cbuil06/tse/TSE_exemples.pdf

# TinyStar’Ex

# Exemples de spectres

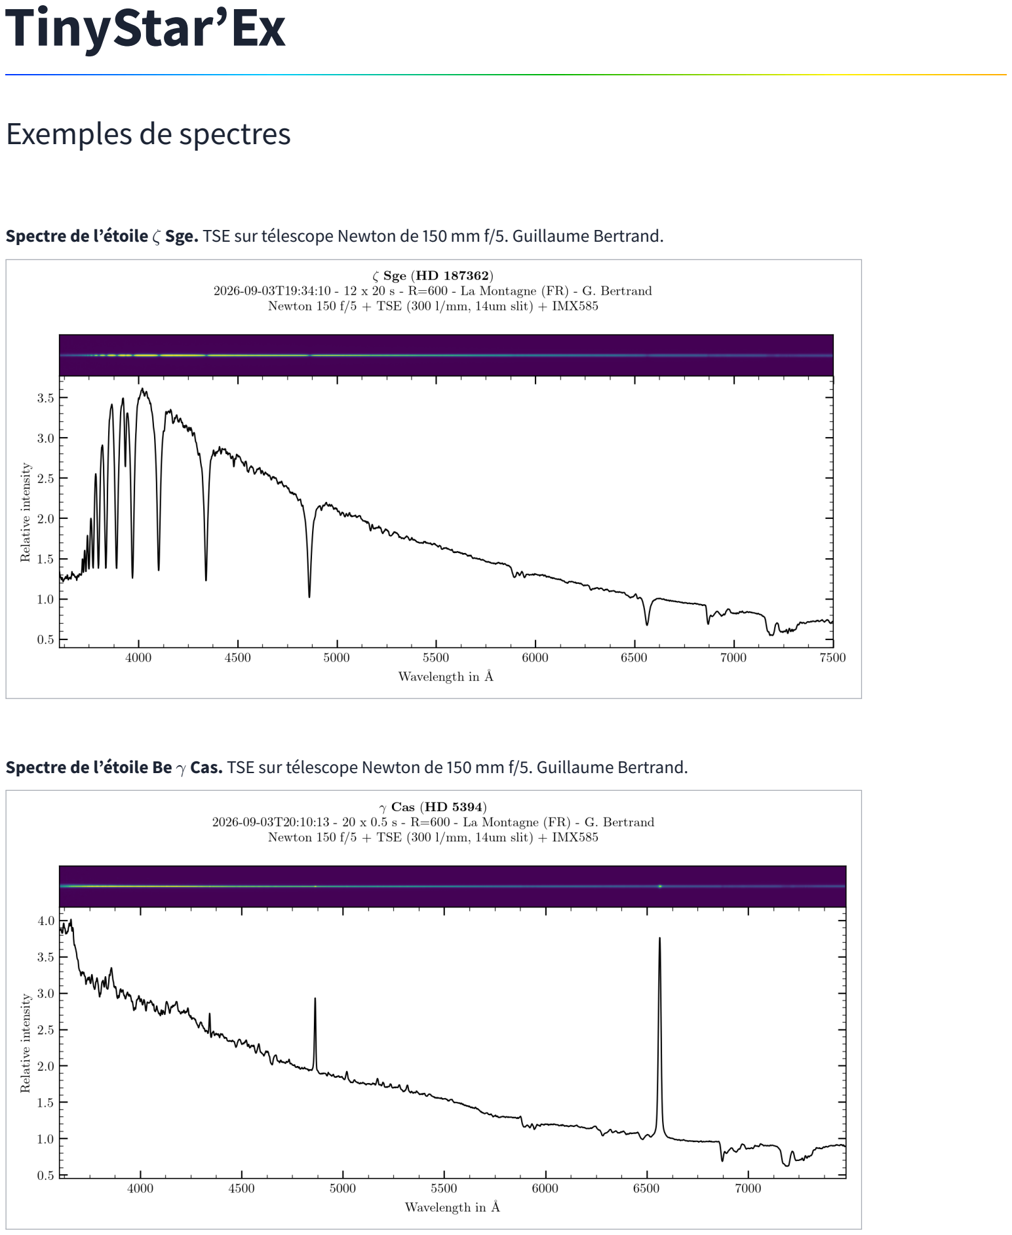
[picture p1: page 1]

Spectre de l’étoile ζ Sge. TSE sur télescope Newton de 150 mm f/5. Guillaume Bertrand.

Spectre de l’étoile Be γ Cas. TSE sur télescope Newton de 150 mm f/5. Guillaume Bertrand.

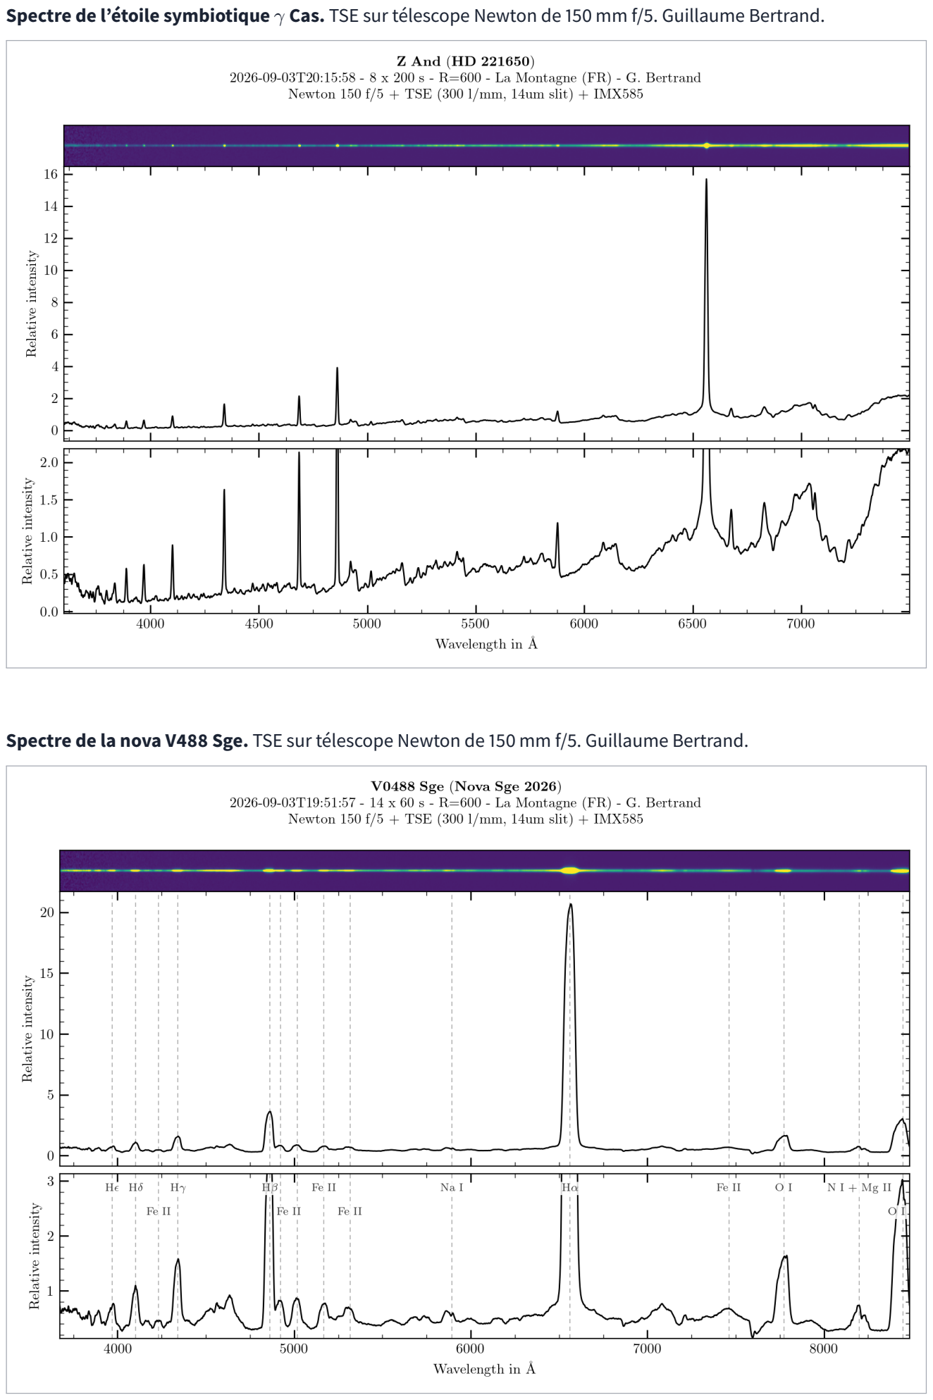
[picture p2: page 2]

Spectre de l’étoile symbiotique γ Cas. TSE sur télescope Newton de 150 mm f/5. Guillaume Bertrand.

Spectre de la nova V488 Sge. TSE sur télescope Newton de 150 mm f/5. Guillaume Bertrand.

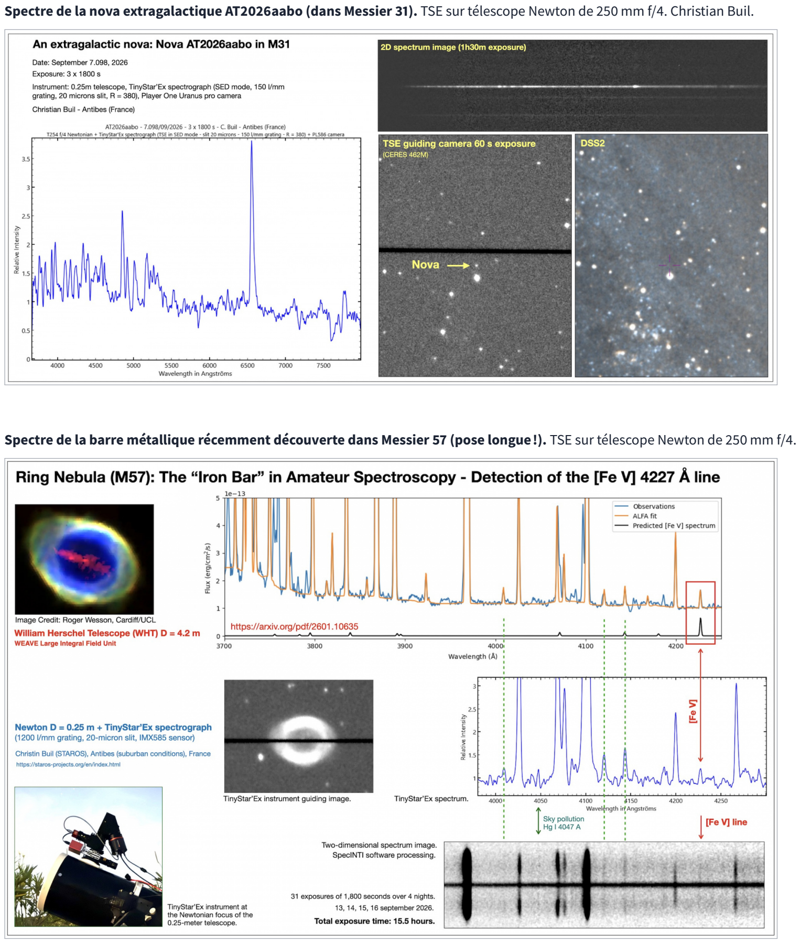
[picture p3: page 3]

Spectre de la nova extragalactique AT2026aabo (dans Messier 31). TSE sur télescope Newton de 250 mm f/4. Christian Buil.

Spectre de la barre métallique récemment découverte dans Messier 57 (pose longue !). TSE sur télescope Newton de 250 mm f/4.

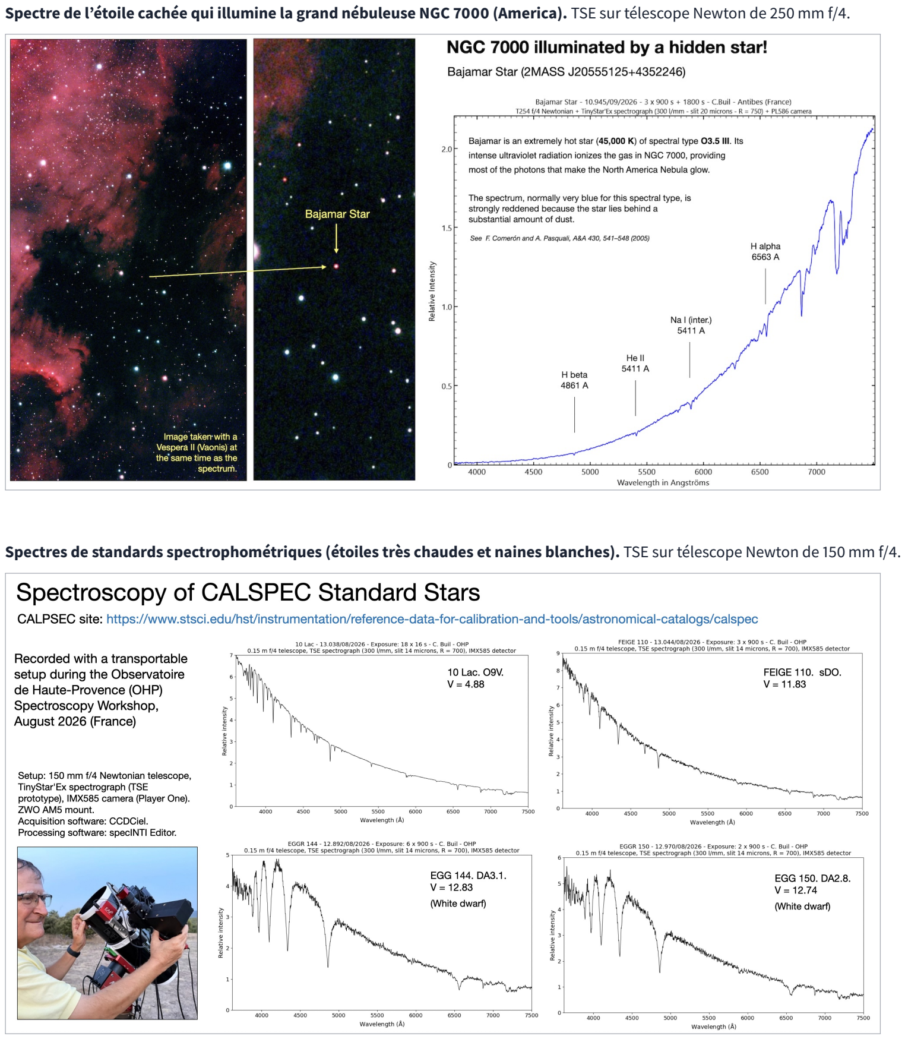
[picture p4: page 4]

Spectre de l’étoile cachée qui illumine la grand nébuleuse NGC 7000 (America). TSE sur télescope Newton de 250 mm f/4.

Spectres de standards spectrophométriques (étoiles très chaudes et naines blanches). TSE sur télescope Newton de 150 mm f/4.

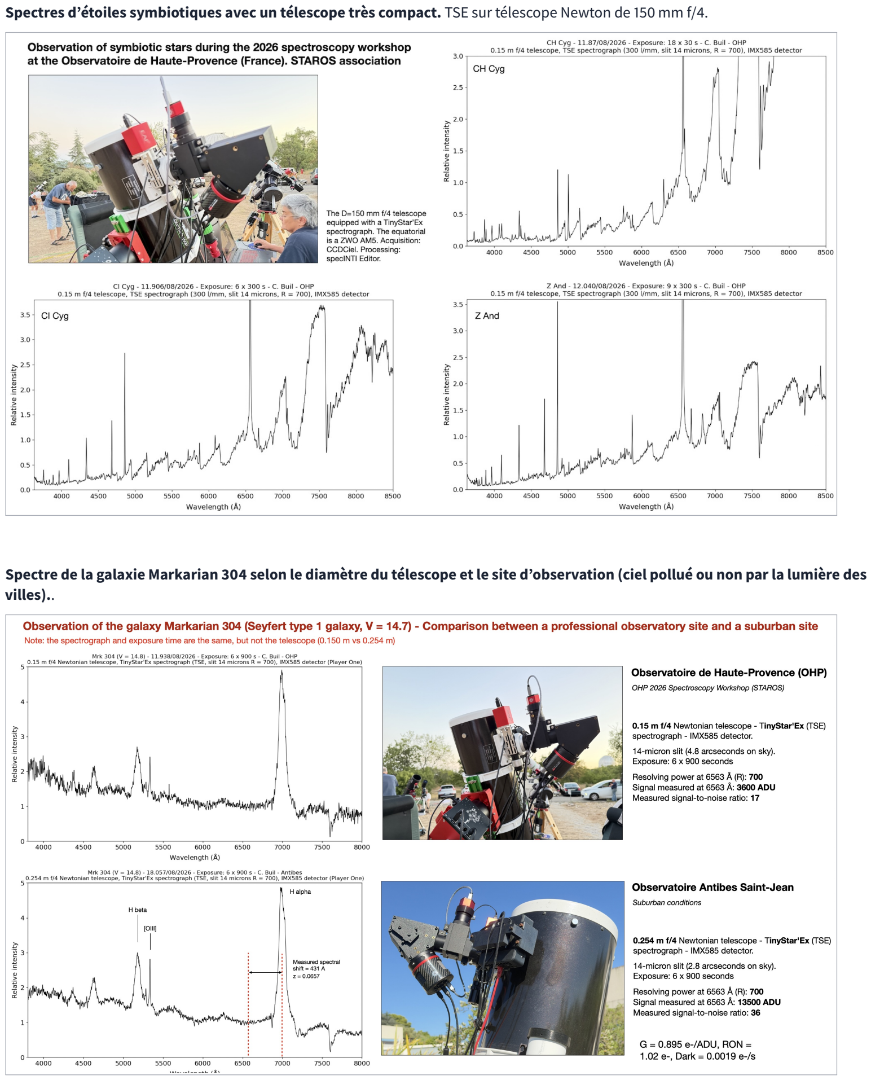
[picture p5: page 5]

Spectres d’étoiles symbiotiques avec un télescope très compact. TSE sur télescope Newton de 150 mm f/4.

Spectre de la galaxie Markarian 304 selon le diamètre du télescope et le site d’observation (ciel pollué ou non par la lumière des villes)..

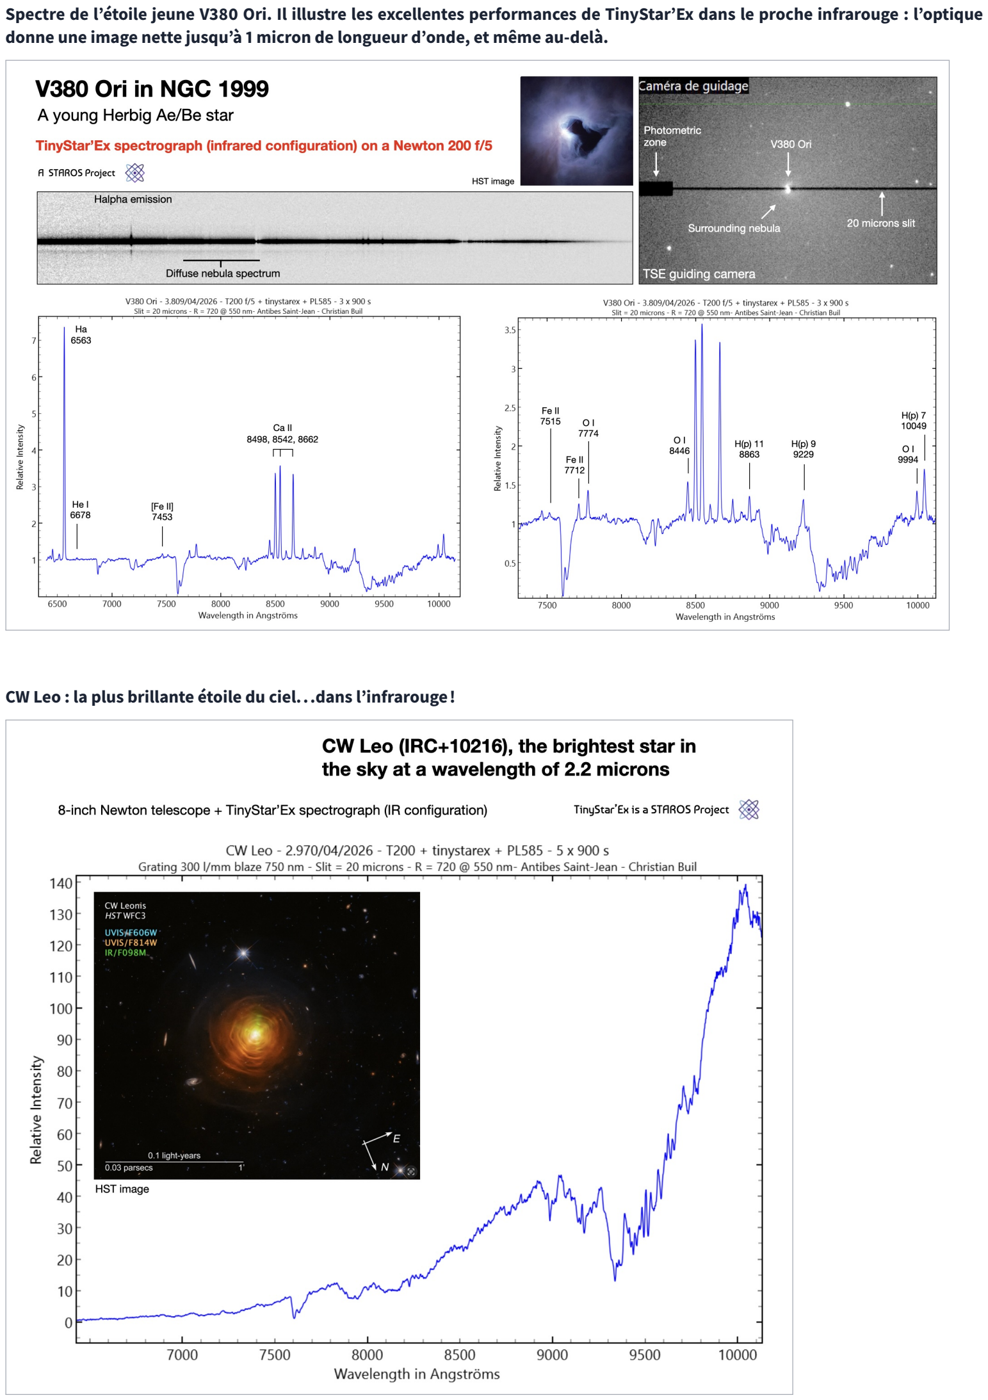
[picture p6: page 6]

Spectre de l’étoile jeune V380 Ori. Il illustre les excellentes performances de TinyStar’Ex dans le proche infrarouge : l’optique donne une image nette jusqu’à 1 micron de longueur d’onde, et même au-delà.

CW Leo : la plus brillante étoile du ciel. . .dans l’infrarouge !

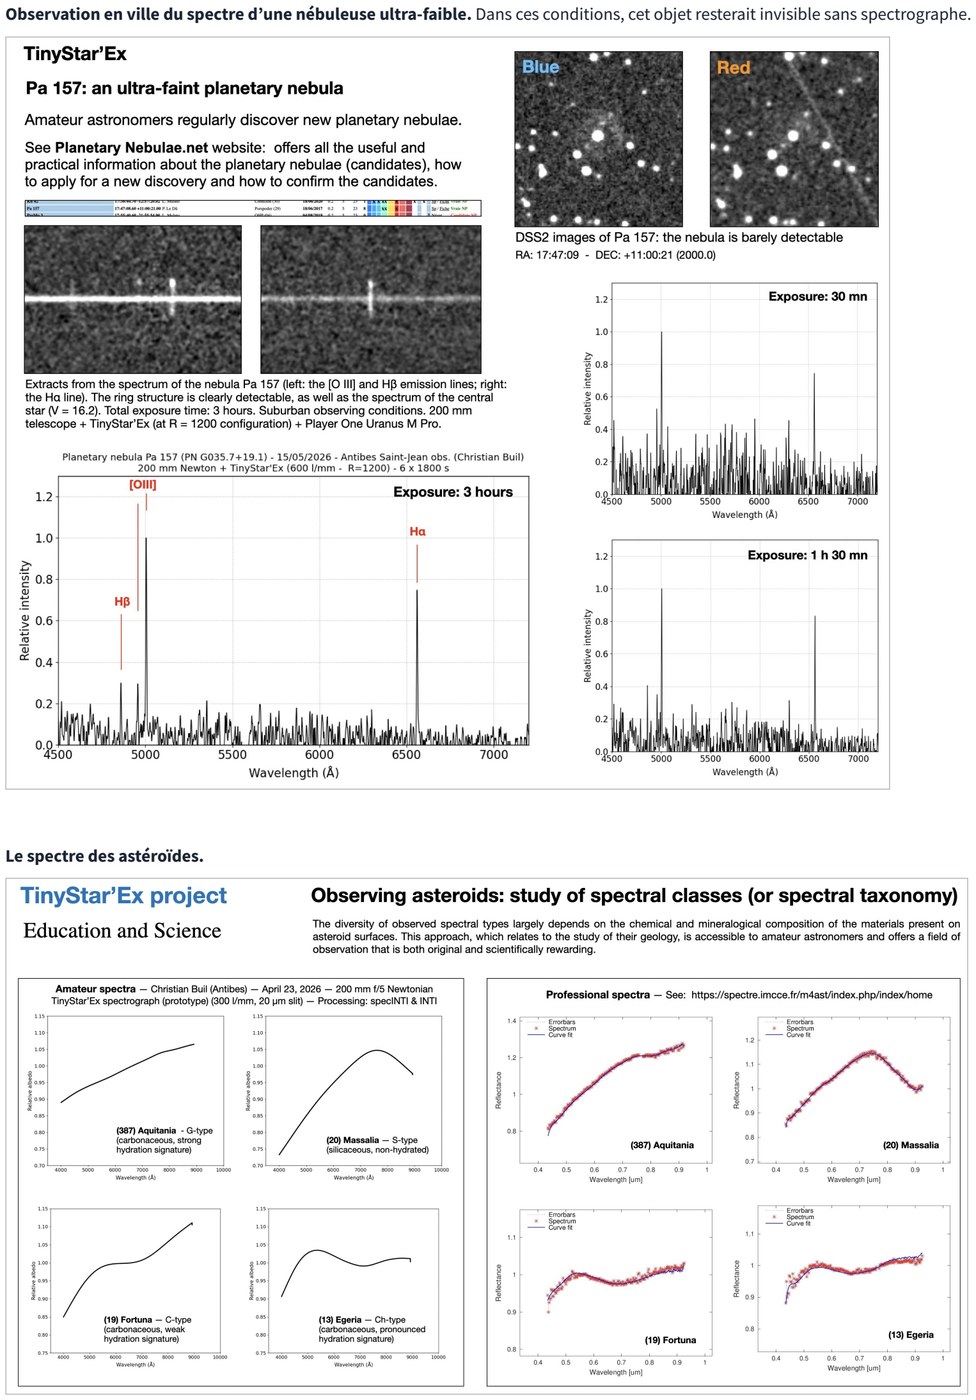
[picture p7: page 7]

Observation en ville du spectre d’une nébuleuse ultra-faible. Dans ces conditions, cet objet resterait invisible sans spectrographe.

Le spectre des astéroïdes.

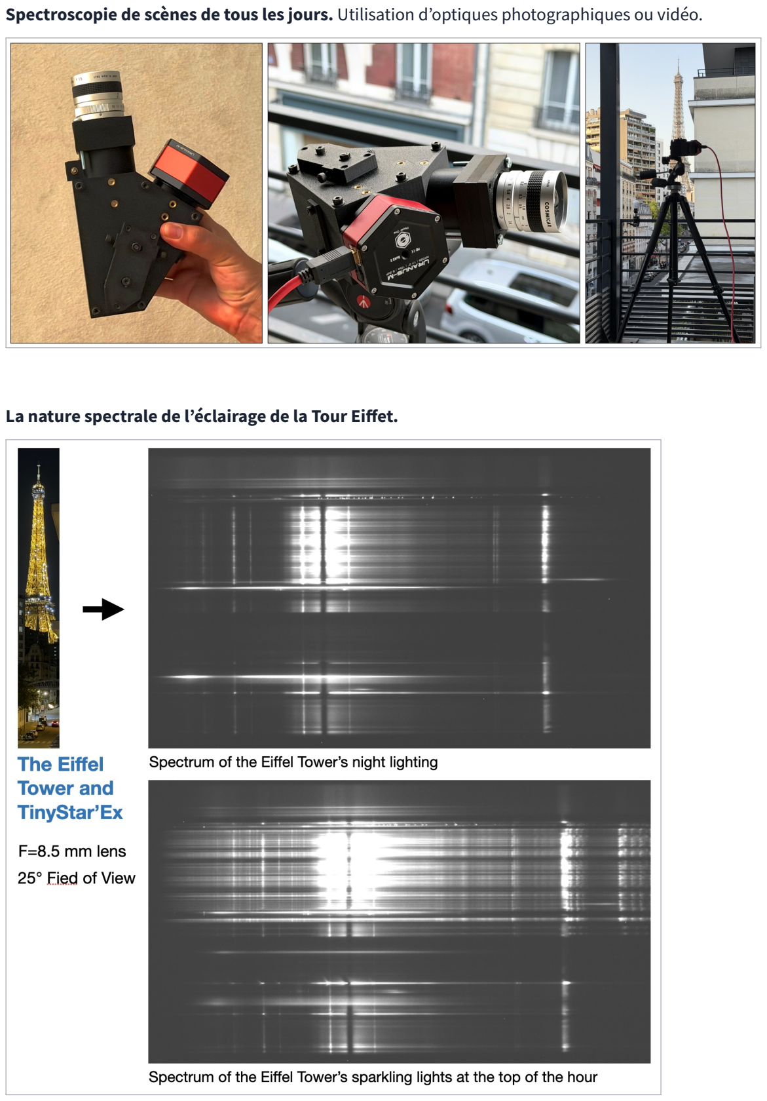
[picture p8: page 8]

Spectroscopie de scènes de tous les jours. Utilisation d’optiques photographiques ou vidéo.

La nature spectrale de l’éclairage de la Tour Eiet.

Adaptateur imprimé en 3D permettant d’éclairer la fente d’entrée avec la sortie d’une fibre optique. Il s’agit ici d’un guide de lumière en plastique très économique, de 5 mm de diamètre, vendu pour l’éclairage décoratif et que l’on coupe à la longueur voulue avec une simple paire de ciseaux. Idéal pour des expériences de physique, à l’école ou ailleurs, pour capter la lumière des sources les plus diverses en vue d’une analyse spectrale, ou tout simplement pour se familiariser avec les techniques de la spectroscopie.

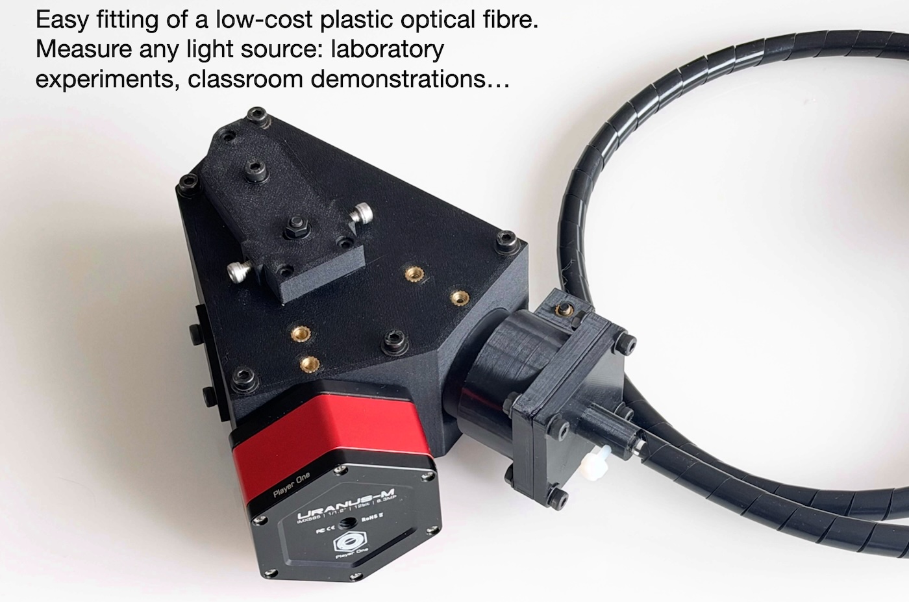
[picture p9: figure]

Exemple d’utilisation d’une fibre optique : comparaison des spectres produits par des écrans et des lampes à LED. Les images des spectres ont été colorisées a posteriori. Pour cette démonstration, la réponse spectrale de l’instrument n’a pas été corrigée : il s’agit donc de données brutes, telles qu’on les voit en direct, sans traitement.

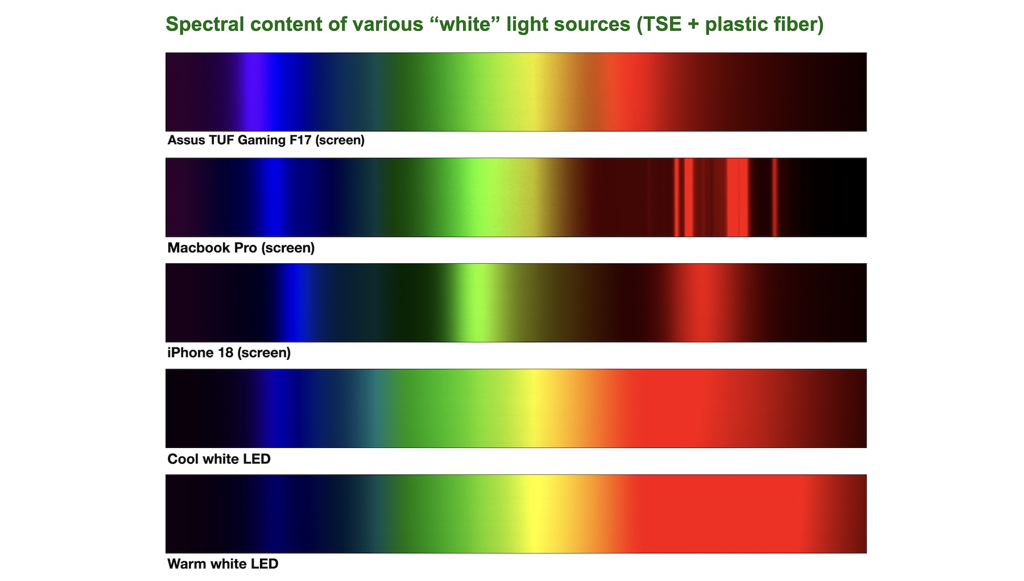
[picture p10: figure]

Observation de cibles très faibles en ville, avec une caméra non refroidie. La spectroscopie compacte, économique et partout!

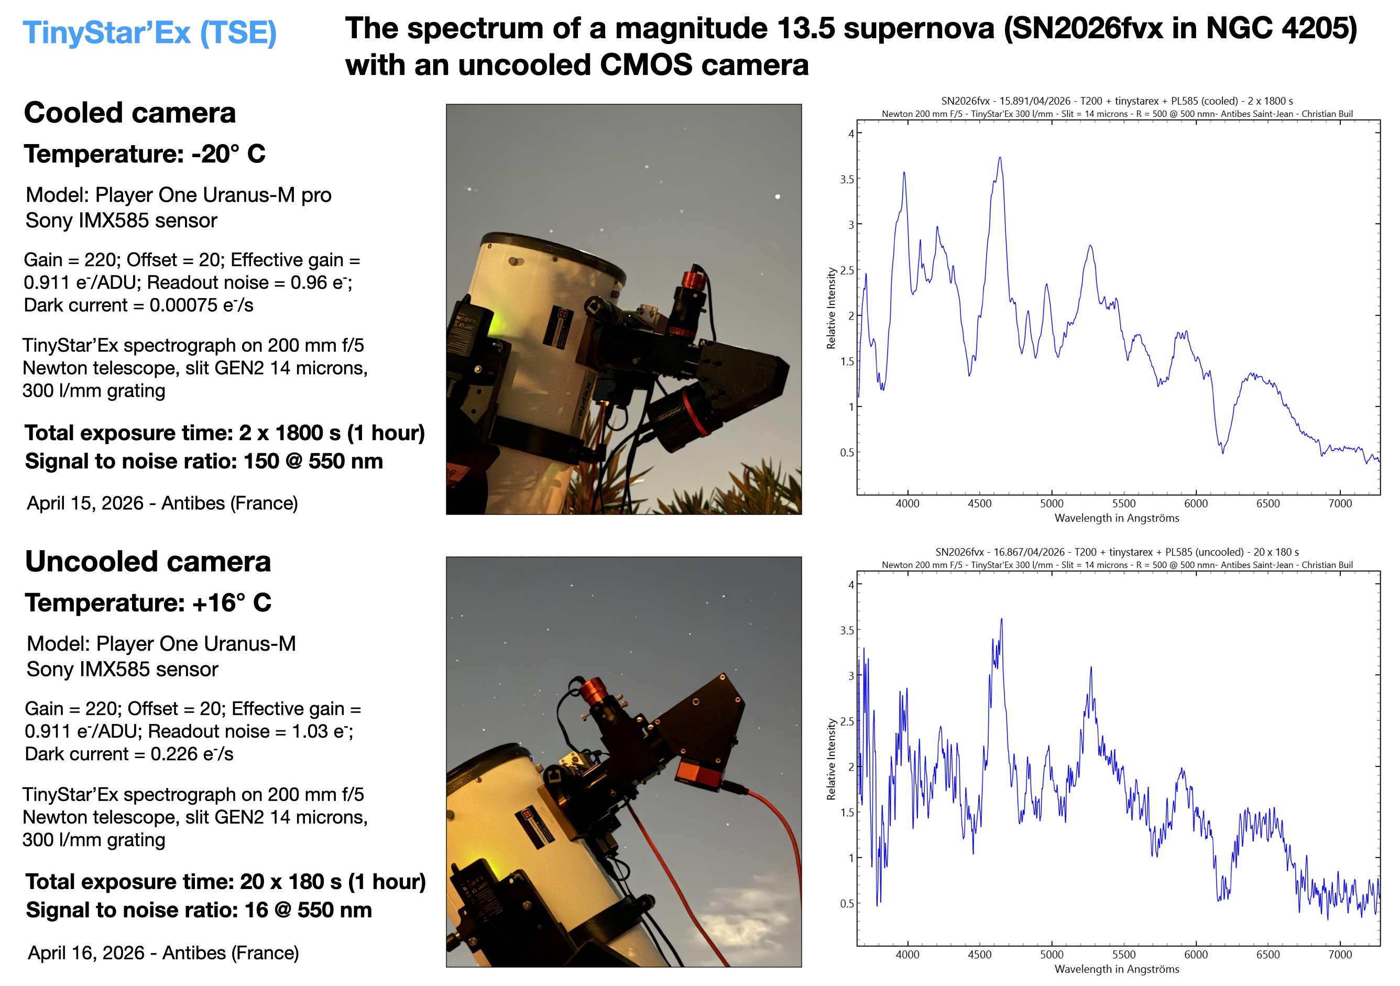
[picture p11: figure]
