cbuil06/tse/TSE_exemples_en.pdf

# TinyStar’Ex

# Examples of spectra

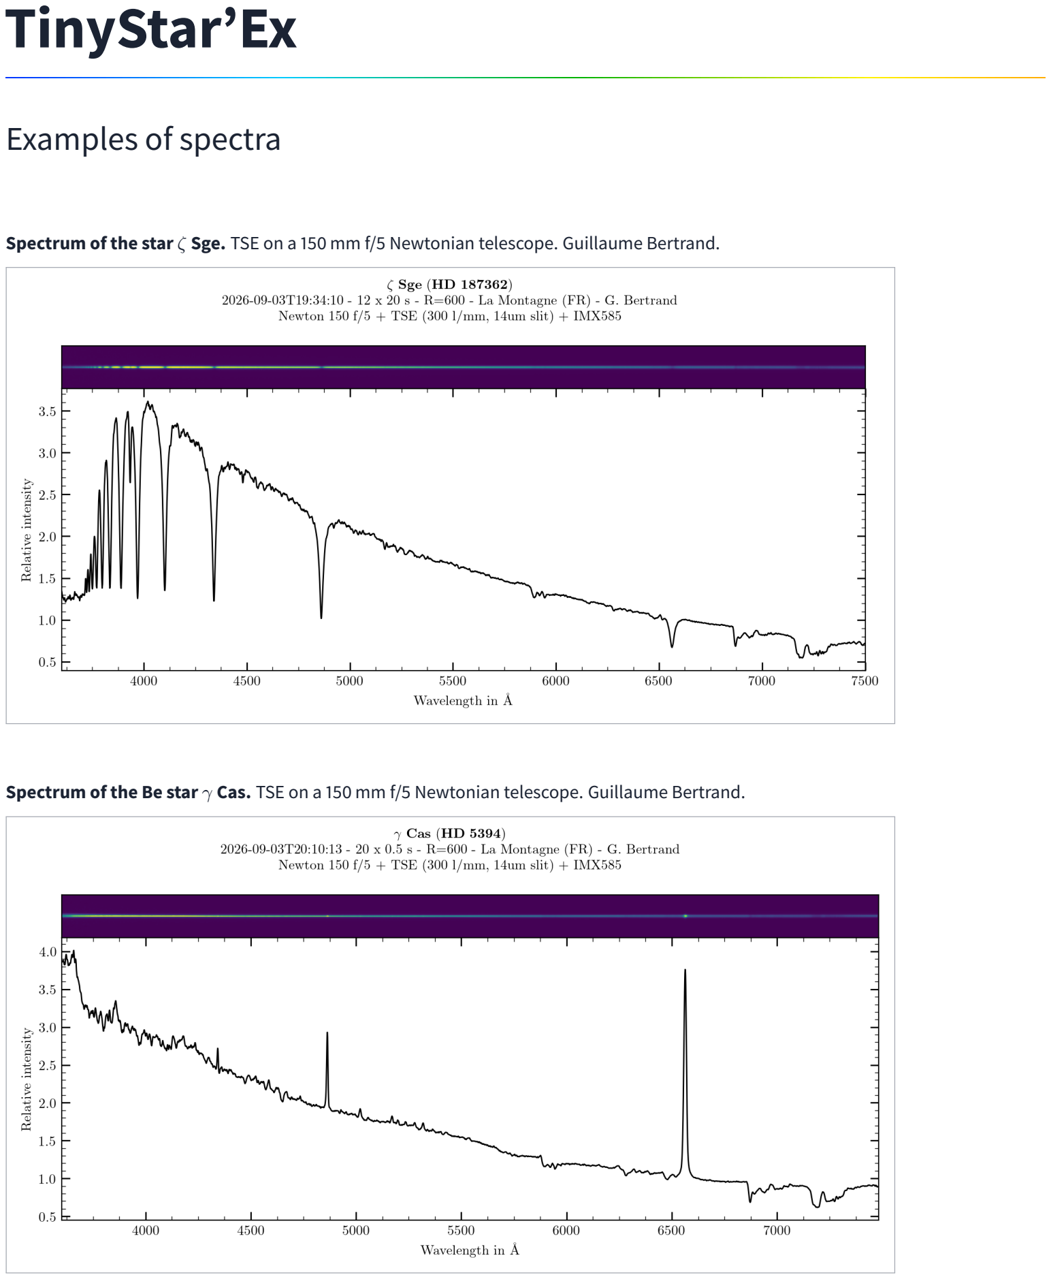
[picture p12: page 1]

Spectrum of the star ζ Sge. TSE on a 150 mm f/5 Newtonian telescope. Guillaume Bertrand.

Spectrum of the Be star γ Cas. TSE on a 150 mm f/5 Newtonian telescope. Guillaume Bertrand.

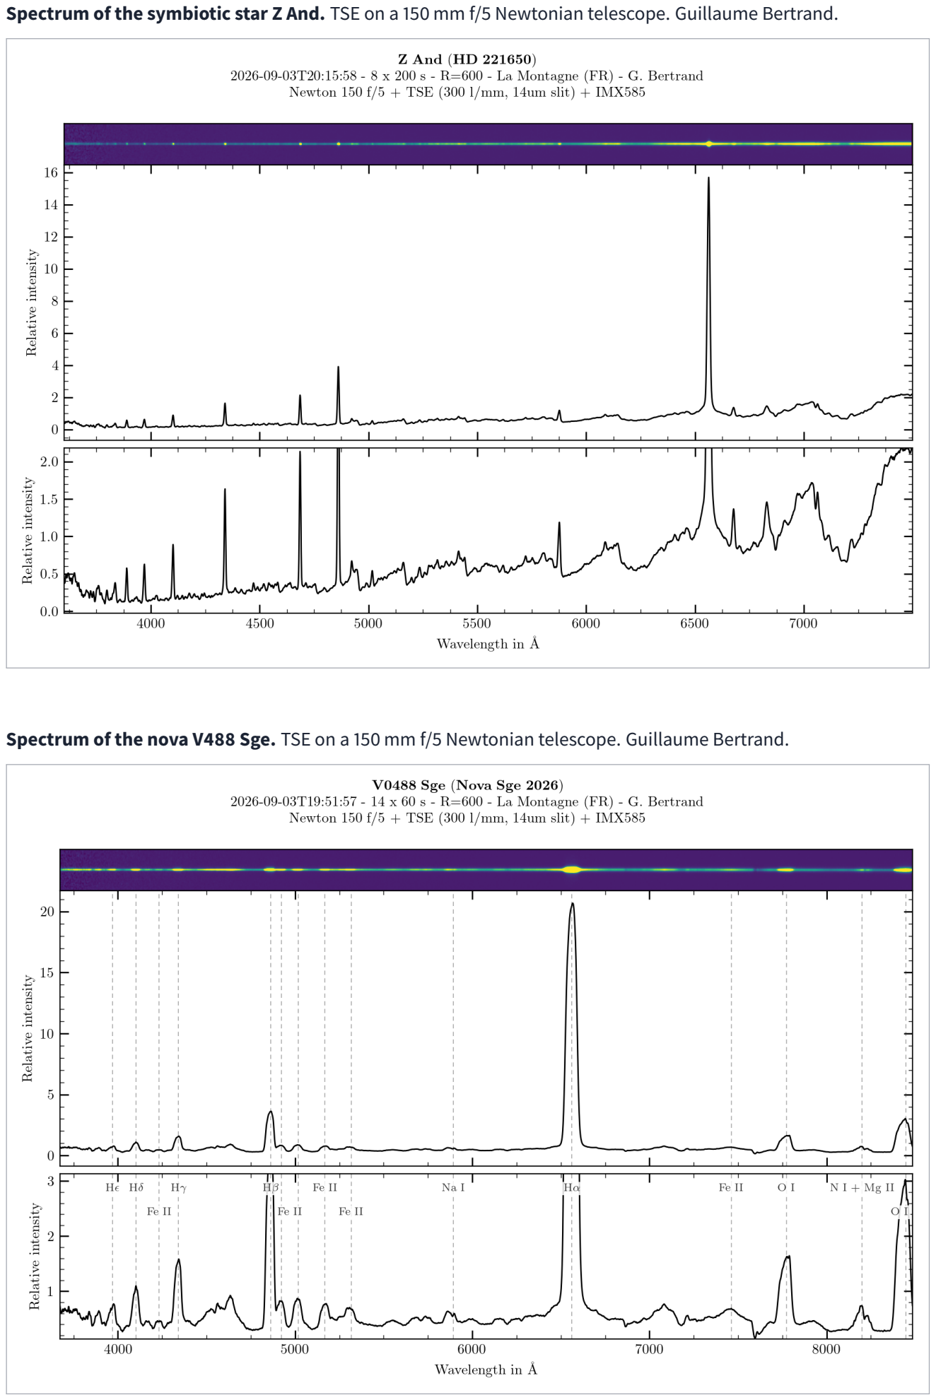
[picture p13: page 2]

Spectrum of the symbiotic star Z And. TSE on a 150 mm f/5 Newtonian telescope. Guillaume Bertrand.

Spectrum of the nova V488 Sge. TSE on a 150 mm f/5 Newtonian telescope. Guillaume Bertrand.

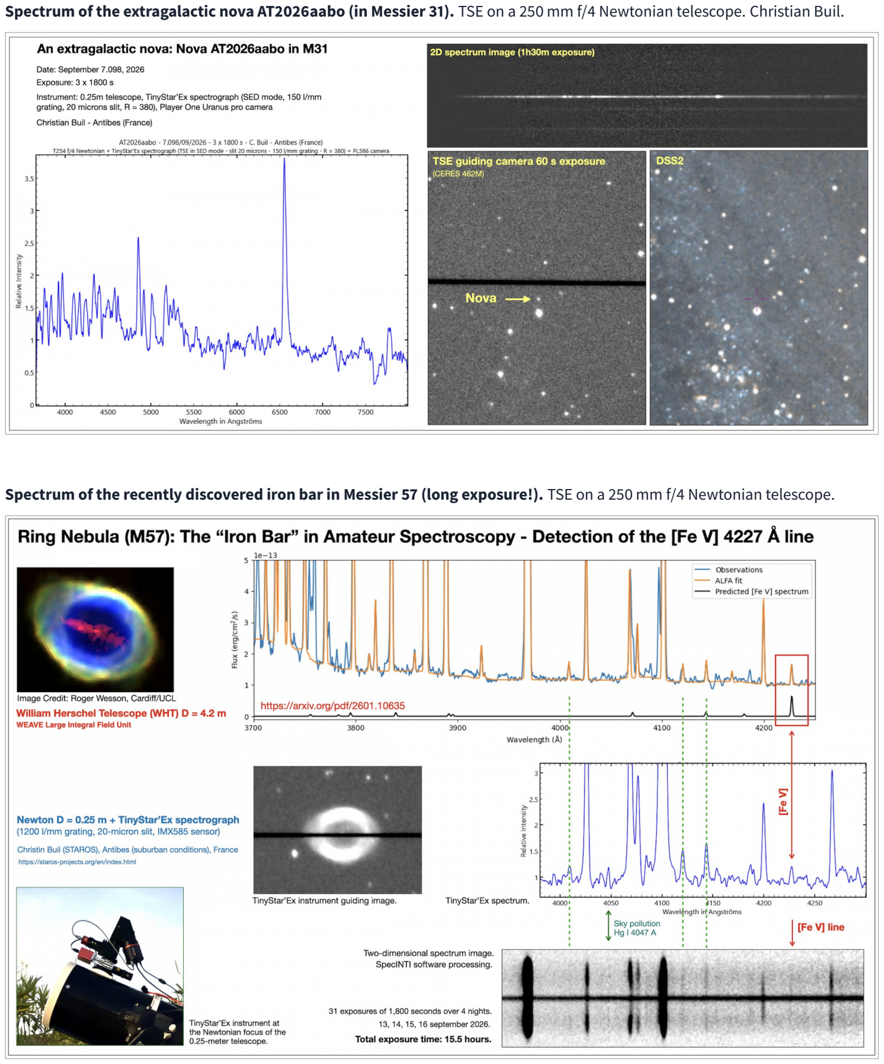
[picture p14: page 3]

Spectrum of the extragalactic nova AT2026aabo (in Messier 31). TSE on a 250 mm f/4 Newtonian telescope. Christian Buil.

Spectrum of the recently discovered iron bar in Messier 57 (long exposure!). TSE on a 250 mm f/4 Newtonian telescope.

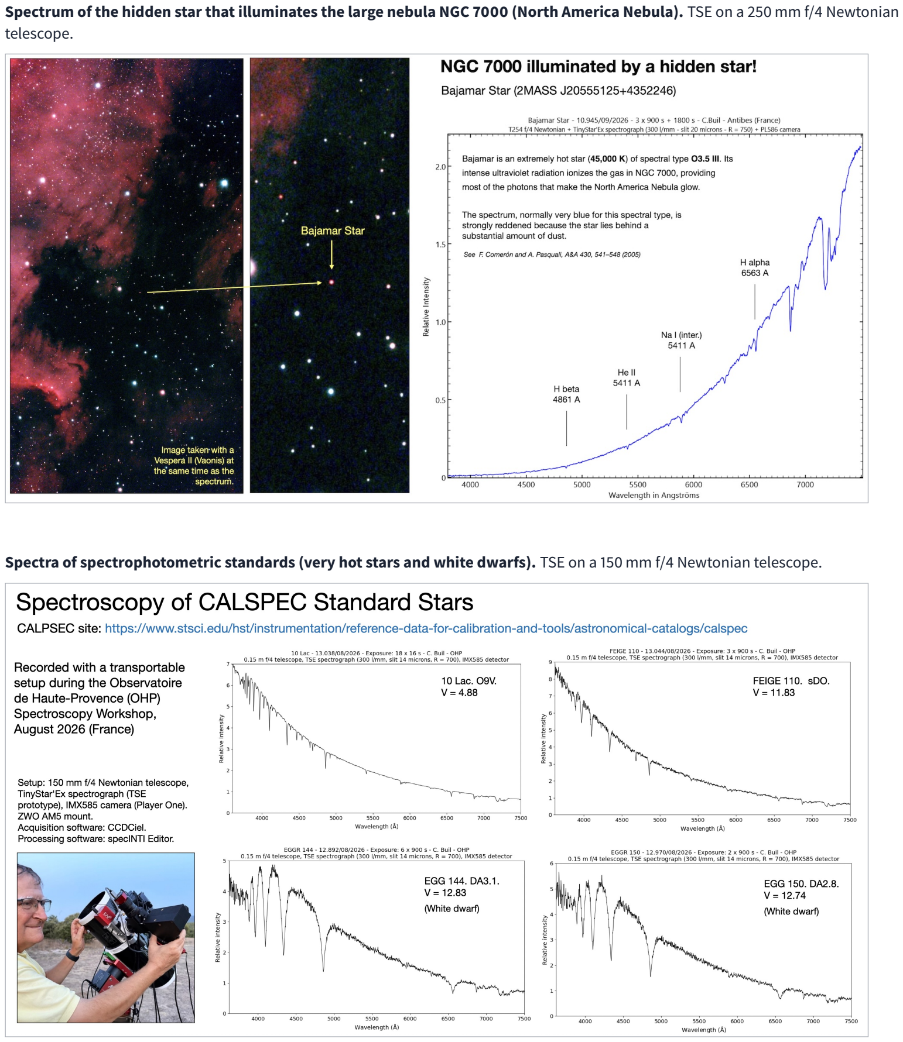
[picture p15: page 4]

Spectrum of the hidden star that illuminates the large nebula NGC 7000 (North America Nebula). TSE on a 250 mm f/4 Newtonian telescope.

Spectra of spectrophotometric standards (very hot stars and white dwarfs). TSE on a 150 mm f/4 Newtonian telescope.

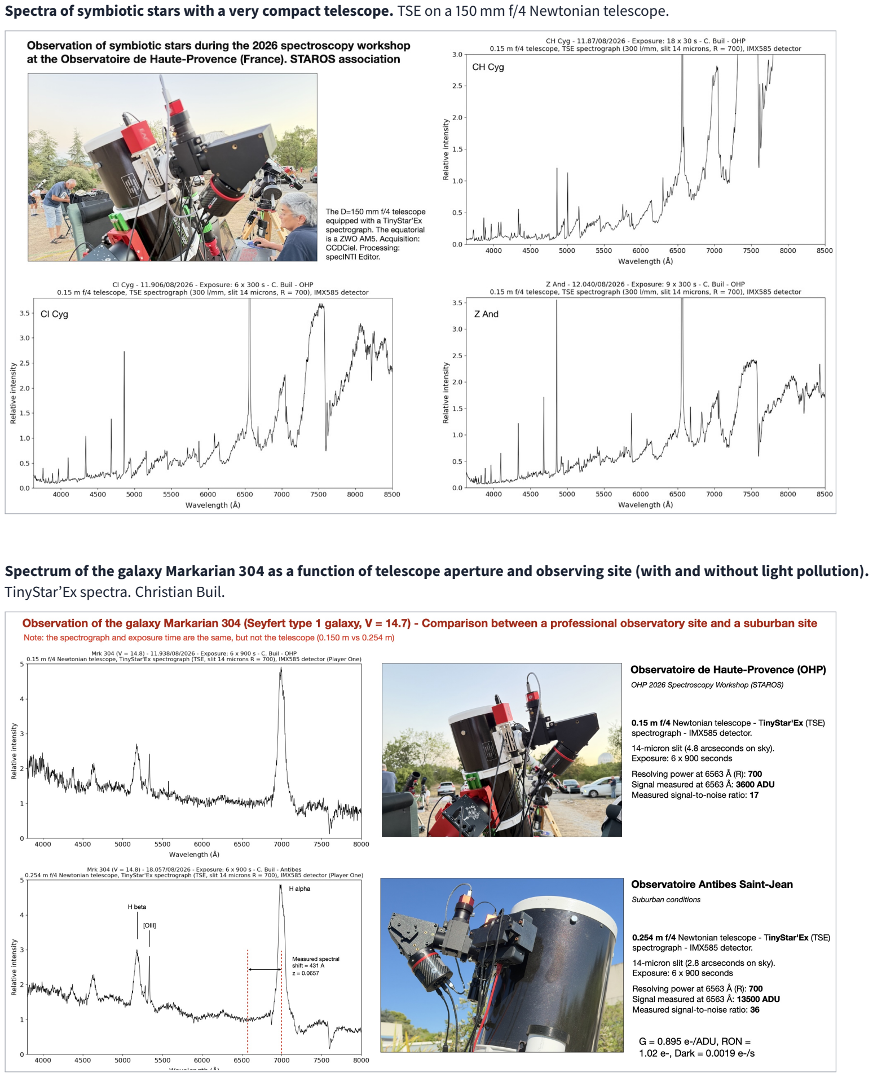
[picture p16: page 5]

Spectra of symbiotic stars with a very compact telescope. TSE on a 150 mm f/4 Newtonian telescope.

Spectrum of the galaxy Markarian 304 as a function of telescope aperture and observing site (with and without light pollution). TinyStar’Ex spectra. Christian Buil.

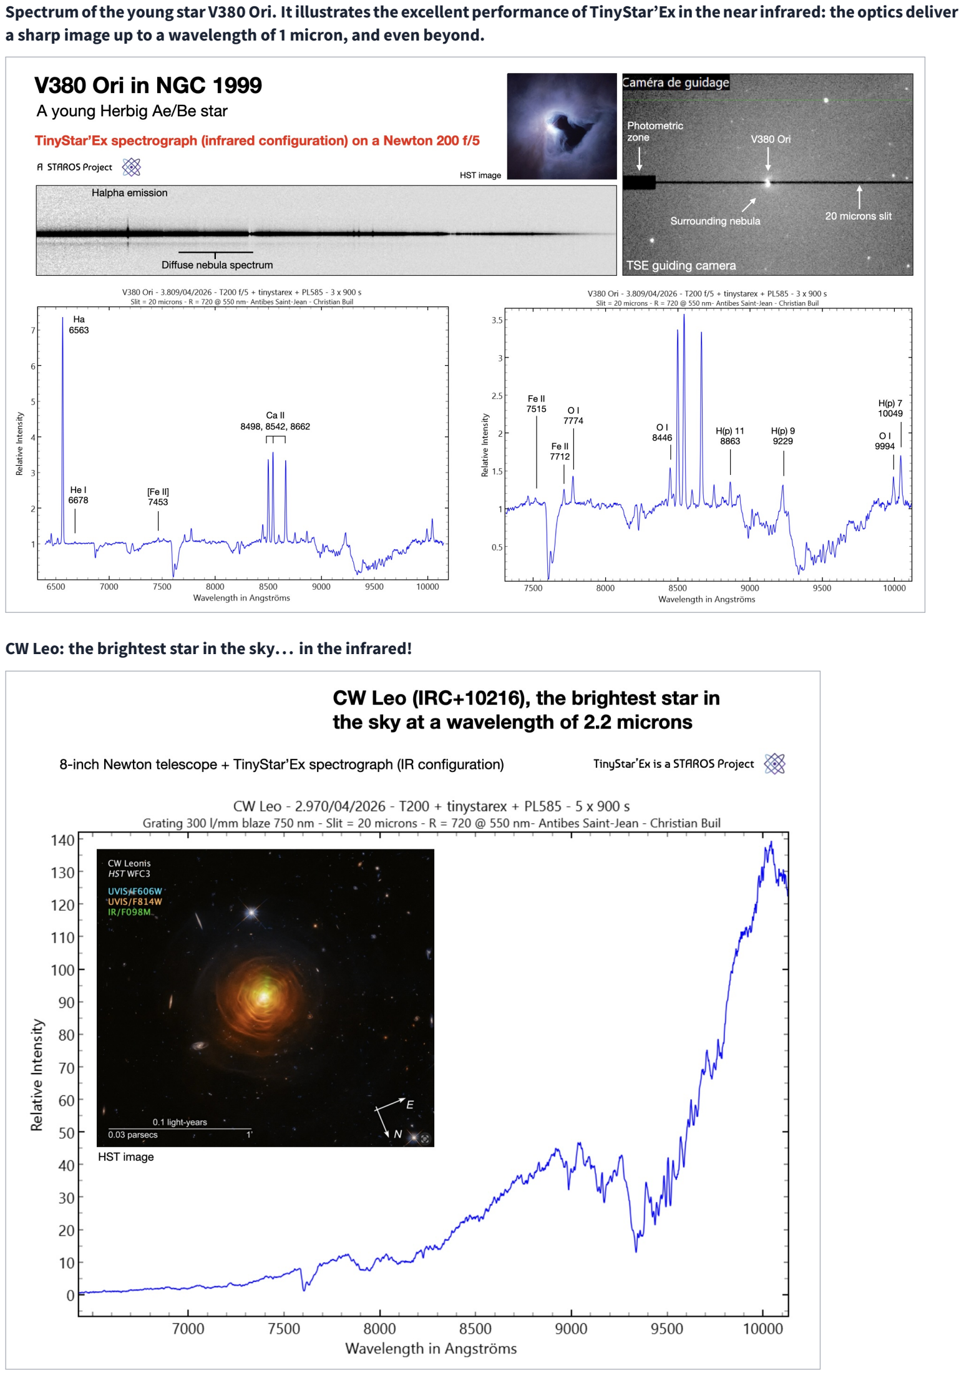
[picture p17: page 6]

Spectrum of the young star V380 Ori. It illustrates the excellent performance of TinyStar’Ex in the near infrared: the optics deliver a sharp image up to a wavelength of 1 micron, and even beyond.

CW Leo: the brightest star in the sky. . . in the infrared!

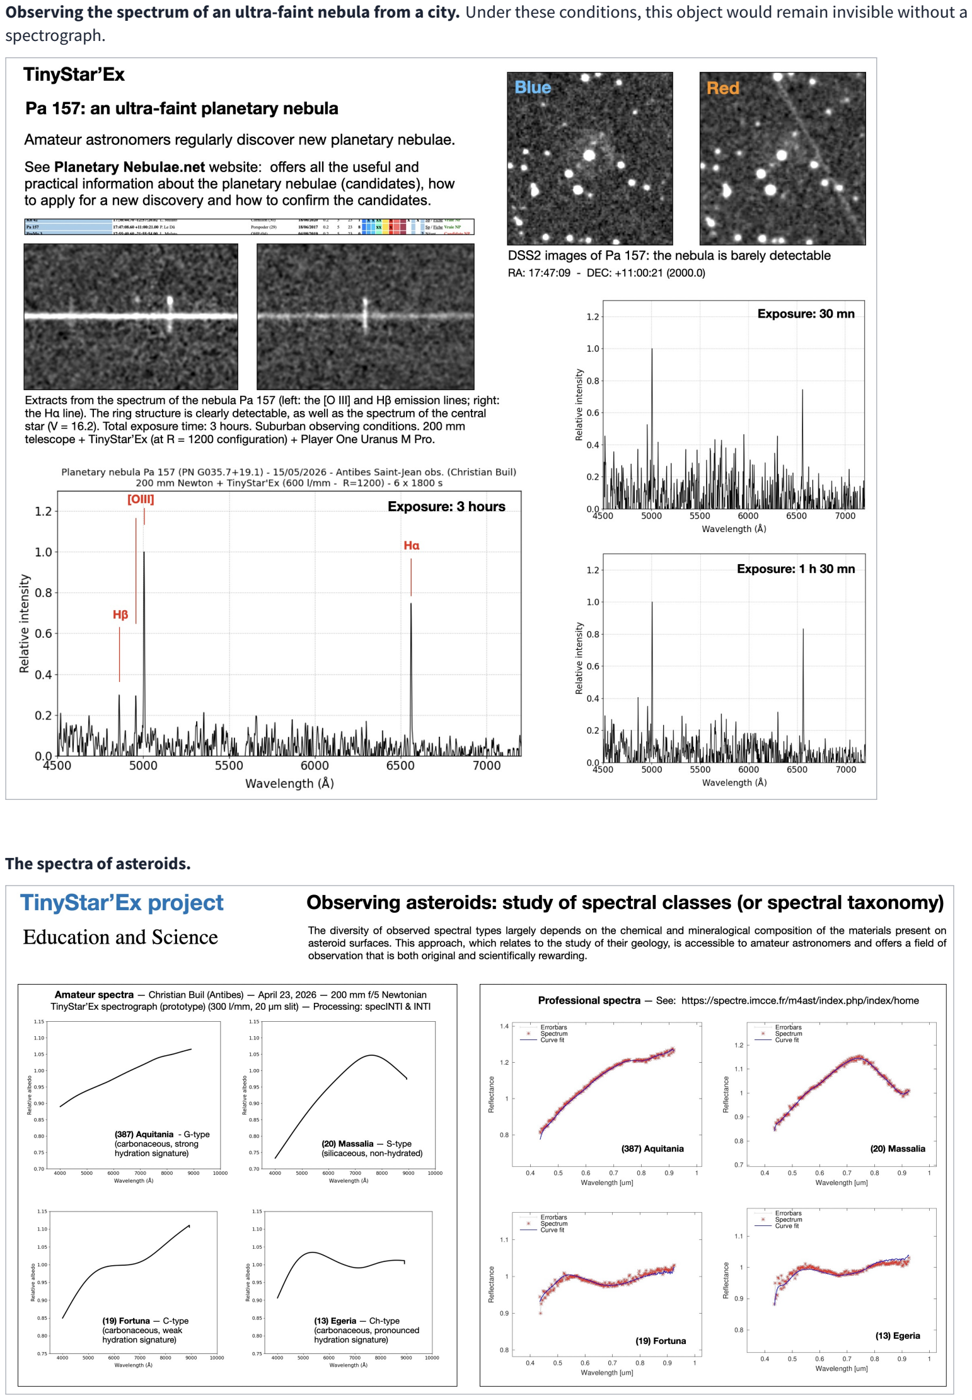
[picture p18: page 7]

Observing the spectrum of an ultra-faint nebula from a city. Under these conditions, this object would remain invisible without a spectrograph.

The spectra of asteroids.

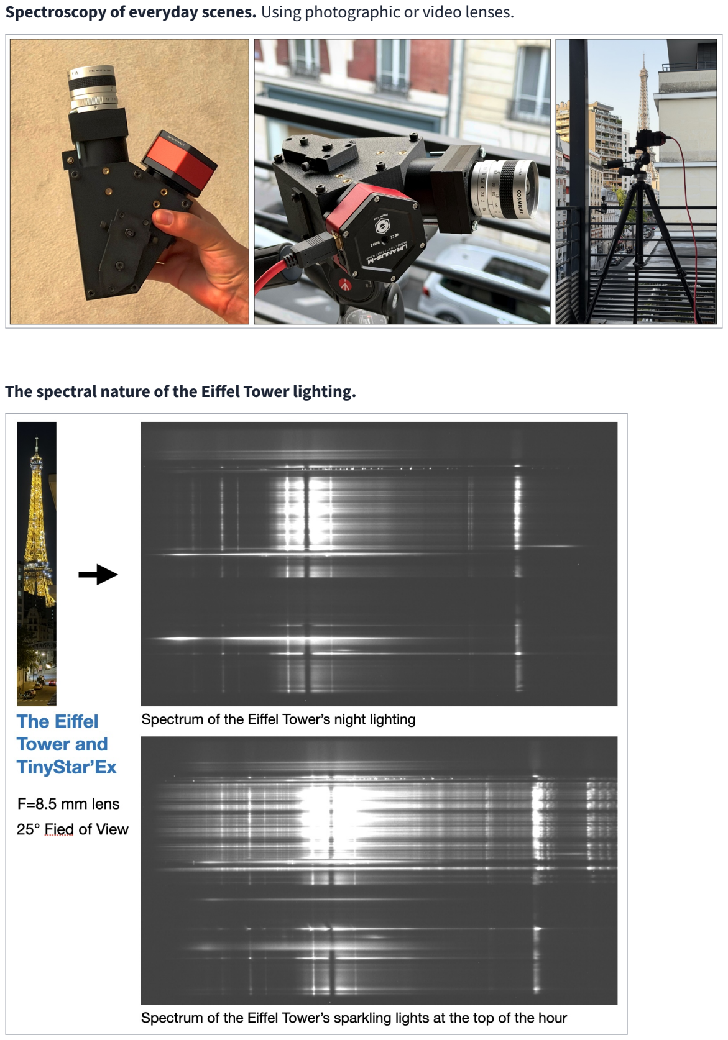
[picture p19: page 8]

Spectroscopy of everyday scenes. Using photographic or video lenses.

The spectral nature of the Eiel Tower lighting.

3D-printed adapter for illuminating the entrance slit with the output of an optical fibre. Here, a very inexpensive plastic light guide, 5 mm in diameter, sold for decorative lighting and easily cut to the required length with an ordinary pair of scissors. Ideal for physics experiments, at school or elsewhere, for collecting light from a wide variety of sources for spectral analysis, or simply for getting to grips with the techniques of spectroscopy.


Example of use of an optical fibre: comparison of the spectra produced by screens and LED lamps. The spectrum images were colourized aerwards. For this demonstration, the spectral response of the instrument has not been corrected: these are therefore raw data, as seen live, without any processing.

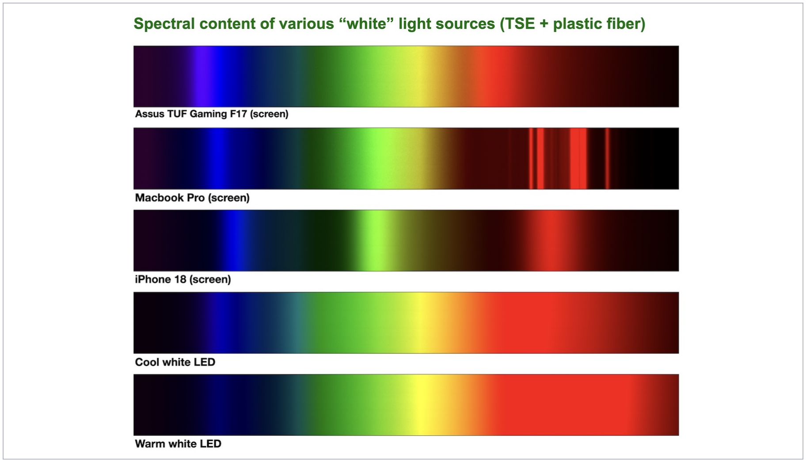
[picture p20: figure]

Observing very faint targets from a city, with an uncooled camera. Compact, aordable spectroscopy, anywhere!
