cbuil06/tse/TSE_notice_fabrication_spectrographe_en.pdf

# TinyStar’Ex

# Spectrograph build and assembly guide

Version 1.1

A STAROS project

staros-projects.org

## 1 Purpose

This document is the build, assembly and adjustment guide for the TinyStar’Ex (TSE) spectrograph. Figure 1 shows the nished instrument and gives an idea of its scale (the pointing system and the cameras are not tted).

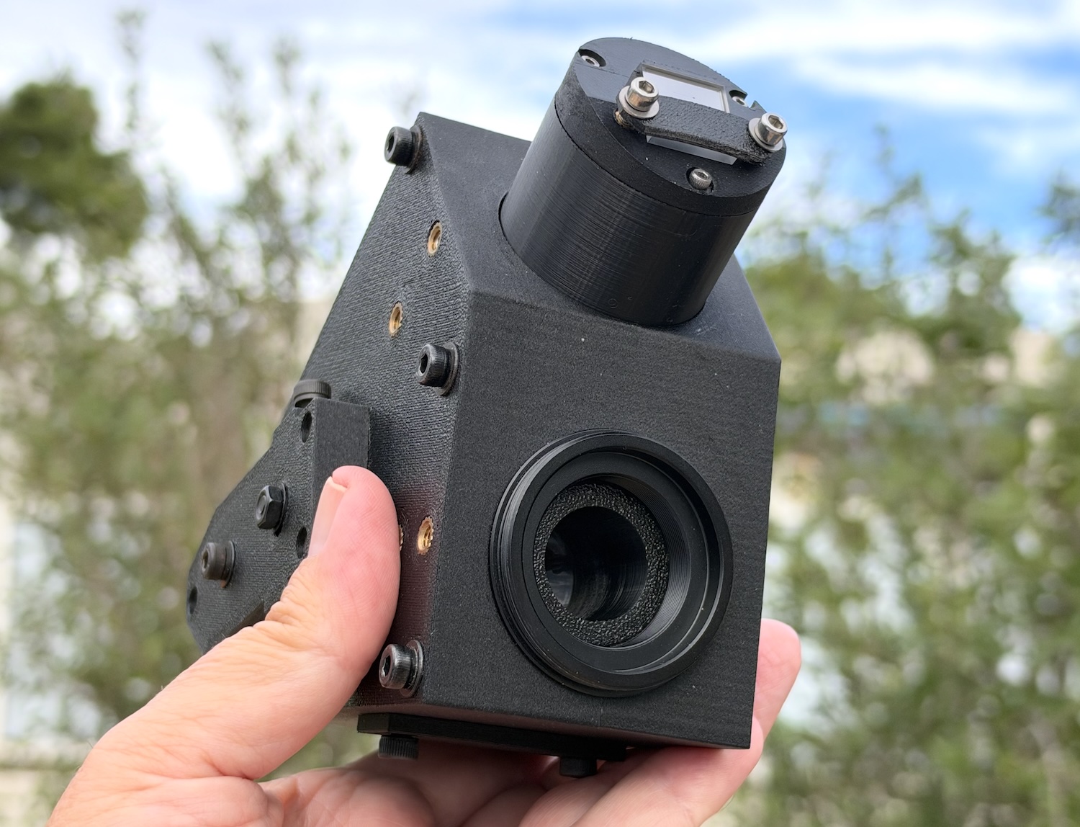
[picture p34: figure]

Figure 1. The TinyStar’Ex (TSE) spectrograph unit held in the hand.

The front of the spectrograph is a tube 40 mm in diameter (39.75 mm, to be precise) that carries the entrance slit. This tube also serves as the ‘universal’ interface of the TSE system, onto which accessories can be tted (Figure 2).

TinyStar’Ex – Spectrograph build guide | 1

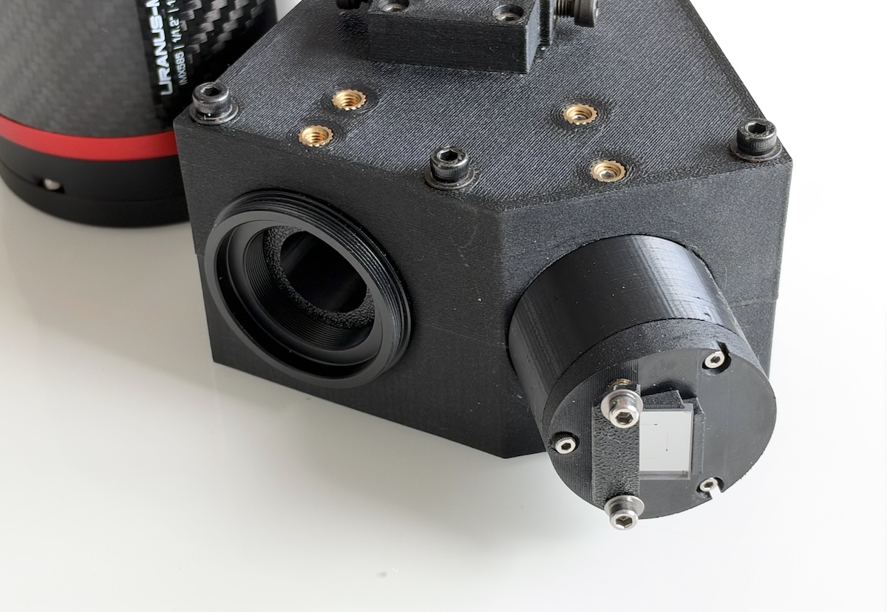
[picture p35: figure]

Figure 2. The front of the spectrograph carries a four-position slit, oering a choice of four widths. The rear is a standard male T2 interface that accepts any type of camera.

One of these accessories is essential for a fully operational instrument on the sky: the system for pointing at the target and guiding on the slit. Its construction is described in a separate document.

The rear of the instrument is a male T2 threaded interface. Any camera with a back focal distance of 17.5 mm, a standard value, can be tted there and used directly to record spectra.

A video shows the main stages of the assembly (but do read this manual carefully too!):

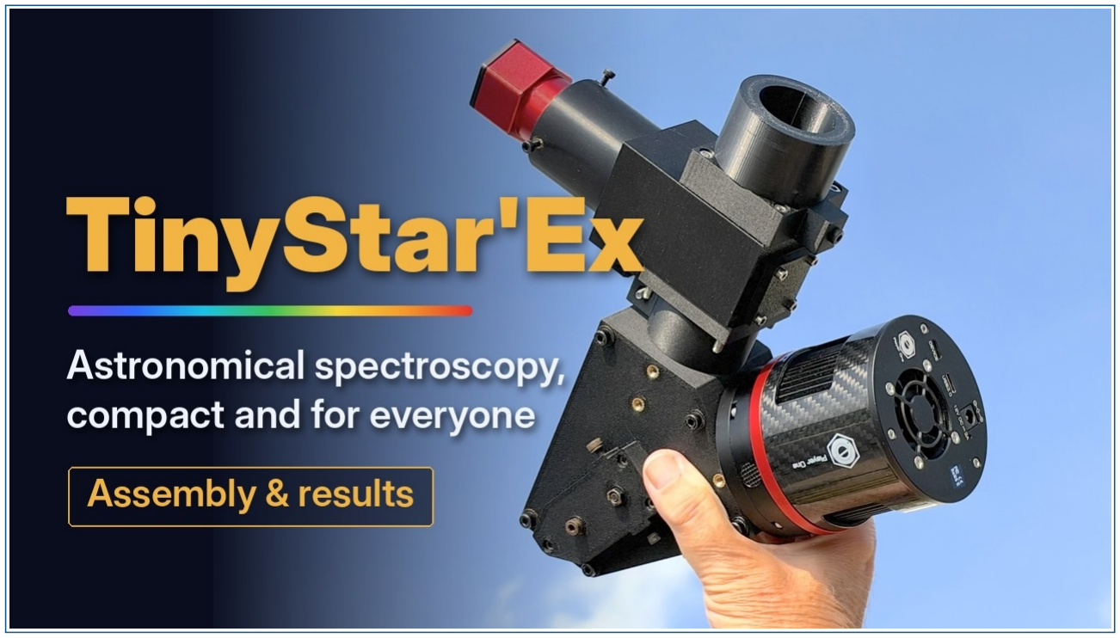
[picture p36: figure]

Figure 3. Click on the image to watch the TinyStar’Ex assembly video: https://youtu.be/nrCZCETCJ2A

## 2 Licence

The TinyStar’Ex (TSE) project is released under an open licence that protects the rights of both users and authors. It keeps the project open and accessible, while respecting the work of all its contributors.

The TinyStar’Ex design les (STL print les, OpenSCAD sources and instruction manuals) are licensed under the Creative Commons Attribution–NonCommercial–ShareAlike 4.0 International licence (CC BY-NC-SA 4.0). The optical kit, which is sold commercially, is not covered by this licence.

You are free to use, copy, modify and redistribute these les under the following conditions:

- Attribution: you must credit the authors (STAROS Projects) whenever you share or modify the les, indicate whether changes have been made, and provide a link to the licence;
- NonCommercial: the les may not be used for commercial purposes without prior permis-sion from STAROS Projects. For example, selling parts printed from these les constitutes commercial use;
- ShareAlike: if you modify the les and distribute the result, you must do so under the same CC BY-NC-SA 4.0 licence.

The les are provided ‘as is’, without warranty of any kind, express or implied. The authors cannot be held liable for any damage arising from their use.

In short, anyone may freely download, print, adapt and share the TinyStar’Ex designs for personal, educational or non-prot use, provided the authors are credited and the designs are not exploited commercially.

A summary of the licence and its full legal text are available at: https://creativecommons.org/licenses/by-nc-sa/4.0/ (https://creativecommons.org/licenses/by-nc-sa/4.0/)

## 3 Internal layout of the spectrograph

TinyStar’Ex uses a so-called ‘classical’ optical design, the same as that of the Star’Ex LR and Star’Ex HR spectrographs, but in a more compact form.

In TinyStar’Ex, the collimator lens and the camera lens are identical. They are doublets made of special glasses that give them high optical performance in terms of achromatism, image sharpness and eld coverage. These lenses have a focal length of 50 mm and a diameter of 20 mm.

The nominal diraction grating is a 300 lines/mm model, blazed in the visible, measuring 12.7 × 12.7 mm and 6 mm thick¹

Figure 4 details the optical layout and the dimensions of the elements.

1
The mechanical design of TinyStar’Ex allows the angle of incidence on the grating to be adjusted over a limited range, so that the spectrum can be centred precisely in wavelength on the detector. It is also entirely possible to change the grating, for example to switch to a very low resolution mode with a 150 lines/mm grating, known as SED mode (‘Spectral Energy Distribution’). Spectral resolution can also be increased, over a narrower spectral range, by adopting a ruled grating of 600 lines/mm, or even 1200 lines/mm. A grating 25 mm square can even replace the standard 12.7 mm grating. All these options involving a change of grating, however, require specic holders to be printed, and their use is not covered in this guide.

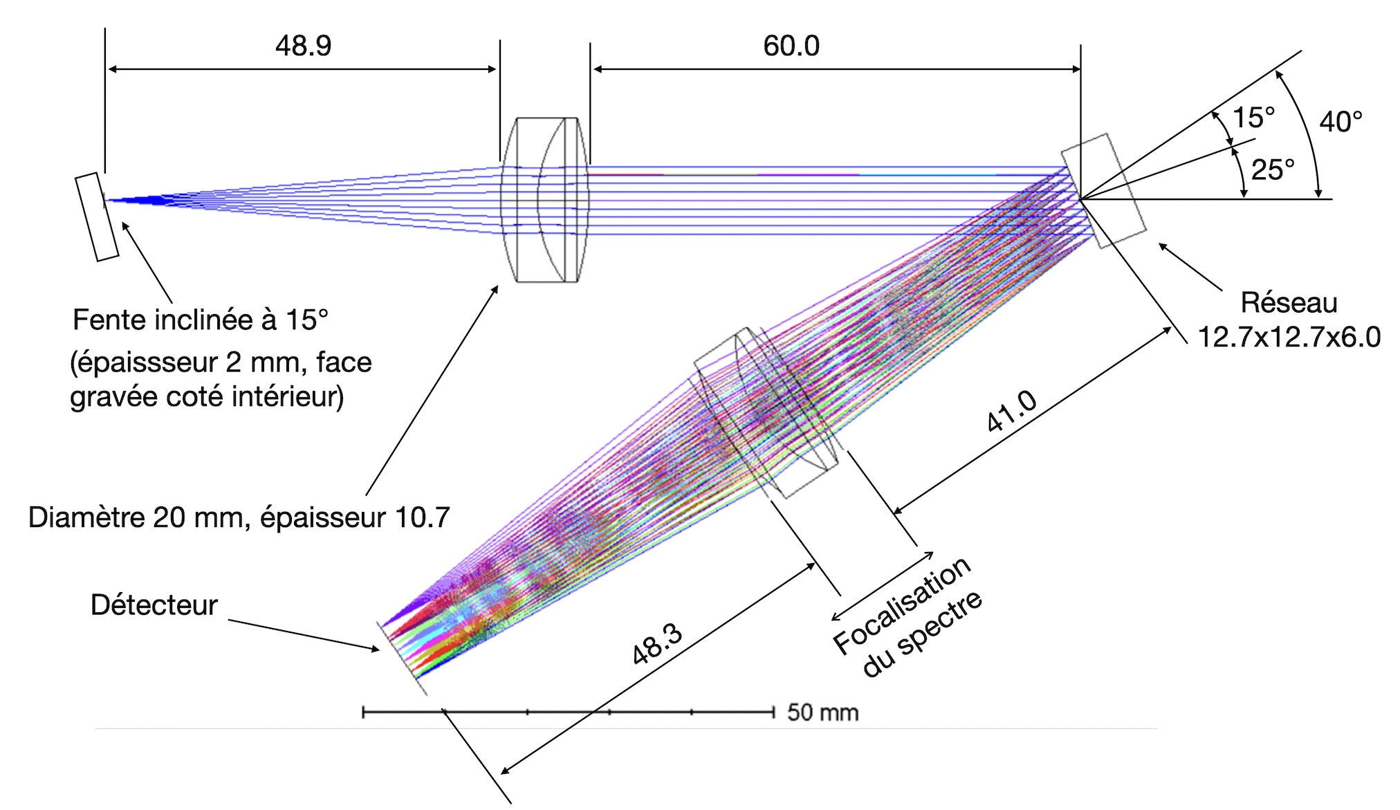
[picture p37: figure]

Figure 4. Optical diagram of the TinyStar’Ex (TSE) spectrograph.

Figure 5 brings together in a single image the optical components required by the spectrograph and its pointing and guiding system. Note how small these components are.

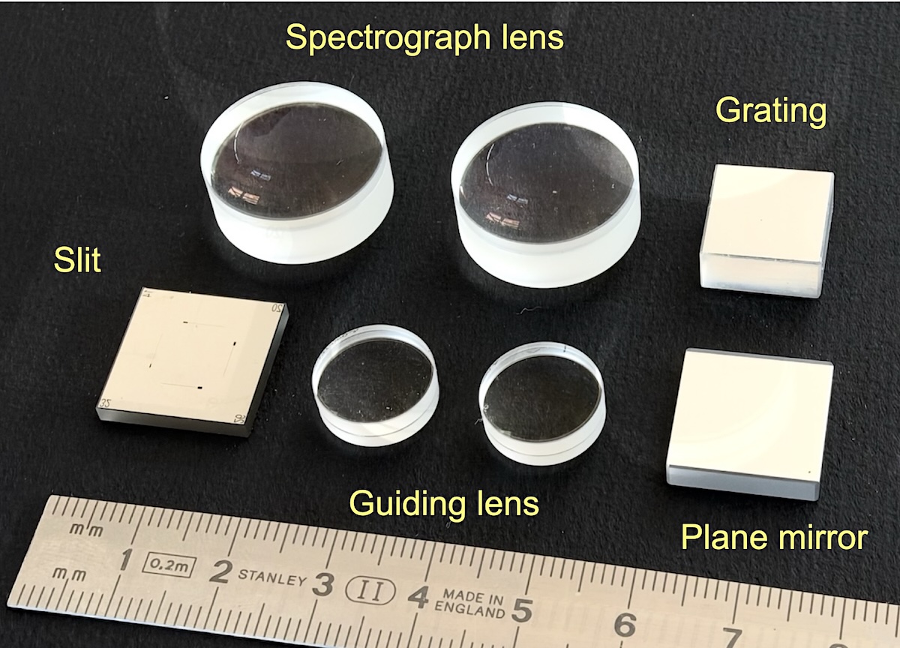
[picture p38: figure]

Figure 5. The optical components of the TinyStar’Ex spectrograph and its pointing and guiding system.

The slit is a four-position GEN2 model, oering a choice of widths of 14, 20, 26 and 32 µm. Each of these slits has a photometric zone at each end, where the slit is locally widened by a factor of 10.

Table 1 gives the resolving power for an extended source as a function of the slit width chosen. For a point source, the resolving power is typically 25% higher.

Table 1. Spectral resolving power for an extended source as a function of slit width, at λ = 656.3 nm (Hα line) and for an f/5 telescope.

Slit width (µm) | Resolving power R
14 | 780
20 | 540
26 | 420
32 | 340

The optical assembly just described is housed in a 3D-printed mechanical body. The optical layout can be recognised in the shape of this housing (Figure 6).

All the STL les needed for printing are supplied (see the next section).

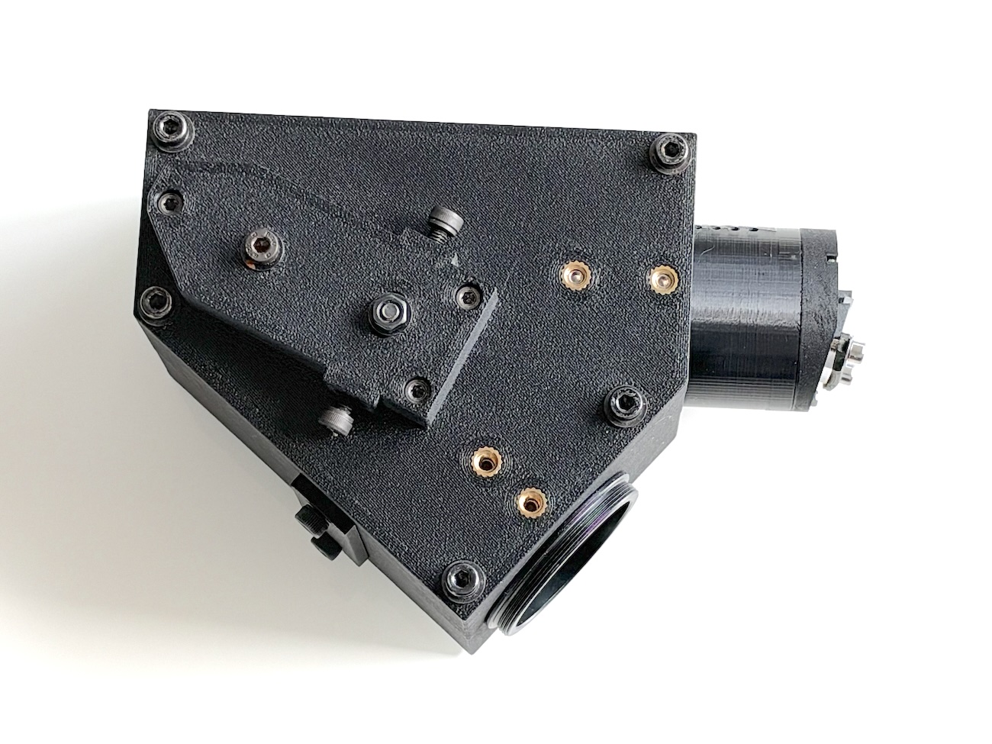
[picture p39: figure]

Figure 6. The TinyStar’Ex spectrograph, whose shape follows that of the optical diagram. The removable grating interface part can also be seen on top.

## 4 The STL les

All the STL les needed to print the spectrograph parts are gathered in a compressed archive, which can be downloaded directly from the project’s GitHub repository:

Download the spectrograph STL les: stl_spectro.zip (https://raw.githubusercontent.com/cbuil06/tse/main/stl_spectro.zip)

Figure 7 shows all the parts to be printed to build the ‘spectrograph’ part of the TinyStar’Ex project.

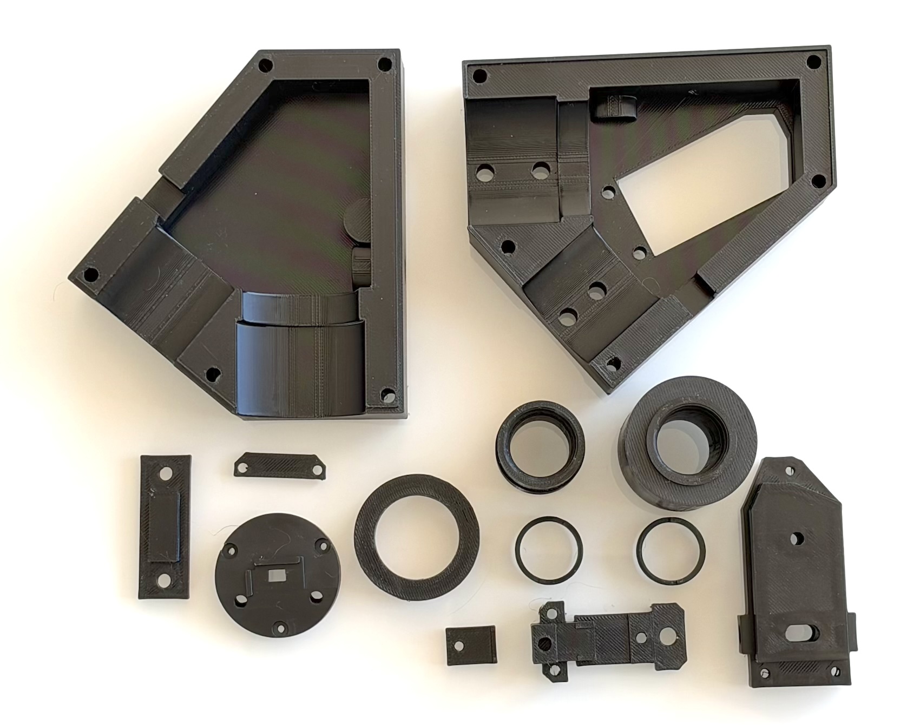
[picture p40: figure]

Figure 7. All the printed parts that make up the TinyStar’Ex spectrograph.

Section 8 gives recommendations for printing.

Table 2 is the bill of materials for the parts of the spectrograph. The part names are those of the STL les.

Table 2. Bill of materials for the printed parts of the spectrograph.

No. | Qty | View of the part

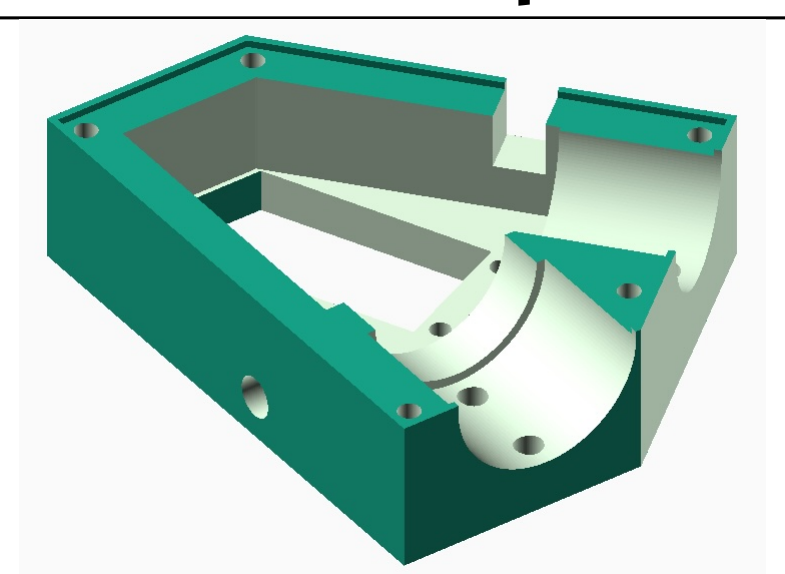
[picture p41: figure]

1-1-capot-inferieur | 1

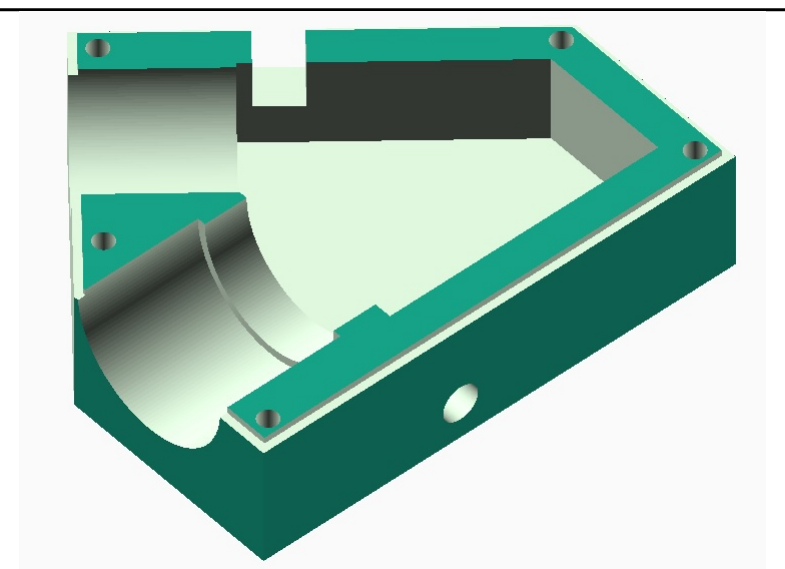
[picture p42: figure]

2-1-capot-superieur | 1

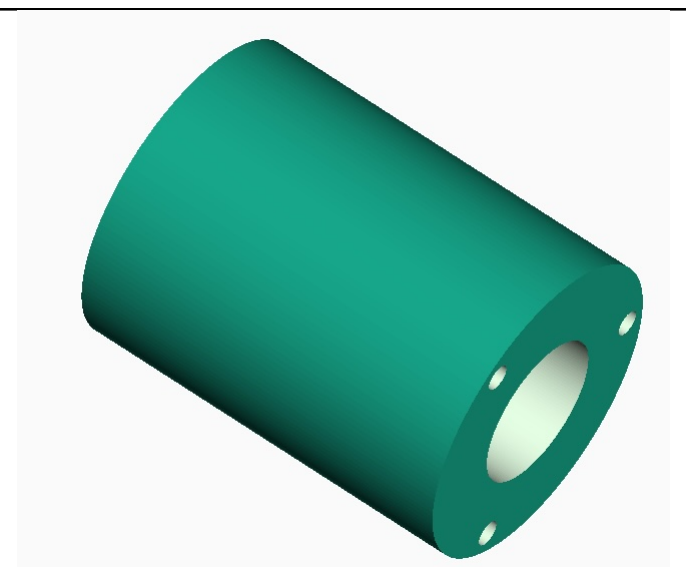
[picture p43: figure]

3-1-tube-collimateur | 1

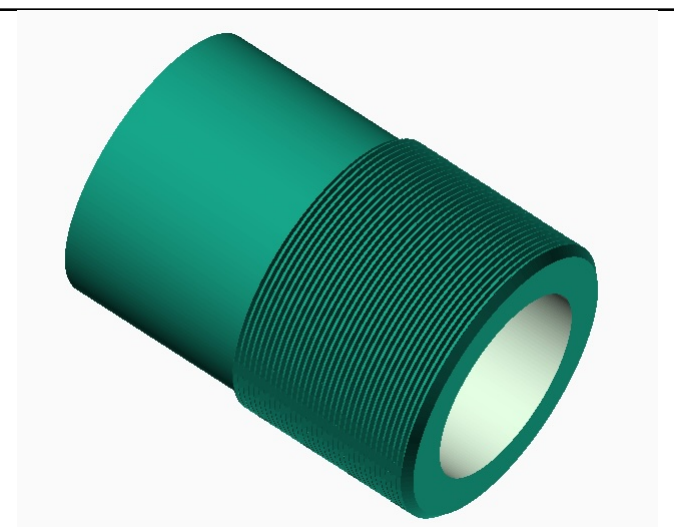
[picture p44: figure]

4-1-tube-camera | 1

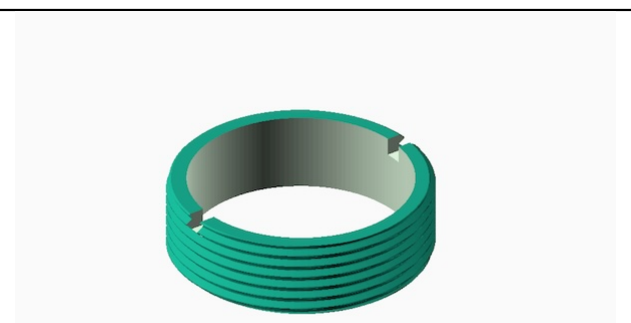
[picture p45: figure]

5-1-bague-objectifs | 2
6-1-bague-focus | 1

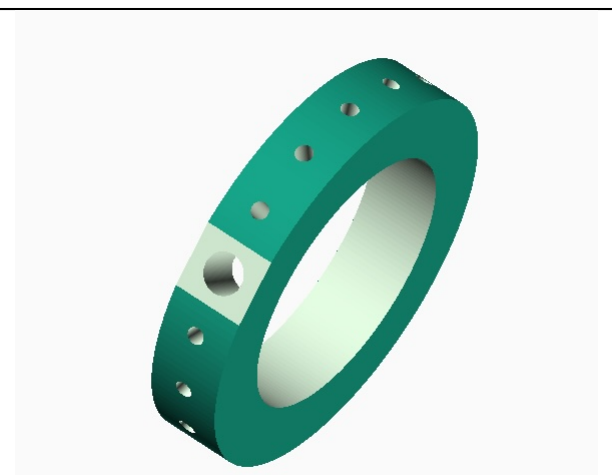
[picture p46: figure]

continued on next page. . .

Table 2 – continued from previous page
No. | Qty | View of the part

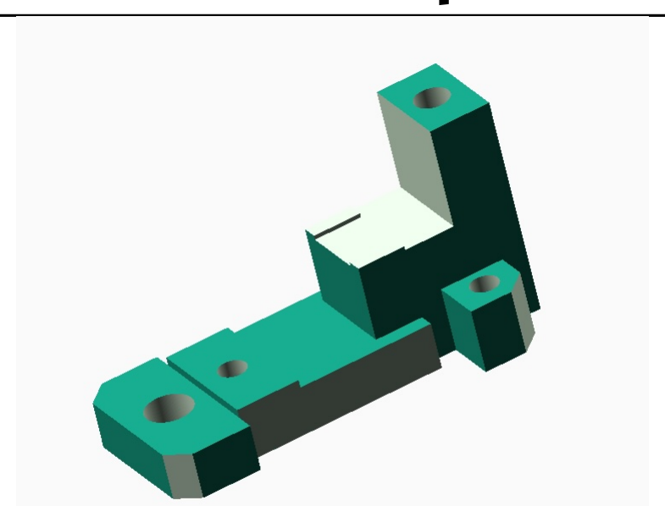
[picture p47: figure]

7-1-porte-reseau-127 | 1

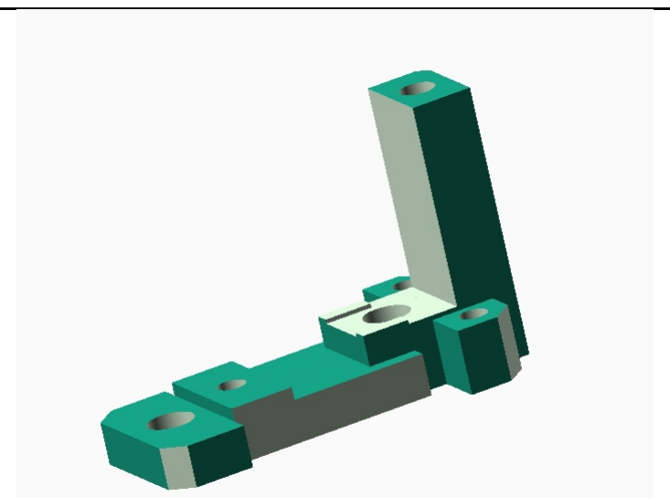
[picture p48: figure]

8-1-porte-reseau-250 | 1

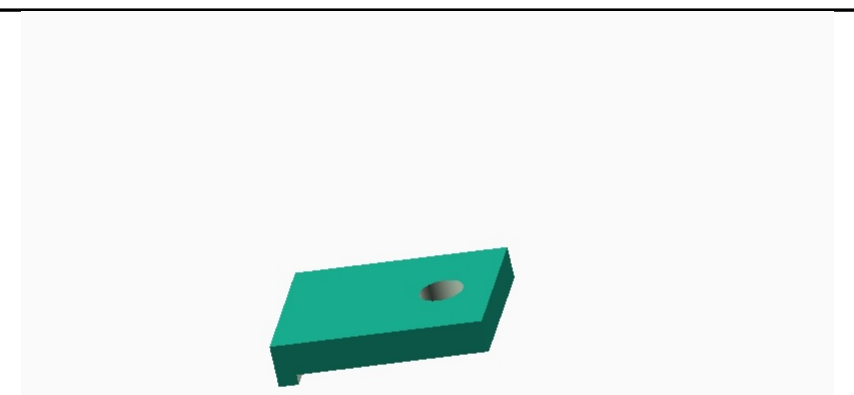
[picture p49: figure]

9-1-bride-reseau | 1

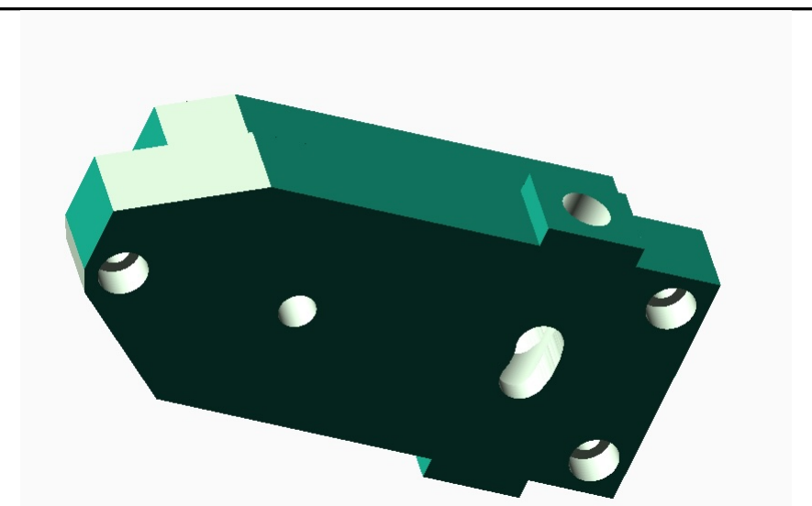
[picture p50: figure]

10-1-interface-reseau | 1

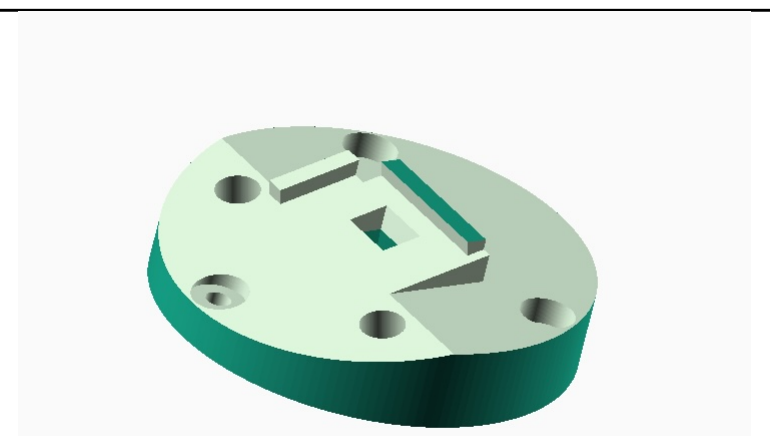
[picture p51: figure]

11-1-support-fente | 1

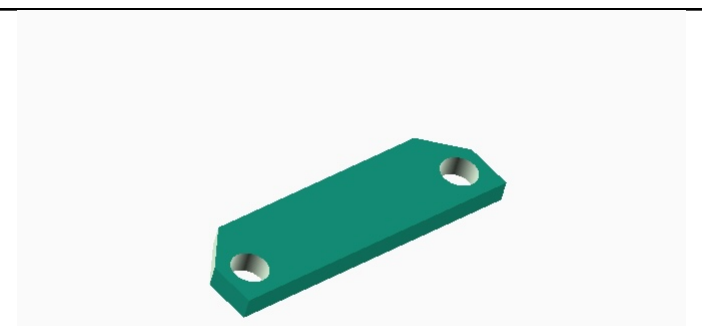
[picture p52: figure]

12-1-bride-fente | 1

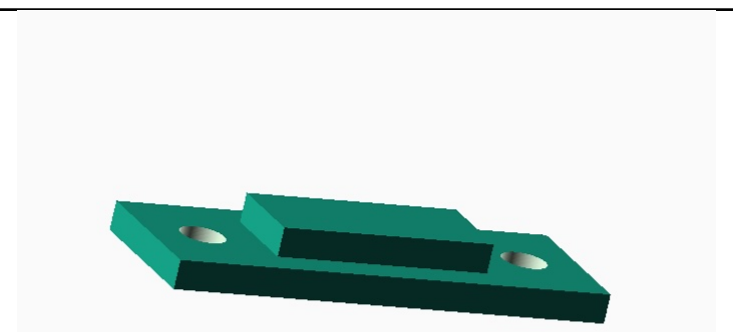
[picture p53: figure]

13-1-trappe-focus | 1

## 5 Adapting the parts with OpenSCAD

The STL les supplied are intended for printing in PETG. Using carbon-bre-lled PETG (PETG-CF), or simply the particular characteristics of your printer, may require some dimensions to be adjusted slightly so that the parts t as well as possible. This is why the project also provides an OpenSCAD le describing all the parts of TinyStar’Ex.

OpenSCAD²
is free, open-source 3D modelling software, available for Windows, macOS and Linux. Unlike conventional CAD software, you do not draw with the mouse: each part is described by a short text, in the manner of a computer program. This text combines simple shapes, called primitives (cube, cylinder, sphere. . . ), using a few operations: they are added together (union), subtracted from one another (difference) to drill a hole or cut out a recess, and moved or rotated (translate, rotate).

For example, the 50 mm barrel is simply a cylinder from which a smaller cylinder is removed to let the light through. Its outer diameter is dened by a variable placed at the top of the code:

diametre_coulant = 50.85; // outer diameter of the barrel (mm)

If the barrel is too tight a t in your focuser, simply replace 50.85 with 50.75, for example.

In the TinyStar’Ex les, the important dimensions are grouped in this way into clearly identied and commented variables. The procedure is always the same:

1. open the le in OpenSCAD and change the desired value;
2. press F5 to see the modied part immediately;
3. press F6 to render the nal part, then export it in STL format (menu File > Export > Export as STL).

The new STL le is ready to be sent to the slicer. There is no complex interface to learn: a few minutes are enough to adjust a diameter or a thickness. The more curious can also go further and modify, or even create, their own parts.

The OpenSCAD le containing the complete CAD model of the spectrograph, TSE_sources_ spectro.scad, (https://raw.githubusercontent.com/cbuil06/tse/main/TSE_sources_spectro.scad) can be downloaded directly from the project’s GitHub repository.

The form of TinyStar’Ex currently oered is fully functional, which is what matters most. You are nevertheless free to modify it to your taste and adopt your own design language, in the spirit of sharing the results of this work with the community. You must, of course, respect the optical dimensions (Figure 4) for the modied instrument to remain operational.

## 6 Screws and fasteners

One supplier (among others) for the screws: FIXnVIS, https://www.visseriefixations.fr.

Table 3 lists all the screws required, both for the spectrograph itself and for the pointing and guiding system, which is described in a separate guide. A word of advice: buy a few more than the quantities indicated; this is not the largest item of expenditure.

Table 4 gives the type and number of threaded inserts required. Choose RUTHEX inserts. They can be bought, for example, from https://www.3djake.fr/ruthex or from Amazon.

2
https://openscad.org

Table 3. List of screws.

Type | Quantity
M2 × 8 mm | 3
M3 × 8 mm | 4
M3 × 10 mm | 9
M3 × 12 mm | 3
M4 × 8 mm | 2
M4 × 20 mm | 5
M4 × 25 mm | 1
M4 × 30 mm | 1
M4 × 60 mm | 5
M4 × 70 mm | 4
M3 × 6 (grub screw) | 1
M4 × 10 (grub screw) | 4

Table 4. List of inserts.

Type | Quantity
M2 | 3
M3 | 12
M3 S | 6
M4 | 14
M4 S | 9
1/4” S | 4

## 7 Tools

Only a few tools are needed (small screwdrivers, Allen keys, pliers), plus a basic soldering iron and the equipment for tting inserts, the small threaded parts that allow strong screwed joints to be made (Figure 8).

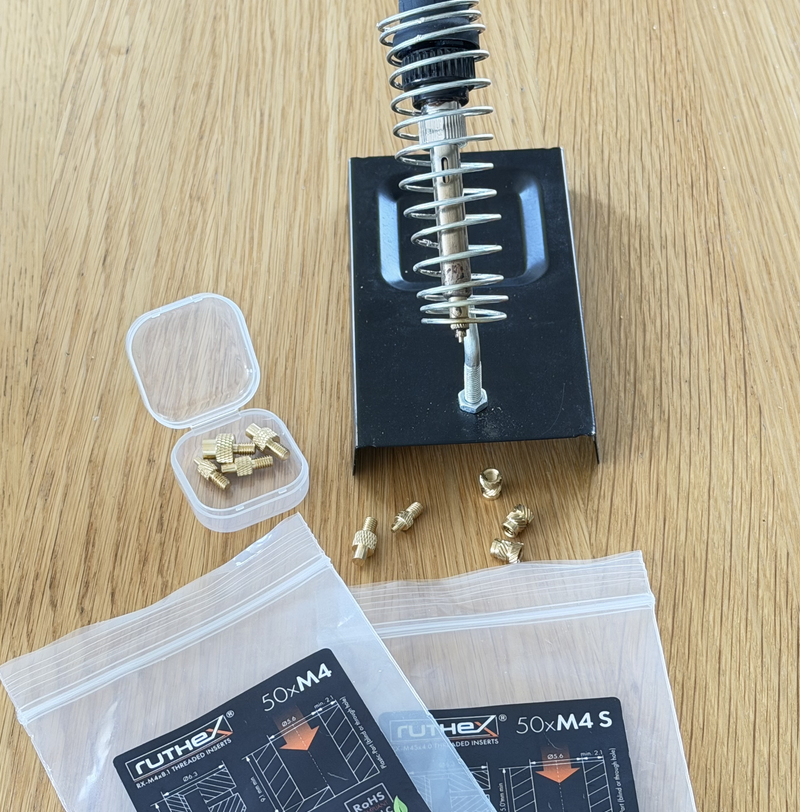
[picture p54: figure]

Figure 8. What you need to t inserts: a small soldering iron, special tips and a set of inserts (we recommend the Ruthex brand).

You will need a set of soldering-iron tips designed specically for tting threaded inserts. We recommend the high-quality Ruthex set. This inexpensive accessory is essential for accurate placement. For example: https://www.amazon.fr/dp/B0DP51DDF7?th=1.

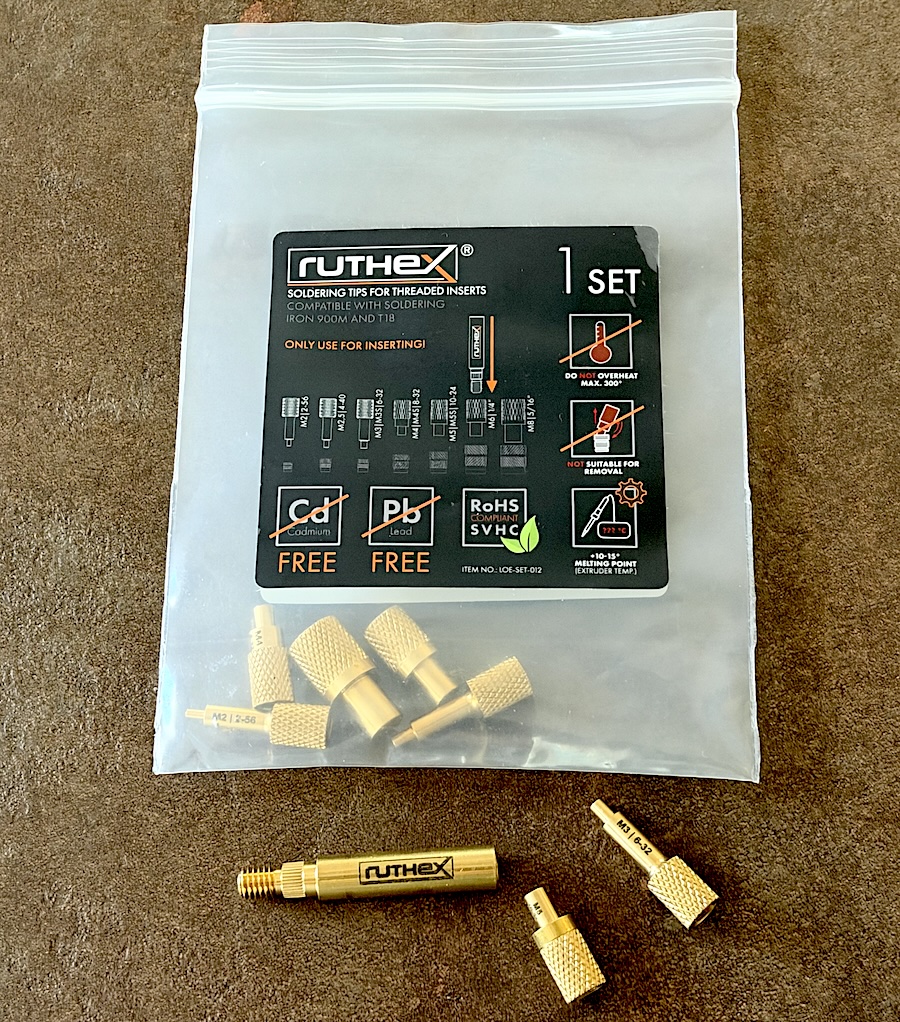
[picture p55: figure]

Figure 9. The Ruthex insert-tip set.

The type of insert to use will be indicated at each stage of the assembly.

Set the soldering iron to a temperature of 230 ◦C, ideal for PETG (Figure 10).

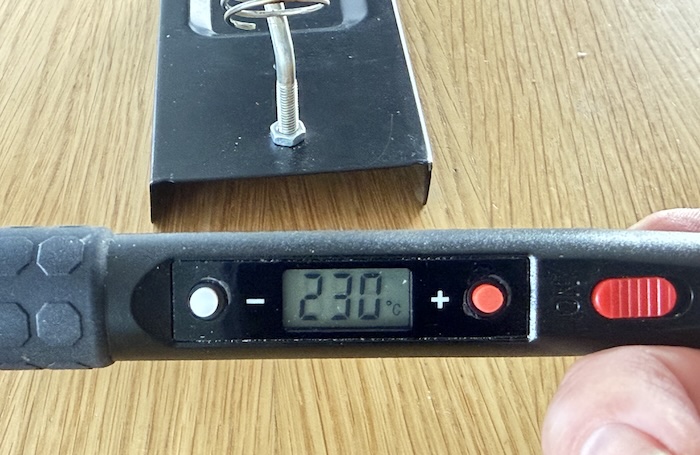
[picture p56: figure]

Figure 10. Setting the temperature of the iron.

The insert should sink in gradually under light pressure (Figure 11). Do not go beyond the depth at which it is ush with the surface, to avoid raised edges. You can even stop just short of the nal depth and, immediately after removing the iron, press with a metal block to push the insert ush and obtain a perfectly at surface. The smaller the insert, the more care it needs.

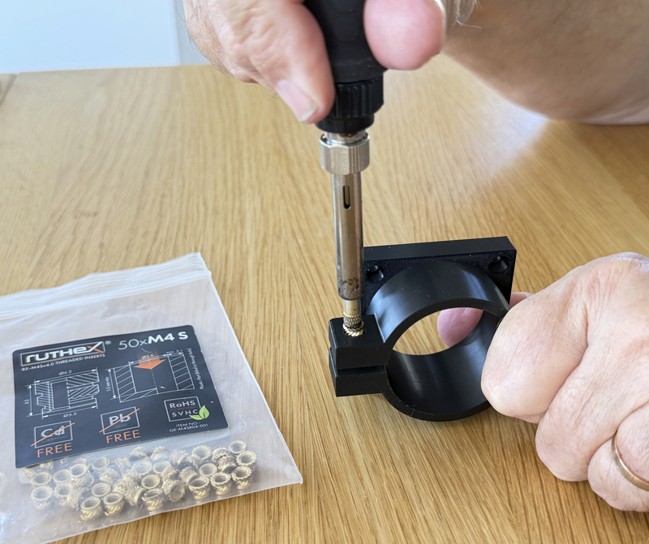
[picture p57: figure]

Figure 11. Installing a threaded insert using a soldering iron. Apply gentle pressure without excessive force to maintain control over the insertion process. Make sure the insert is oriented correctly: insert the smaller-diameter end into the hole. If necessary, use your ngers to gently guide this end into the hole, ensuring that the insert and the hole are coaxially aligned. Only then, slowly press the insert into place using a soldering iron tted with the appropriate tip for the insert size (M2, M3, M4, etc.), until it is ush with the surface. Apply pressure strictly along the axis of the insert.

## 8 Printing

Virtually any 3D printer can make a TSE, including small models such as the excellent Bambu Lab A1 mini (see Figure 12). Black PETG lament is the right choice for printing TSE: the black colour is essential for the parts to be opaque to light. If your printer allows it, you can also opt for PETG-CF (carbon-bre lled), which oers even better rigidity.

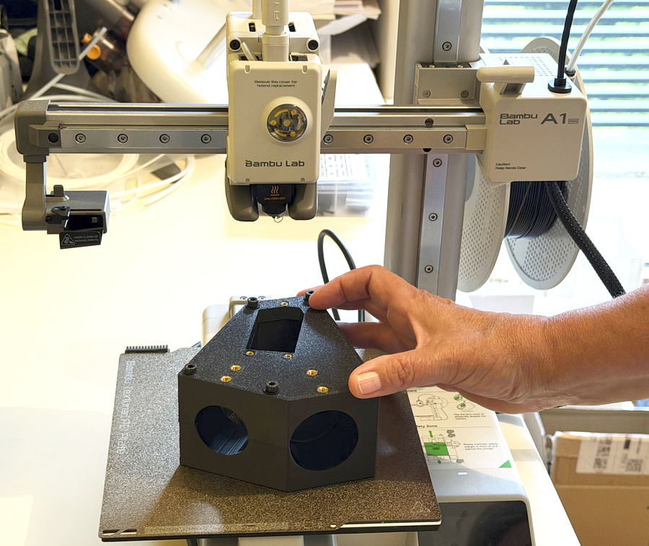
[picture p58: figure]

Figure 12. Despite a build plate of only 180 × 180 mm, the Bambu Lab A1 mini printer prints all the TSE parts without diculty. Compact and now sold for less than 200 euros, such a printer is an investment that quickly pays for itself, in keeping with the philosophy of TinyStar’Ex.

Most parts can be printed with a layer height of 0.18 mm. There are, however, some important exceptions: the following parts must be printed with a layer height of 0.12 mm or less (to be set in your slicer). They are identied by their number in Table 2:

- 3-1-tube-collimateur;
- 4-1-tube-camera;
- 5-1-bague-objectifs;
- 11-1-support-fente: for this part, also enable ne smoothing of the vertical walls if your printer allows it.

Five perimeters are enough. You can go up to six for the 3-1-tube-collimateur part, which must be particularly rigid. An inll of 30% is entirely satisfactory; use a gyroid inll pattern if possible.

## 9 Assembling the spectrograph

### 9.1 The housing

Figure 13 shows all the inserts to be tted in the lower shell (part 1-1-capot-inferieur).

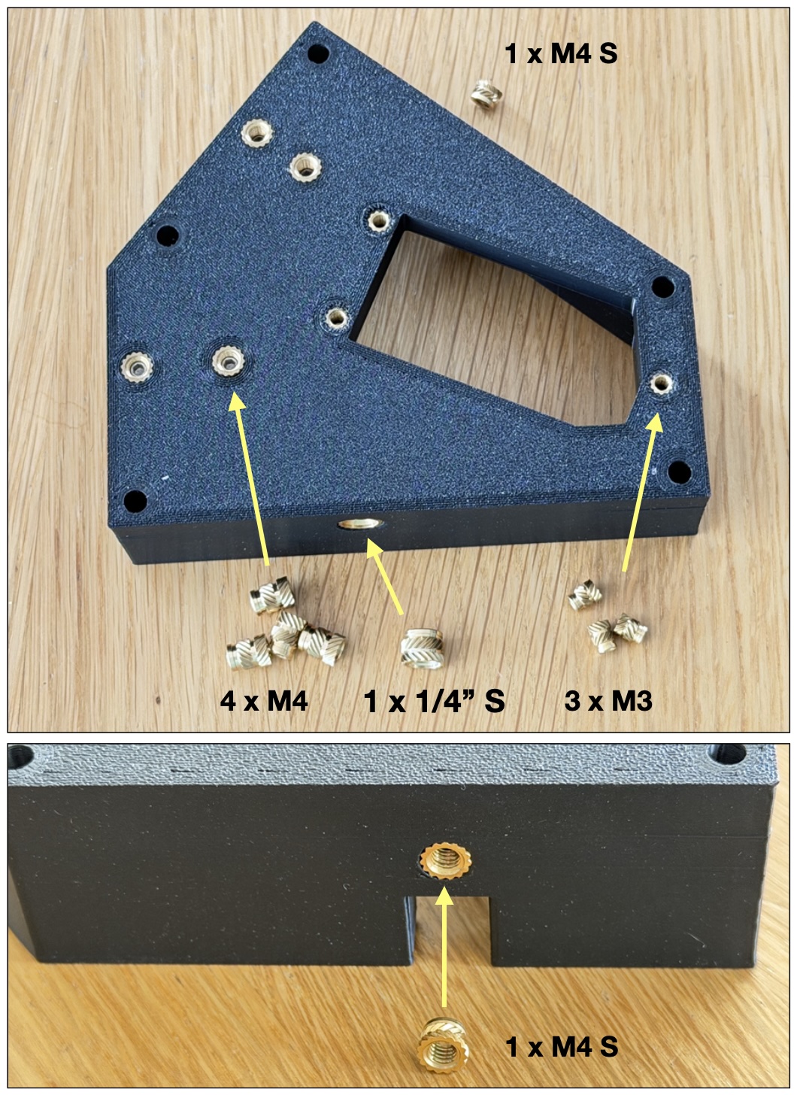
[picture p59: figure]

Figure 13. List and layout of the inserts to be tted in the lower shell of the TSE housing. Take great care that the four M4 inserts do not protrude into the circular half-bore, which must remain perfectly smooth: check carefully that each insert is pushed in only until it is ush with the at face of the housing.

The M4 inserts take Teon-tipped grub screws (M4, 10 mm long); see Figure 14.

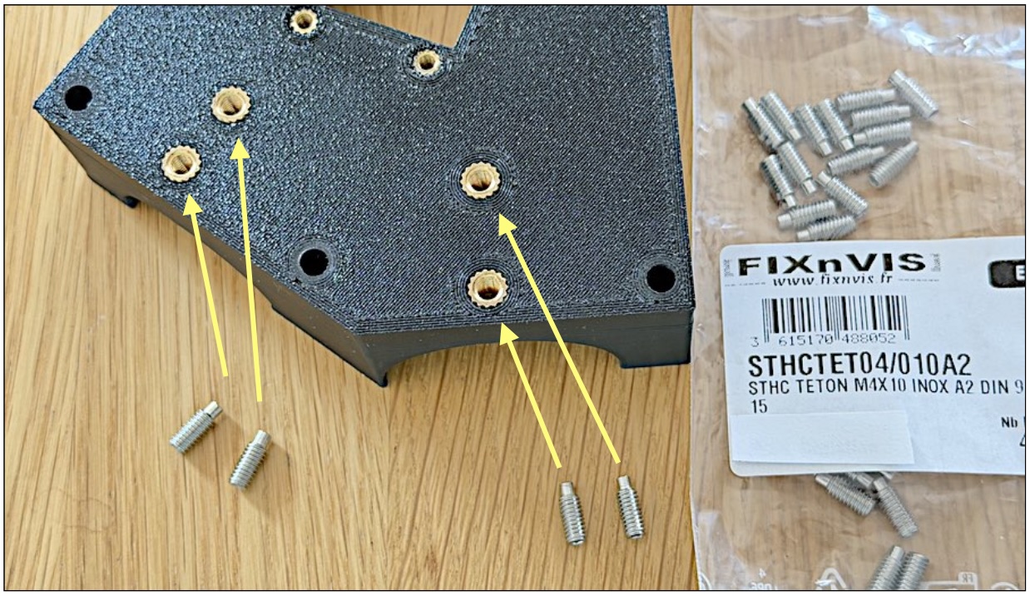
[picture p60: figure]

Figure 14. Locking screws for the collimator and camera tubes: Teon-tipped grub screws (M4, 10 mm). See, for example, https://www.fixnvis.fr.

Figure 15 shows the inserts tted in the upper shell (part 2-1-capot-superieur).

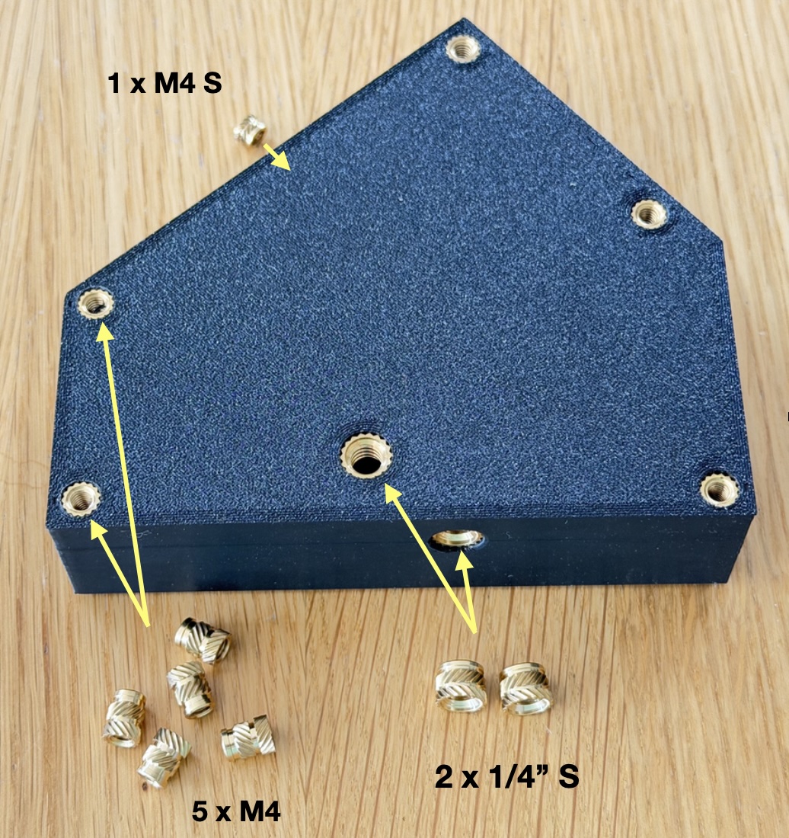
[picture p61: figure]

Figure 15. The inserts in the upper shell of the TSE housing. The 1/4-inch inserts (standard tripod thread) are provided so that, for example, the spectrograph can be mounted on a photographic tripod, or accessories attached to its body.

### 9.2 The camera tube

The camera tube holds the so-called ‘camera’ lens, which focuses the spectrum onto the detector of the imaging camera. To complete the assembly, you need a 31.75 mm barrel to T2 thread adapter (42 mm diameter, 0.75 mm pitch). This is a common item among astronomy accessories; you will probably nd one, for example, in the box of the camera you use.

We shall use the internal thread with which all these adapters are tted for mounting lters (28.5 mm diameter, 0.6 mm pitch). The camera tube (part 4-1-tube-camera) screws into this adapter, which will later allow the spectrum to be focused.

Figure 16 shows how to t these two parts together. Take care: the thread is very ne, so patiently nd the start of the thread, and above all avoid forcing the tube if it is crooked in the female metal thread. When everything is correct, the tube screws in without great eort and without any tight spots. It is normal for the working clearance to be fairly small, so you may feel slight resistance.

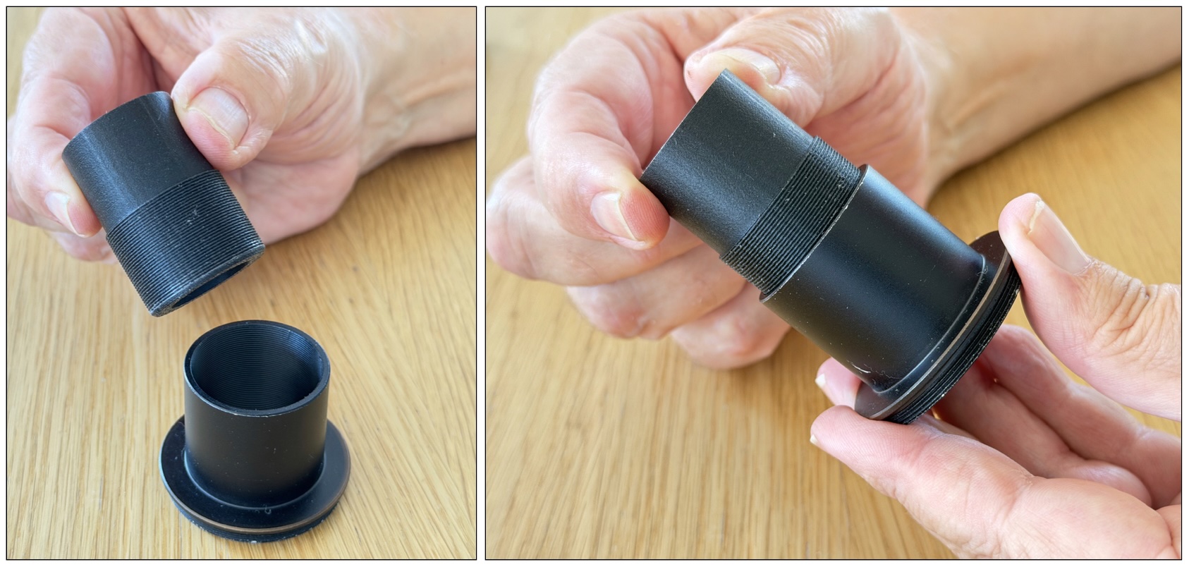
[picture p62: figure]

Figure 16. Fitting the camera tube into the 1.25-inch barrel to T2 adapter. You should be able to screw it in until the threaded part of the tube disappears.

The next step is to prepare the ring that ts on the end of the camera tube, the part referenced 6-1-bague-focus. As its name suggests, it is this ring, xed to the camera tube, that allows the tube to be turned (through a hatch in the housing) and hence the focus to be adjusted.

A short M3 insert is tted in the ring, so that it can be clamped with a small M3 hexagon socket screw 6 mm long (Figure 17). A Teon-tipped screw, which does not damage the PETG, is recommended. In general, for screws and fasteners, https://www.visseriefixations.fr oers a very wide choice. For grub screws, type STHC in the site’s search tool (see also the reference in Figure 17).

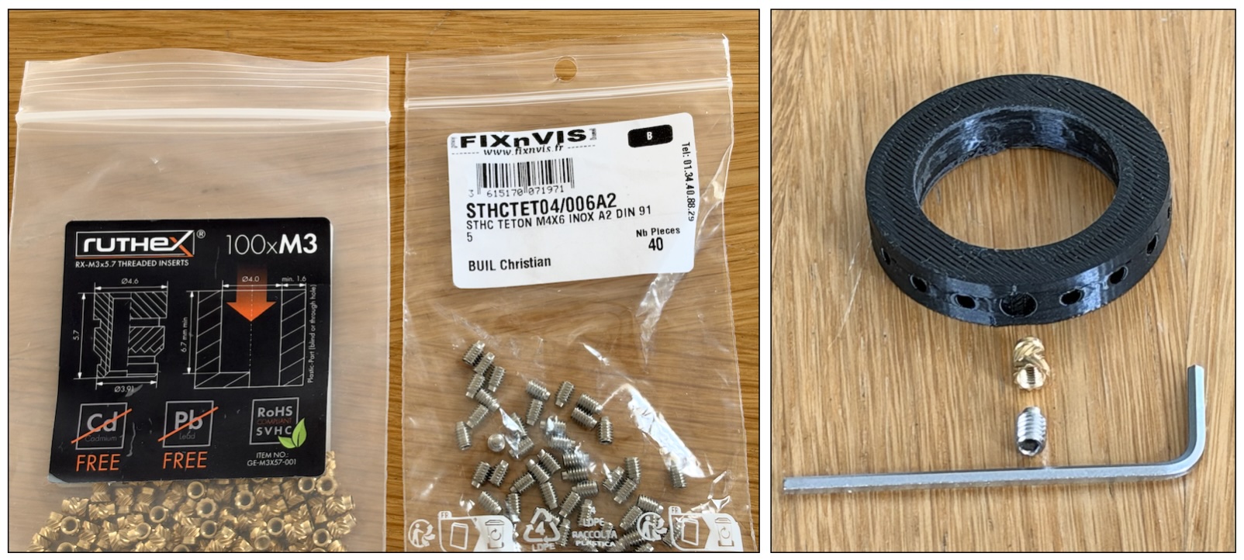
[picture p63: figure]

Figure 17. Fitting the clamping insert (an M3 insert) and an M3 grub screw 6 mm long in part 6-1-bague-focus.

Fix the focusing ring almost at the end of the camera tube, as shown in Figure 18.

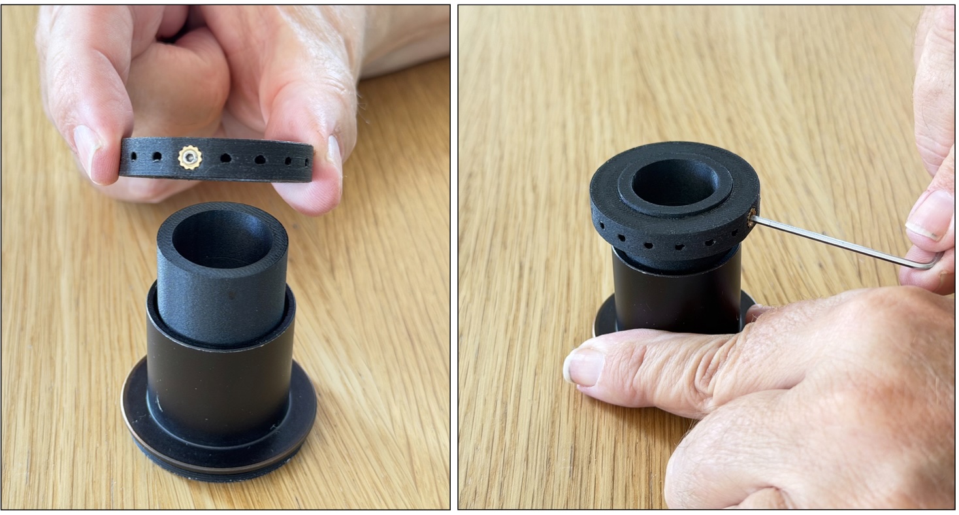
[picture p64: figure]

Figure 18. The focusing ring xed very close to the end of the lens tube (allow about 0.5 mm between the end of the tube and the front face of the ring). Tighten the grub screw moderately.

We shall now t the lens in its tube.

Unpack one of the two lenses from the optical kit (see the left-hand view in Figure 19). You cannot go wrong: these lenses are identical! One will serve as the camera lens and the other, later, as the collimator lens. They are 20 mm in diameter with a focal length of 50 mm.

These lenses are specially optimised achromatic doublets, made of special (ED) glasses. The two cemented elements can easily be made out by looking at the edge of the lenses.

One of the two lenses from the optical kit is tted simply by sliding it into the camera tube (see the right-hand view in Figure 19).

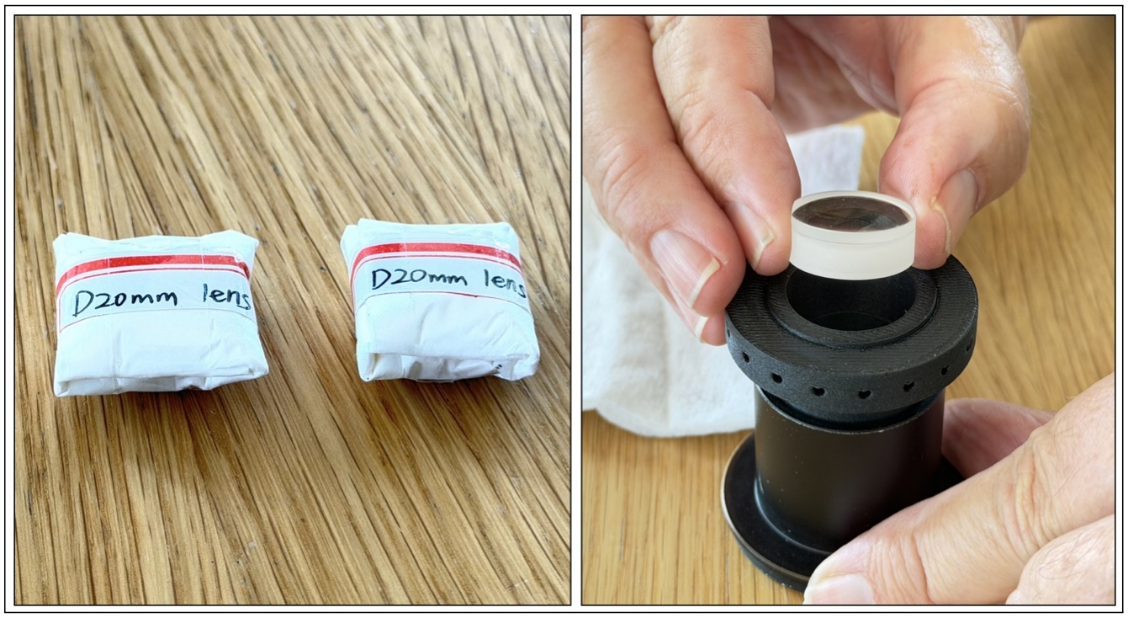
[picture p65: figure]

Figure 19. Left: the two lenses of the optical kit, still in their packaging. Use a craft knife to cut the retaining tape when unpacking them. Right: the lens ready to be slid into its seat in the camera tube. Always hold the lens by its edge. Naturally, do not touch the optical surfaces; but if this happens, there is no cause for concern: rub gently with cotton wool and 95% household alcohol, changing the cotton wool, and everything will be ne again (99% isopropyl alcohol is even better, but not essential). You can wear white cotton gloves if you are not comfortable handling this type of component with bare hands.

Caution: the lens must be tted the right way round, and it is very important to respect this. Look carefully at the enlarged view in Figure 20: the element that appears thinner when viewed edge-on must always face the outside of the tube.

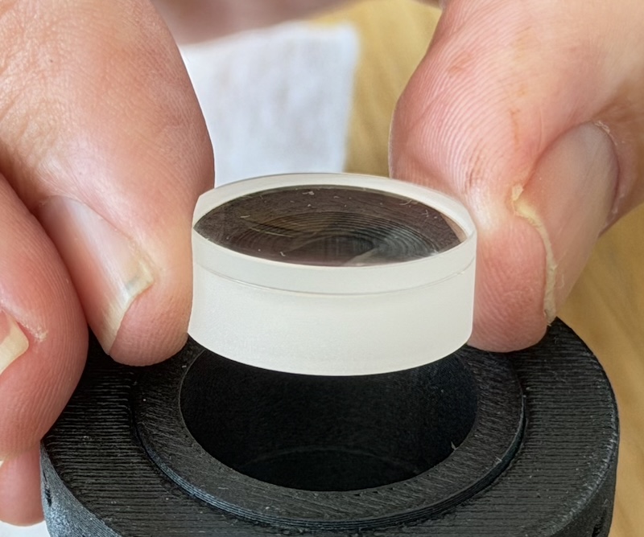
[picture p66: figure]

Figure 20. The orientation of the lens. It consists of two cemented elements: the thinner of the two, seen edge-on, must be placed on the outer side of the tube.

With the tube held vertically, present the lens squarely on the axis: it should drop of its own accord down to its internal shoulder, under gravity alone, without your having to press on it, except gently on one edge to straighten it. Tap the tube to help it down. If the lens has to be forced in, do not insist, as you risk jamming it in its seat. If this happens, press gently on the other face of the lens with a cotton bud to push it back out, with successive light touches on the edges and in the centre.

If you need to remove the lens from its seat, do so over lens tissue or a sheet of cotton wool, so that it cannot be damaged by falling onto a hard surface. Make sure the drop height does not exceed two or three centimetres.

All that remains is to lock the lens in its seat with one of the threaded rings 5-1-bague-objectifs (Figure 21).

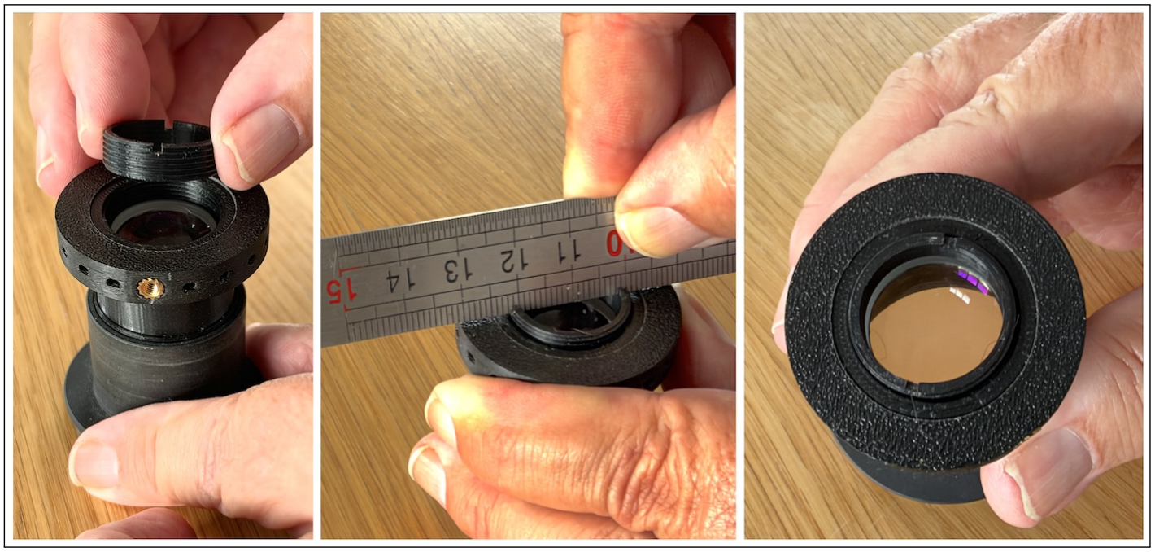
[picture p67: figure]

Figure 21. Screwing in the lens retaining ring. When the ring touches the glass surface, tighten it moderately by turning it with a steel rule engaged in its two notches. Once the ring is tight, the lens must no longer move when you shake the tube.

### 9.3 The collimator tube

Fit three M2 inserts in the seats provided at the end of the collimator tube, part 3-1-tube-collimateur (Figure 22). This is probably the most delicate insert tting, as they are small in diameter. Use the appropriate soldering iron tip and push the inserts in very gently while hot. You can nish by pressing with a metal plate before they cool. The inserts must not protrude from the at face of the collimator tube, and no raised edge must remain: the slit holder will rest on this face, and the distance between the slit and the lens, as specied by the optical design, depends on it.

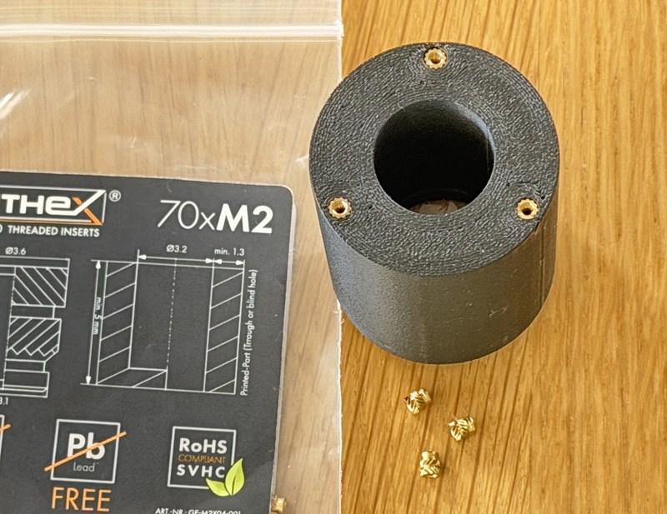
[picture p68: figure]

Figure 22. Fitting the M2 inserts.

Fit the remaining lens in the collimator tube in the same way as for the camera tube (Figure 23). Take particular care to t the lens the same way round. Finally, lock the lens with a 5-1-bague-objectifs threaded ring.

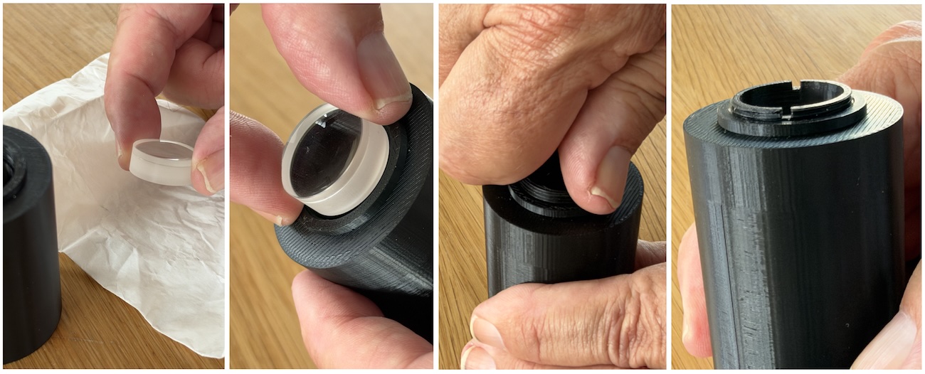
[picture p69: figure]

Figure 23. Fitting the collimator lens the right way round, then holding it in place with a threaded ring. As for the camera lens, nish tightening without forcing, using an engineer’s rule engaged in the notches of the ring.

### 9.4 The slit

Take the slit holder, part 11-1-support-fente, and t two M3 S inserts in it (Figure 24). Take care: these are ‘short’ M3 inserts, not to be confused with ‘standard’-length M3 inserts.

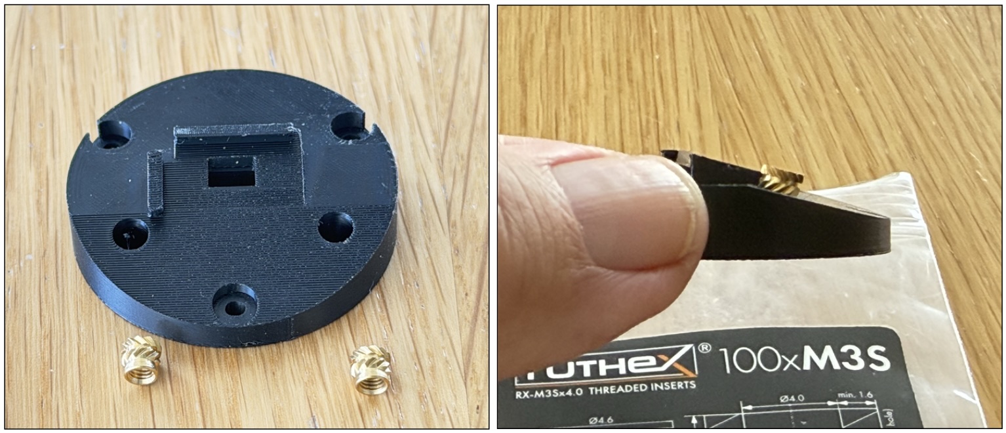
[picture p70: figure]

Figure 24. The slit holder and the two M3 S inserts to be tted. Note that the plane of the slit is inclined at 15◦
to the
base of the part; it is normal for the insert, in its tting position, to have this angle (see the photograph on the right). When you push it in with the soldering iron, you must respect this angle, which means that the axis of the iron is perpendicular to the seating face of the slit.

Figure 25 shows the inserts in place at the correct angle.

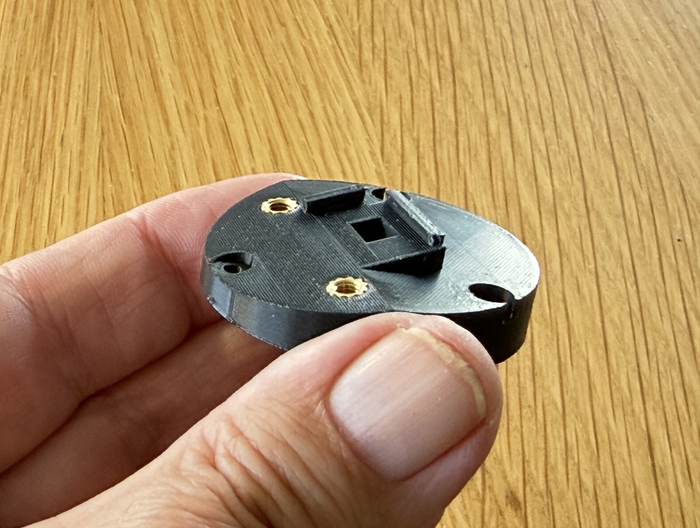
[picture p71: figure]

Figure 25. The slit holder tted with its inserts. Their axis is indeed perpendicular to the at face that carries the slit.

The slit clamp, part 12-1-bride-fente, is tted with two M3 × 10 mm screws. Do not screw the clamp fully home, so as to leave a gap for sliding in the slit; see Figure 26.

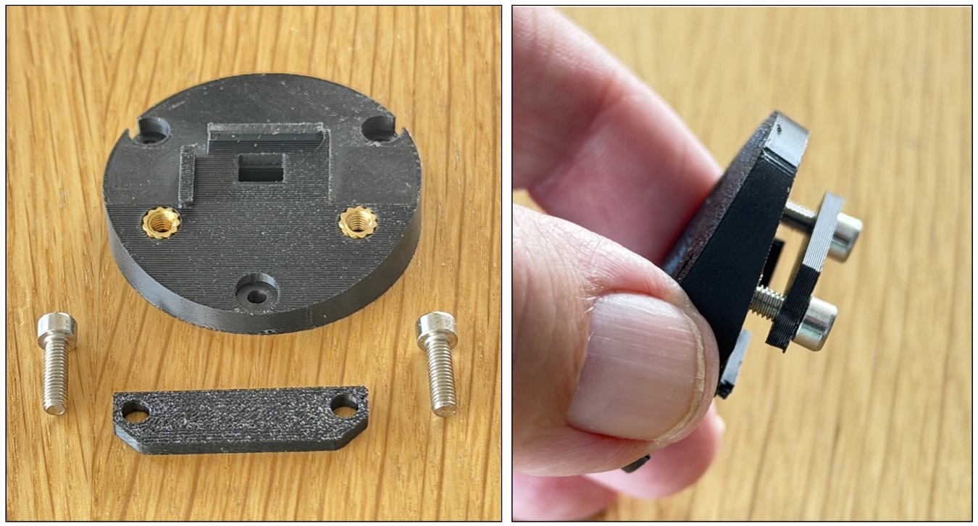
[picture p72: figure]

Figure 26. Fitting the slit clamp.

The slit to be used is a 4-position GEN2 model. It is included in the TinyStar’Ex optical kit, but an equivalent is also available from Shelyak Instruments. (https://www.shelyak.com) It is a glass plate 2 mm thick and 16 mm square, one face of which is covered with a chrome layer in which slits of various widths are ‘engraved’ as transparent openings (Figure 27).

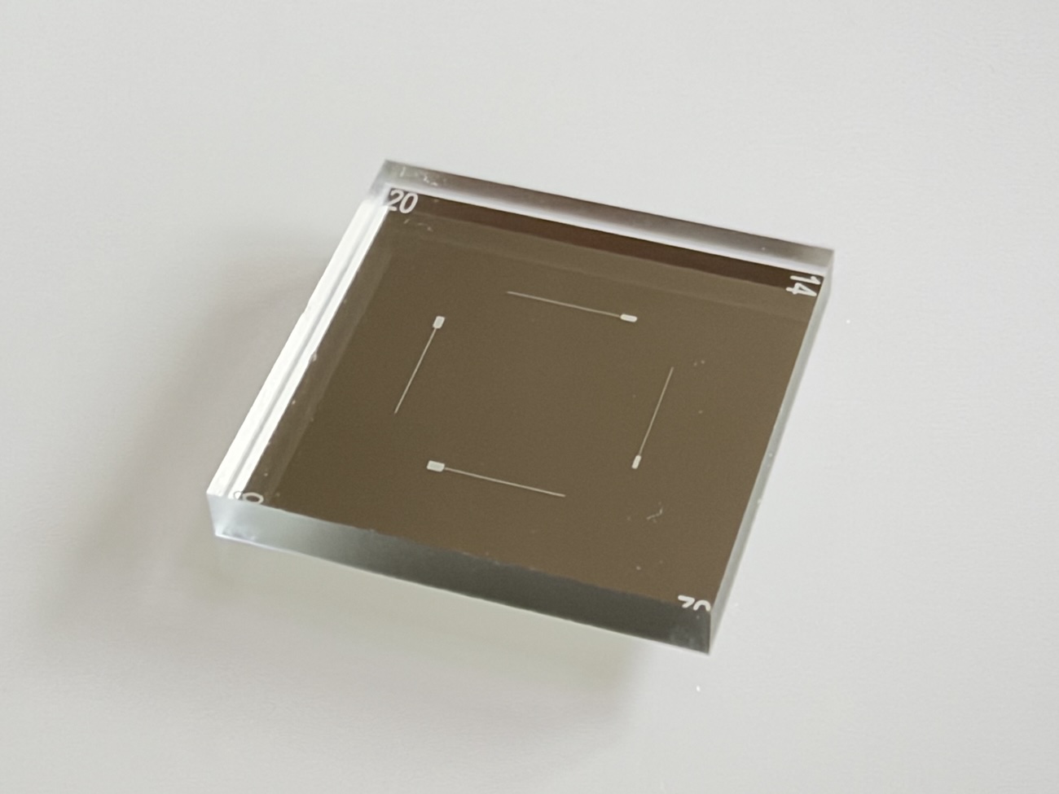
[picture p73: figure]

Figure 27. The 4-position GEN2 slit (widths of 14, 20, 26 and 32 microns, selected by rotating it through 90◦ ). At each
end of every slit is a ‘photometric’ zone, ten times wider than the slit itself.

The slit can be cleaned. If you spot dust or ngerprints, using a strong magnifying glass or the macro mode of your smartphone, do not hesitate to clean it with a cotton bud moistened with a little methylated spirits or, better still, isopropyl alcohol (Figure 28). Finish by gently wiping it dry, with two or three strokes in the same direction. Check both faces of the slit.

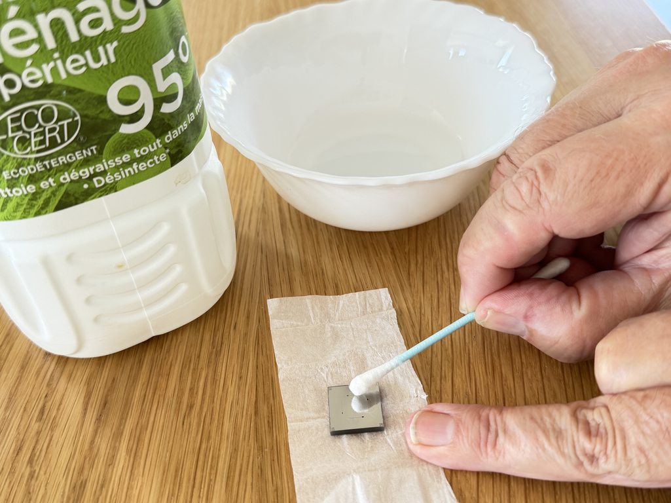
[picture p74: figure]

Figure 28. Cleaning the slit.

Place the slit in the corner formed by the two mechanical stops of the holder (Figure 29). As we have seen, the slits are engraved in a thin, reective chrome layer deposited on one face of the glass plate. This chrome-coated face must face the holder. The markings on the slit should then read the right way round (Figure 30). Tighten the clamp without excess. It will bend slightly, a sign that it is holding well; but since the grip relies on the exing of the clamp, the tightening must remain very moderate. Share the eort evenly between the two screws. Then check with the strong magnier, as described above, that the edges of the slit are in contact with the side stops along their entire length (Figure 31). When starting out with TinyStar’Ex, it is recommended to select the 20 µm slit.

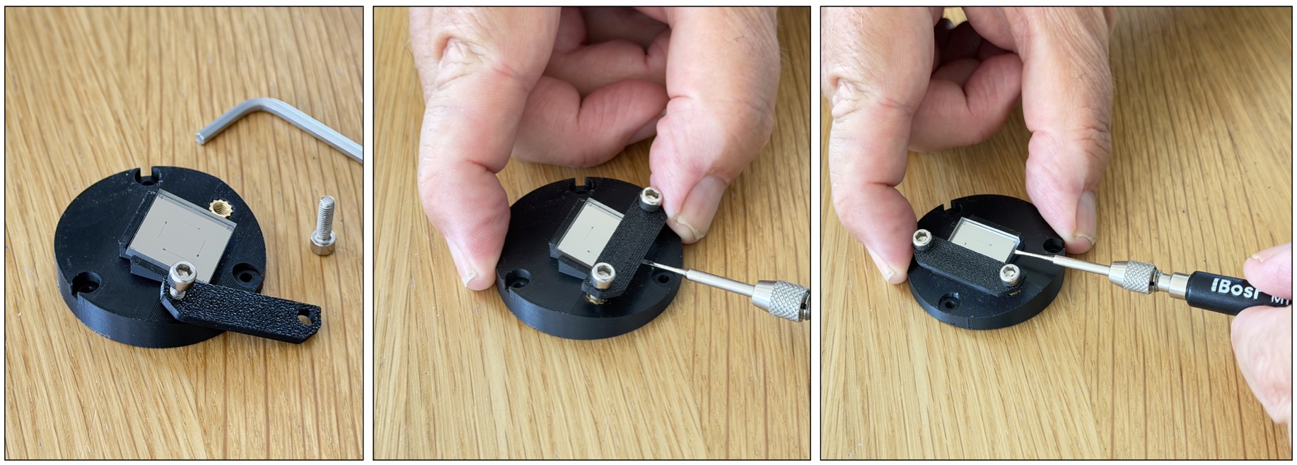
[picture p75: figure]

Figure 29. To make it easier to pre-position the slit, you can loosen one of the two clamp screws. Using a small screwdriver, adjust the position of the slit along both axes of its plane: it must be able to slide, so do not tighten the clamp at this stage. Important: the slit must rest rmly against both perpendicular walls that set its position. To check this, look at it from the side with a magnifying glass.

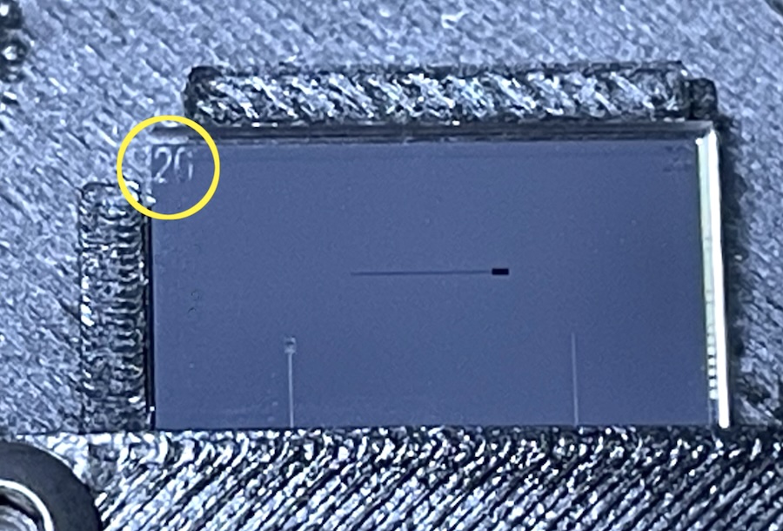
[picture p76: figure]

Figure 30. To check that the slit is tted the right way round, make sure that the markings indicating the widths read correctly. In this example, the 20 µm slit is in position.

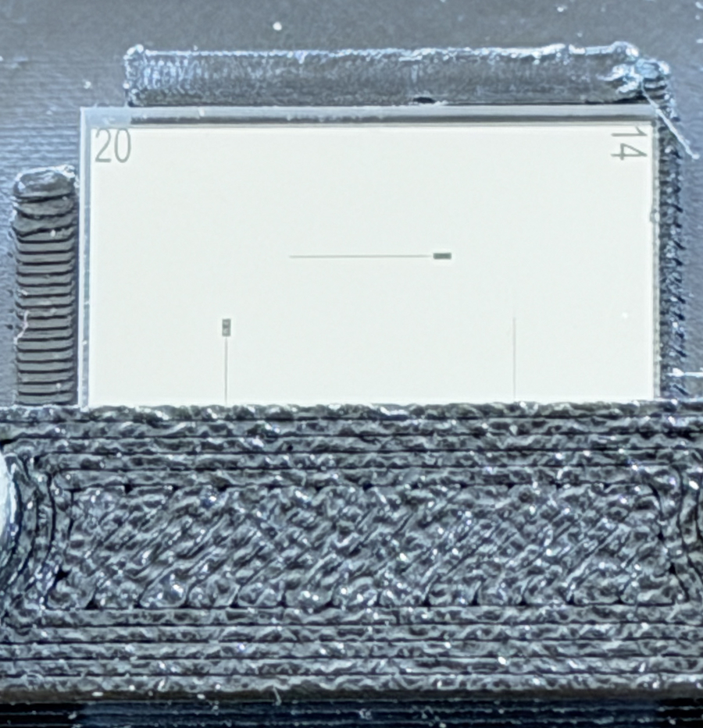
[picture p77: figure]

Figure 31. High magnication of the slit after tightening the clamp. The edges of the slit rest rmly against the mechanical stops along their entire length. With the orientation of this example, the 20 µm slit is selected. The photometric zone, here 200 µm wide, can just be made out at one end.

Fix the slit holder to the end of the collimator tube with three M2 screws 8 mm long (Figure 32).

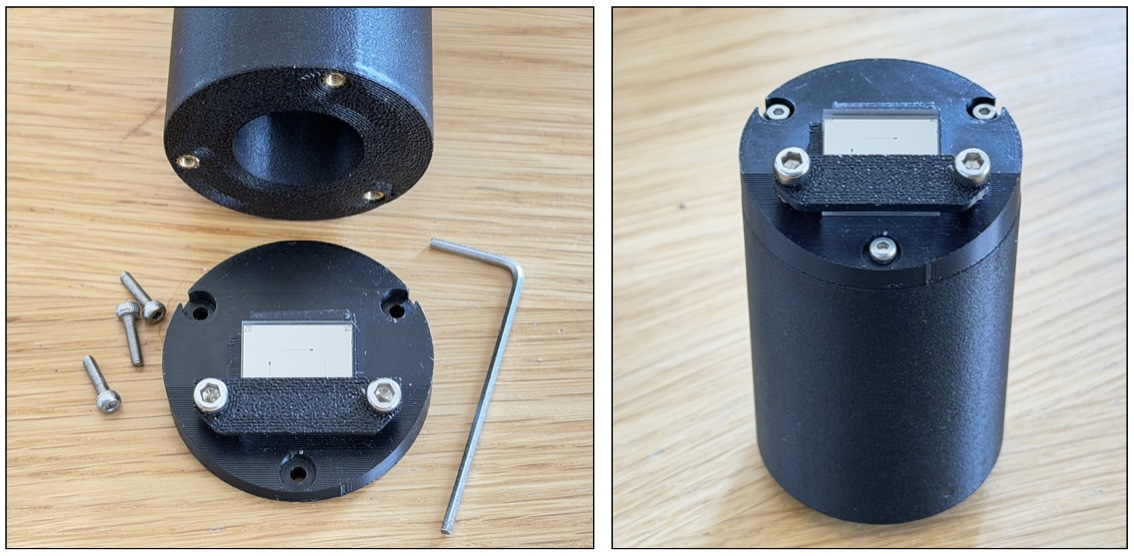
[picture p78: figure]

Figure 32. Fitting the slit holder to the collimator tube with three M2 × 8 mm screws. The collimator assembly is now complete.

### 9.5 The grating holder

The TSE spectrograph nominally uses a ruled grating of 300 lines/mm, 12.7 mm by 12.7 mm and 6 mm thick.

The holder for this grating is part 7-1-porte-reseau-127. Note, however, that TinyStar’Ex can also perfectly well accept the 25 mm by 25 mm, 300 lines/mm grating of the Star’Ex LR instrument, by using the 8-1-porte-reseau-250 holder.

The photographs in Figure 33 show the various inserts that complete the grating holder.

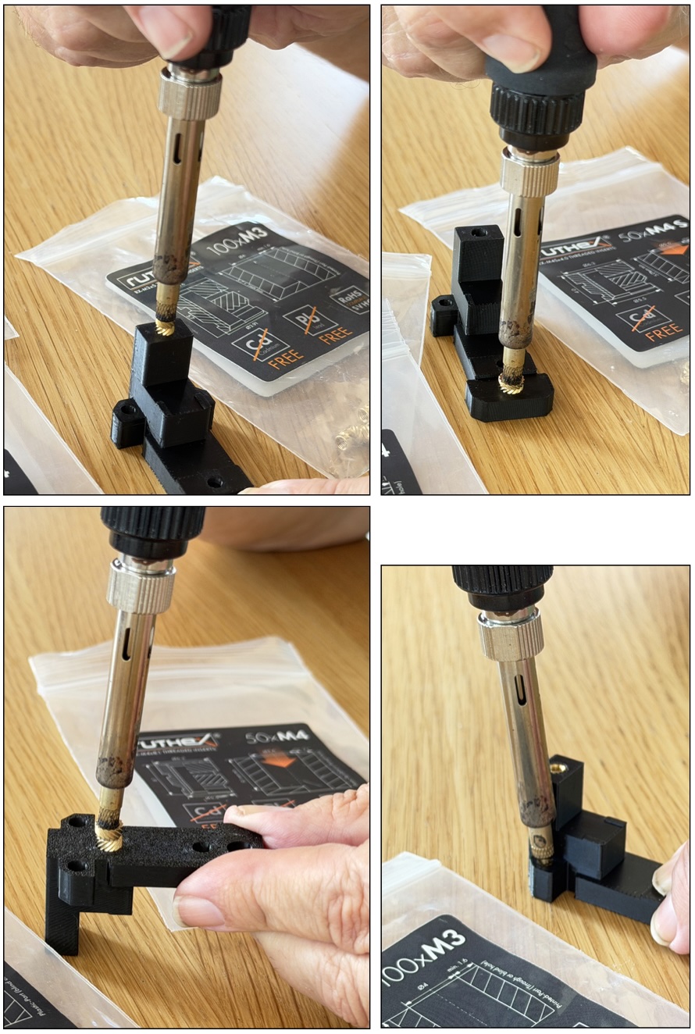
[picture p79: figure]

Figure 33. The grating holder requires several types of insert. Top left: an M3 insert; top right: a (short) M4 S insert; bottom left: an M4 insert; bottom right: three M3 inserts (the position of one of them is hidden by the ngers).

The views in Figure 34 show the grating holder tted with these inserts.

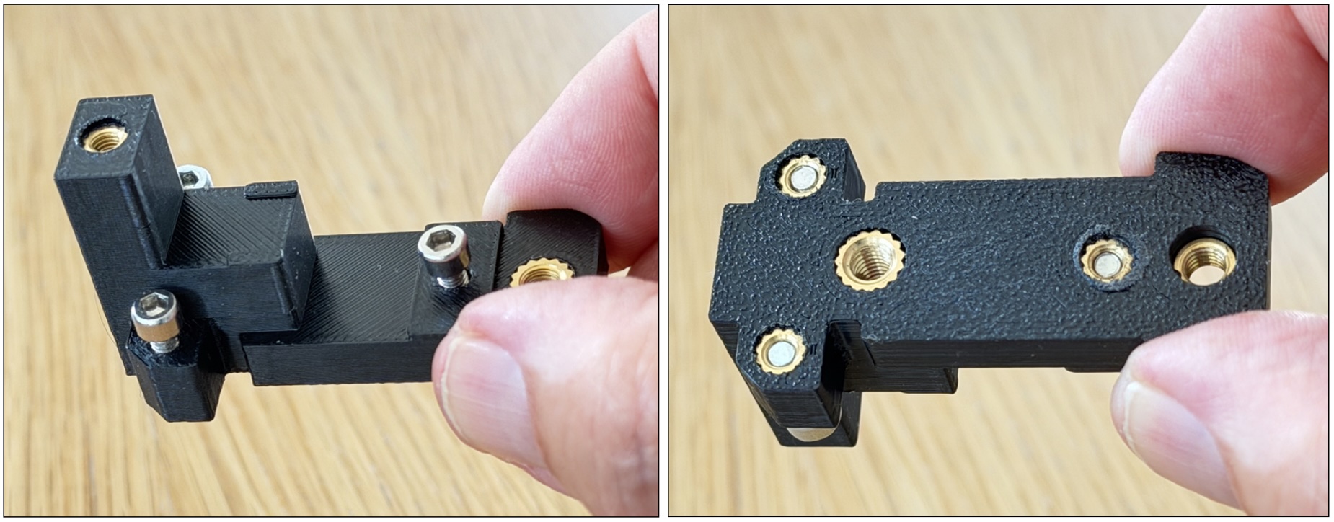
[picture p80: figure]

Figure 34. The grating holder ready to receive the grating. The three M3 × 10 mm screws visible in the left-hand photograph are used to correct any tilt of the grating plane.

### 9.6 Fitting the grating

The grating is the most fragile of all the optical parts. While the surfaces of the lenses or the slit can be wiped and cleaned, this is forbidden for the ruled face of the grating: the very ne grooves on it are damaged by the slightest rubbing. A golden rule: it is better to leave the surface of a grating dirty than to try to clean it. Despite these warnings, do not worry unduly: the assembly is simple and will go well if you are careful and aware of the precautions to take.

The photographs in Figure 35 show how to unpack the grating.

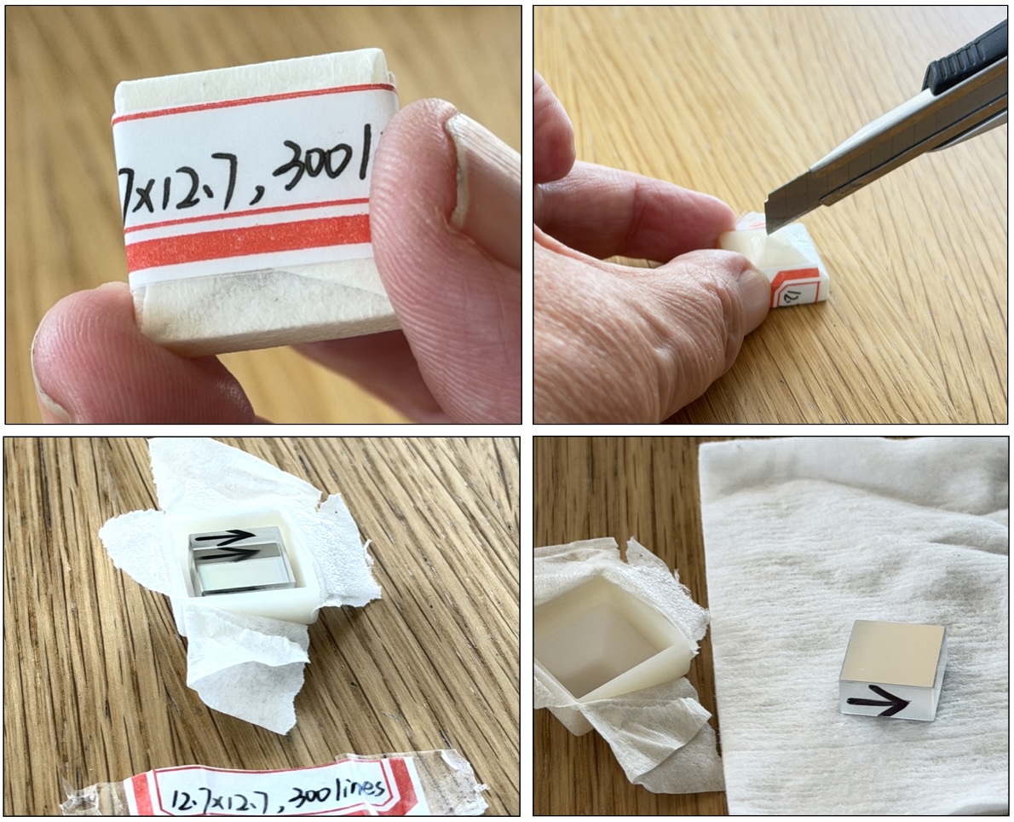
[picture p81: figure]

Figure 35. Top left: the grating in its box. Top right: a cut with a craft knife through the adhesive tape opens the packaging. Bottom left: the grating appears; the ruled face is opposite the one you see at this stage. This visible face is at and has no optical function: you can touch it, and even hold the grating in the palm of your hand by this face. Bottom right: turning the box over onto a sheet of cotton wool or lens tissue, you nally see the ruled face, recognisable by its shiny appearance. This is where you must be careful: no contact whatsoever with this surface.

Always pick up the grating by its edges, then place it in the seat provided for it in its holder (Figure 36).

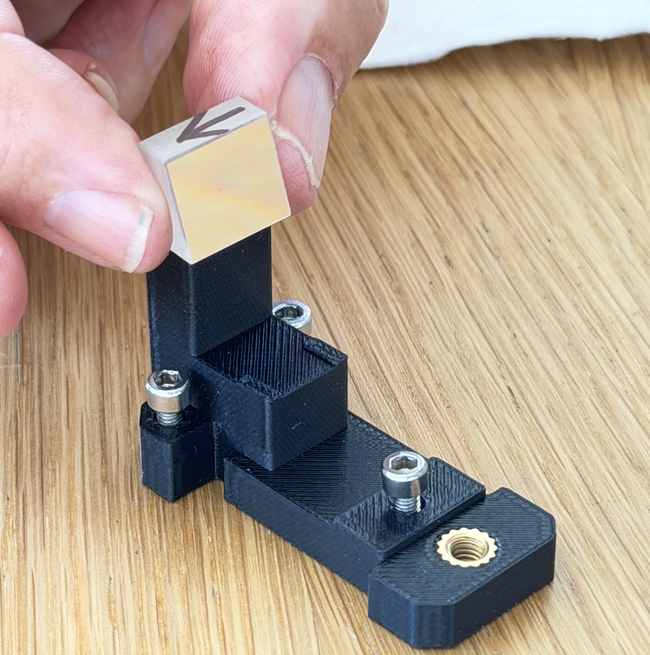
[picture p82: figure]

Figure 36. Handling the grating: always by its edges. You may wear gloves, but even with gloves, never touch the ruled face, the one that looks shiny to the eye.

In the left-hand photograph of Figure 37, the grating is in place. Note carefully that the ruled face faces outwards. Note also the orientation of the arrow drawn on the edge of the grating relative to the holder: it is essential to respect this orientation, as the eciency of your spectrograph depends on it (it allows you to benet from the blaze of the grating)³

The grating is held by the clamp 9-1-bride-reseau, xed with an M3 × 8 mm screw (right-hand photograph of Figure 37). This clamp has a small shoulder that holds the grating more securely: do not t it the wrong way round. Tighten without excess, then check, holding the grating by its edges, that it no longer moves and is properly centred. Also check that its back rests along its entire length against the upright of the holder. This is important, as the centring of the spectrum on the sensor that records it depends on it.

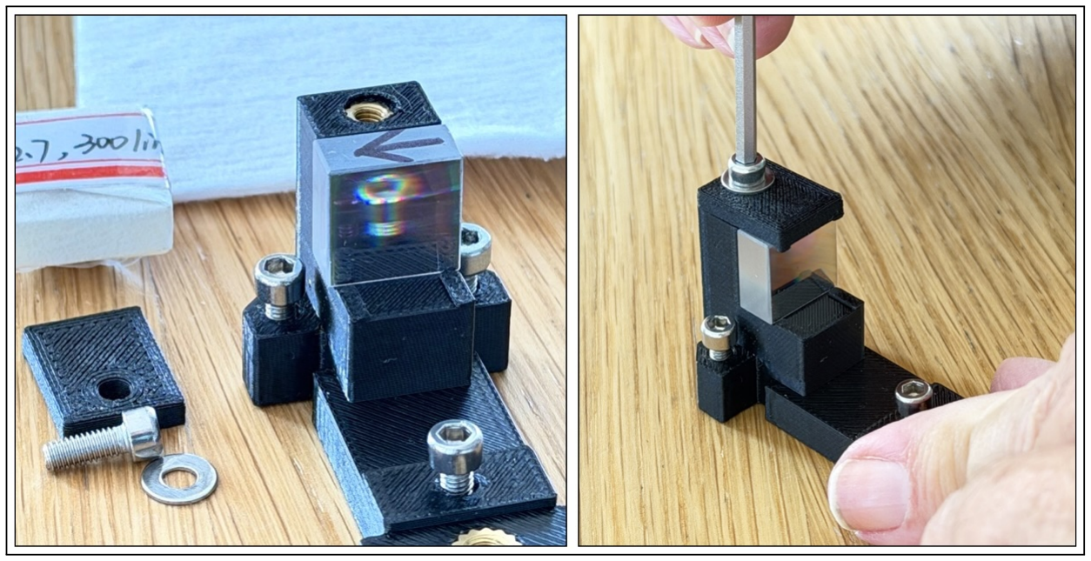
[picture p83: figure]

Figure 37. The grating positioned in its holder. A thin lip in the holder helps to keep the grating pressed against its rear face and secure in position. Note the direction of the arrow carefully (it is the orientation that matters, not the edge on which it is drawn). The grating clamp is in place (M3 × 8 mm screw). A small lip on part 9-1-bride-reseau also makes it easier to position the grating and holds it more rmly.

Check once more that the rear face of the grating is pressed rmly against the upright (Figure 38). If it is not, loosen the clamp and adjust the contact.

3
The arrow may sometimes be drawn on the opposite edge. It is then at the bottom, hidden by the grating holder. What matters, however, is still the orientation of the arrow, as shown in Figure 37.

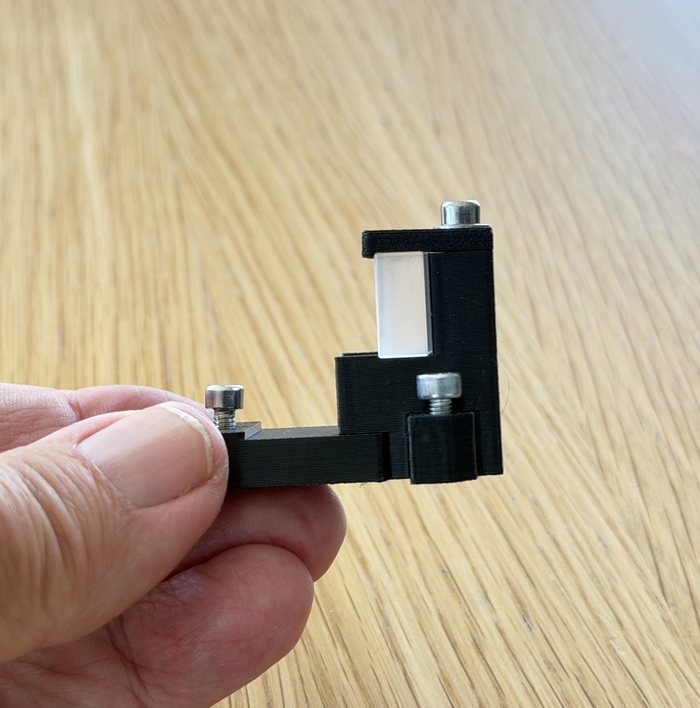
[picture p84: figure]

Figure 38. Checking that the grating is properly seated.

Fit part 10-1-interface-reseau with two M4 inserts and two M4 × 20 mm screws, which will provide the ne orientation of the grating (Figure 39).

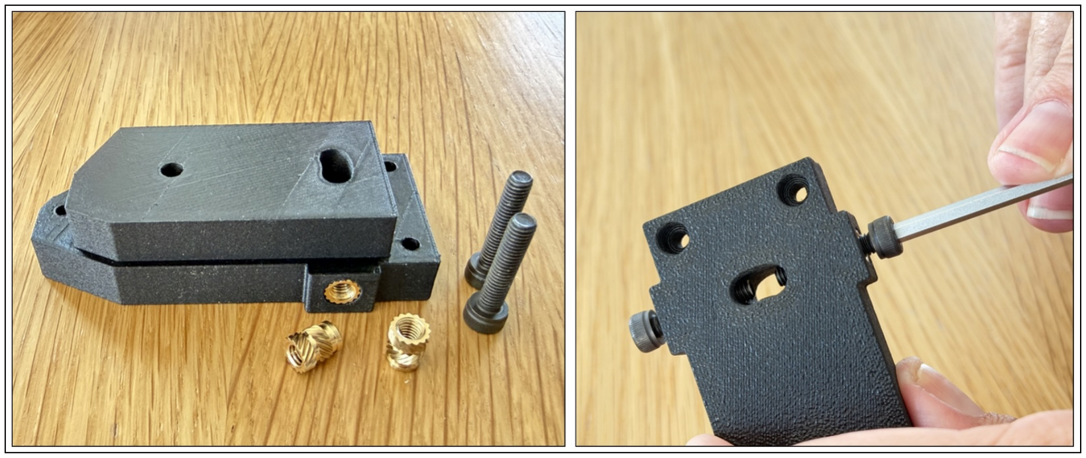
[picture p85: figure]

Figure 39. Completing part 10-1-interface-reseau: two M4 inserts to be tted and a pair of M4 screws 20 mm long.

Add an M4 screw 30 mm long to part 7-1-porte-reseau-127, as shown in Figure 40. Do this only after tting the grating: xing the grating is much easier without the protrusion formed by this long screw.

Reduce the risk of contact with the ruled surface of the grating by setting this assembly down as shown on the right of Figure 40.

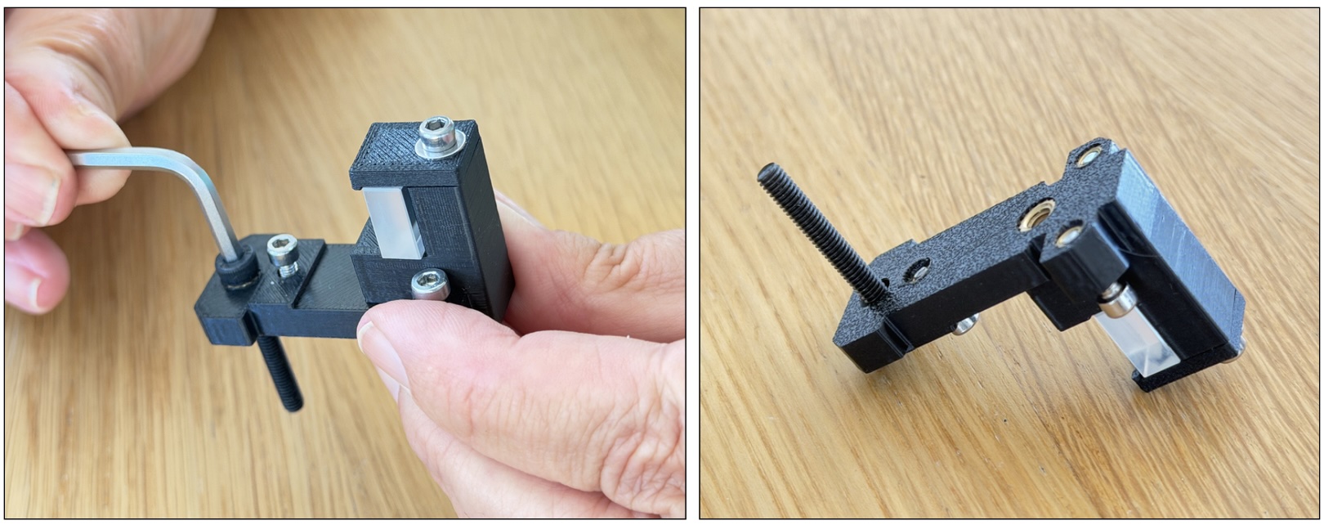
[picture p86: figure]

Figure 40. Left: adding an M4 screw 30 mm long to the grating holder. Tighten it rmly, as this screw acts as a stud for the ne adjustment of the grating. Always keep your movements measured, and never touch the front face of the grating. Right: how to set down the assembled grating holder, ruled face downwards for safety.

Attach the grating holder to its interface as shown in Figure 41. Then put this assembly aside, protected from dust and accidental contact.

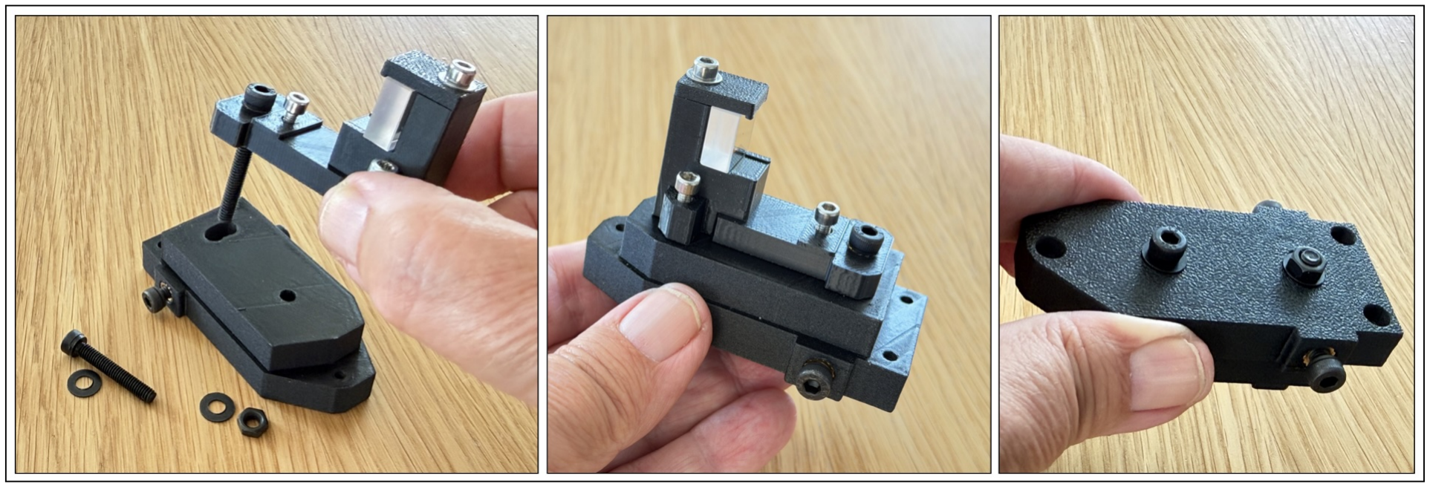
[picture p87: figure]

Figure 41. How to mount the grating holder on its interface. You will need an M4 screw 25 mm long, which acts as a pivot when the grating is rotated (the axis of this screw lies exactly in the plane of the ruled surface). You will also need an M4 nut (or, optionally, an M4 Nyloc nut, which will not work loose). Do not forget to use washers, to make adjustment easier and avoid damaging the plastic when tightening (always moderately).

### 9.7 Closing the housing

Screw the camera tube assembly rmly onto the camera itself via the T2 interface. Adjust the distance between the front of the camera tube and the mounting face of the camera (here a Player One Uranus-M Pro) as shown in Figure 42.

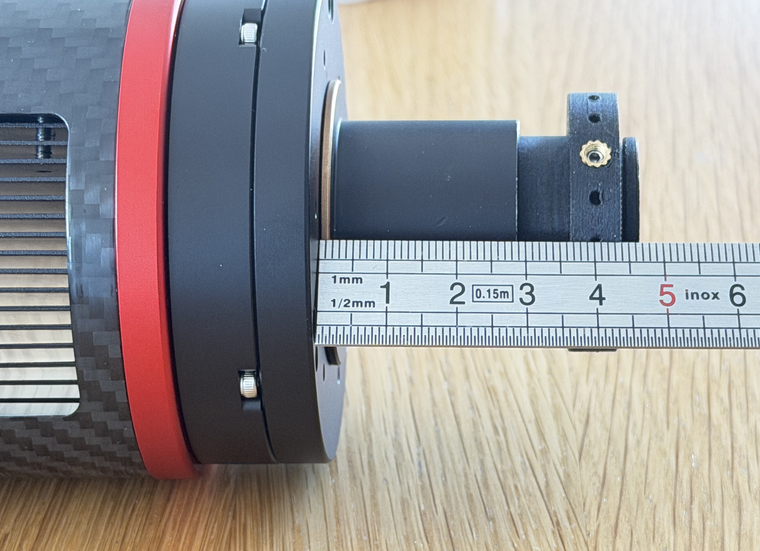
[picture p88: figure]

Figure 42. By screwing the camera tube in or out, adjust the distance between the mounting face of the camera (itself 17.5 mm from the detector, a standard dimension) and the front of the tube to about 44 mm.

Place the collimator and camera tubes in their seats in the lower part of the housing (see Figure 43).

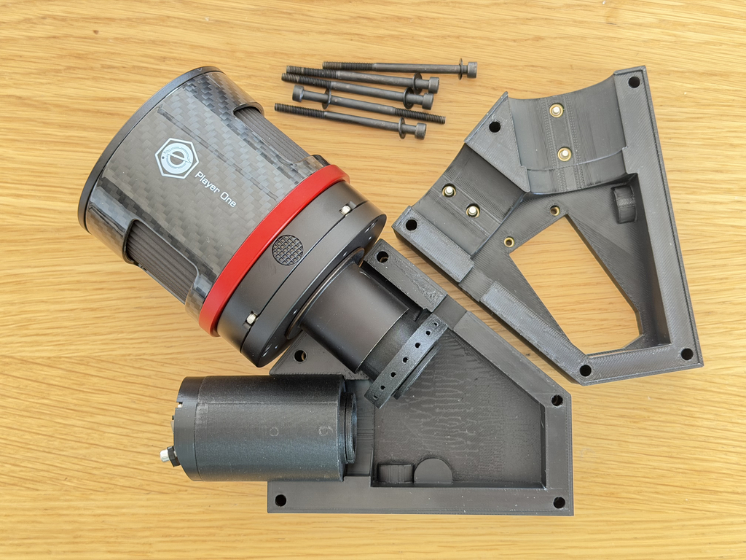
[picture p89: figure]

Figure 43. Positioning the components before closing the housing. You will need ve M4 screws 60 mm long, with their washers.

Fix the two shells of the housing together. Do not tighten the screws rmly at rst: the collimator and camera tubes must be able to turn freely in their seats, with only slight resistance.

As highlighted in Figures 44 and 45, make sure that the 31.75 mm barrel carrying the camera and the collimator tube are in contact with their longitudinal locating shoulders.

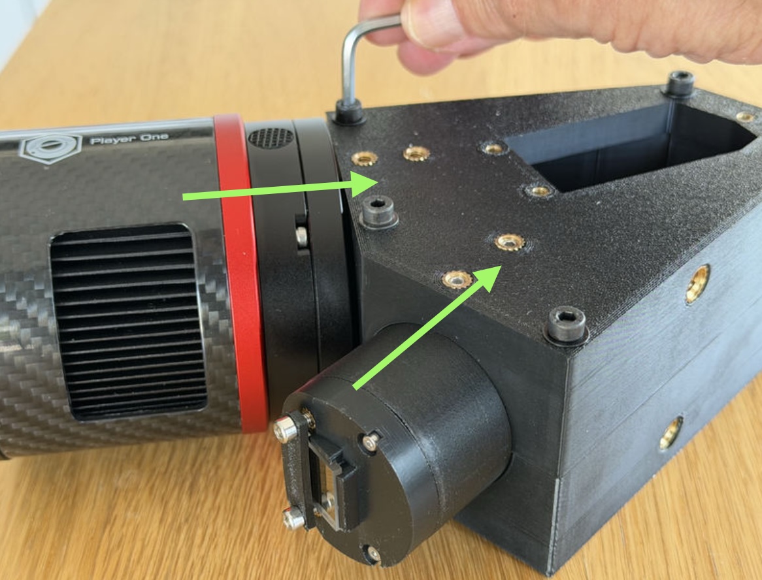
[picture p90: figure]

Figure 44. Assembling the two shells of the housing. It is important to push the components rmly in the direction of the green arrows, so that they bear against their shoulders and are therefore in their nominal positions. Note also the orientation of the collimator tube, using the slit holder as a reference: the inclined face points inwards.

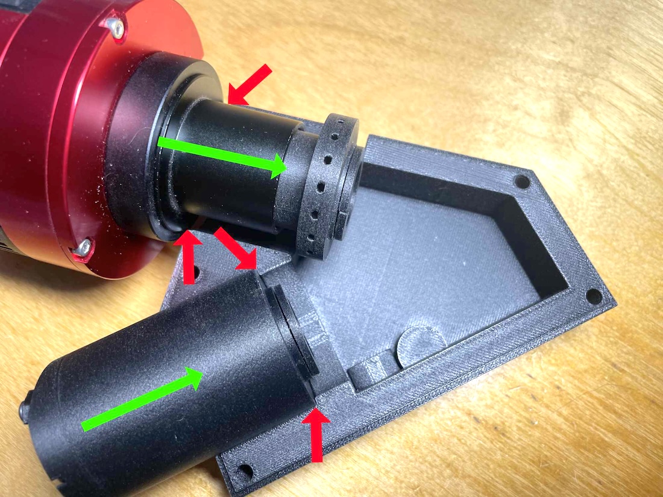
[picture p91: figure]

Figure 45. It is important that the sliding components sit properly on their mechanical bearing surfaces after the two shells have been assembled and tightened, including after a rotational adjustment (red arrows).

Next, t the grating assembly in its seat, which almost closes the TSE housing (Figure 46).

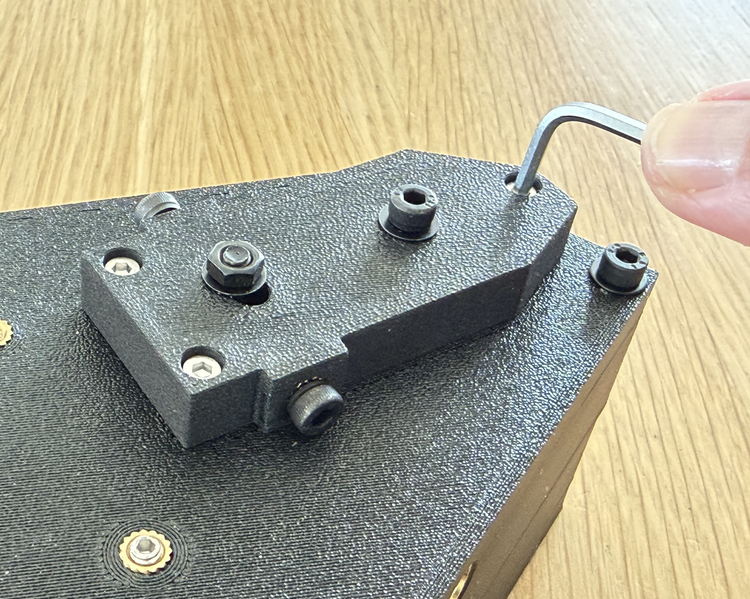
[picture p92: figure]

Figure 46. Fitting the grating interface, using three M3 screws 12 mm long.

## 10 Adjusting the spectrograph

### 10.1 The method

You can now record your rst spectrum with TinyStar’Ex. Daylight is all you need; clear weather gives more light, but this is not essential.

All the adjustments of the spectrograph are made using the solar spectrum. This has two great advantages: it is a natural source, available at any time of day, and its spectrum is crossed by numerous dark lines (the Fraunhofer lines) whose wavelengths are precisely known. These lines serve as references for focusing and for checking that the instrument is working correctly.

Everything is done without mounting the spectrograph on the telescope: it is simply placed on a table, and you aim at the sky through a window.

Do not point the spectrograph directly at the Sun: too bright and too small, it would illuminate the slit very unevenly, which is unsuitable for the adjustments. Aim instead at the blue sky, a bright cloud or a well-lit wall: the scattered light contains the solar spectrum we need.

Remember the essential point: most of the adjustments are made in daylight, without a telescope, calmly and in comfort. Once the instrument has been properly adjusted in this way, obtaining ne stellar spectra at night becomes much simpler, almost a formality.

### 10.2 Orienting the camera

Connect the camera to the computer with a USB cable and start your usual acquisition software. Take an exposure of a few tenths of a second, without saturating the image, with a gain of 200 (20 dB) and an oset of 20 (typical values for an Uranus camera). At rst the spectrum is blurred and wrongly oriented: this is normal, and we shall put it right. Carry out the adjustments in the order given below.

Begin by adjusting the orientation of the camera. Figure 47 shows what happens when this orientation is incorrect, and how to remedy it. Slightly loosen the screws joining the two shells of the housing, so that the camera can be turned in the 31.75 mm barrel with slight friction. Check the result live on the computer screen. With practice, you will be able to judge a tenth of a degree; but at this stage, an approximate adjustment is enough.

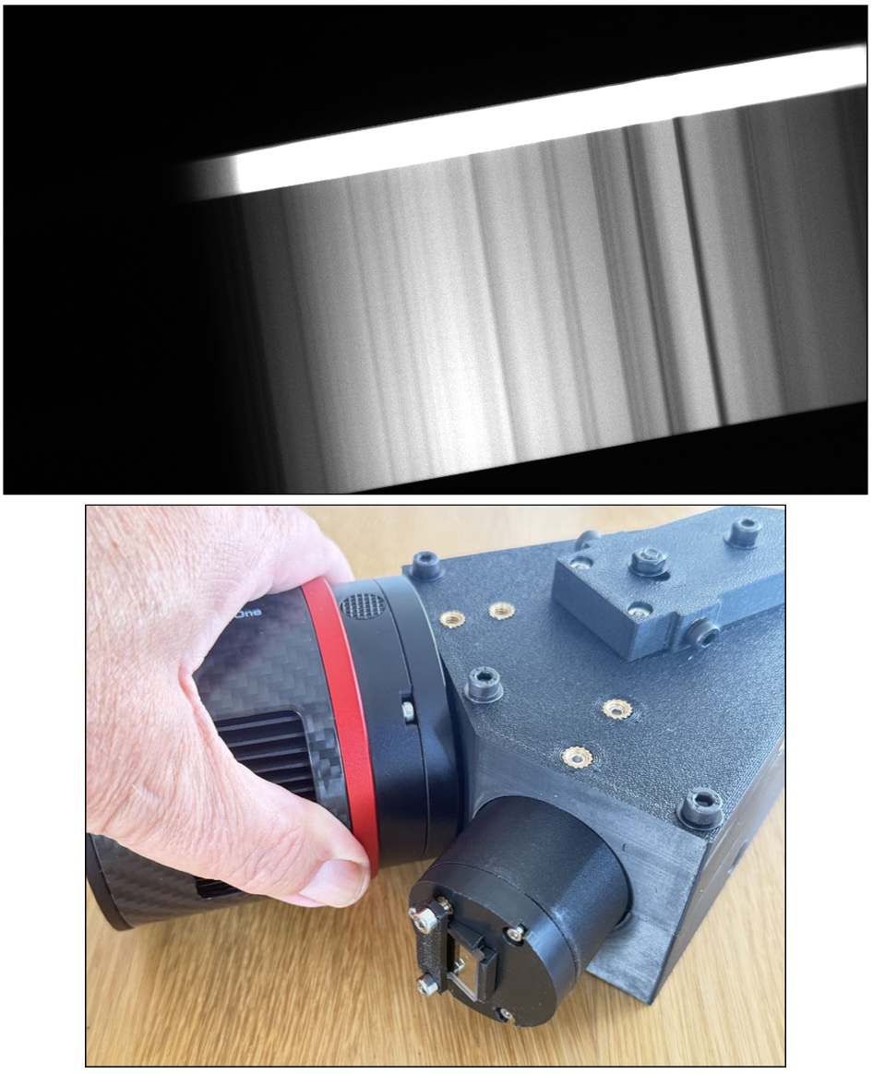
[picture p93: figure]

Figure 47. Orienting the camera to make the dispersion axis horizontal (also known as the tilt adjustment). In this view, the axis is steeply inclined: it is the line rising from left to right, which must be made parallel to the pixel rows of the sensor. Take advantage of this rst image to check that the blue end of the spectrum is on the left and the red end on the right. This is mandatory. If it is not the case, change the camera’s readout settings or rotate it through 180◦ .

You have now approximately aligned the dispersion axis of the spectrum with the pixel rows of the sensor.

### 10.3 Focusing the spectrum

At this stage, the lines of the solar spectrum are probably blurred, or even barely visible: the image of the spectrum is not yet correctly focused on the detector. To focus, turn the camera lens tube by trial and error, rst by half a turn, then by a quarter of a turn, and nally by two or three tenths of a turn (Figure 48). Depending on the direction of rotation, the lens moves forwards or backwards. You reach the adjusting ring through the hatch provided for the purpose: insert a ne screwdriver or an Allen key in the holes of the ring to turn the camera tube. You will no doubt turn it the wrong way at rst, but you will end up with a sharp spectrum.

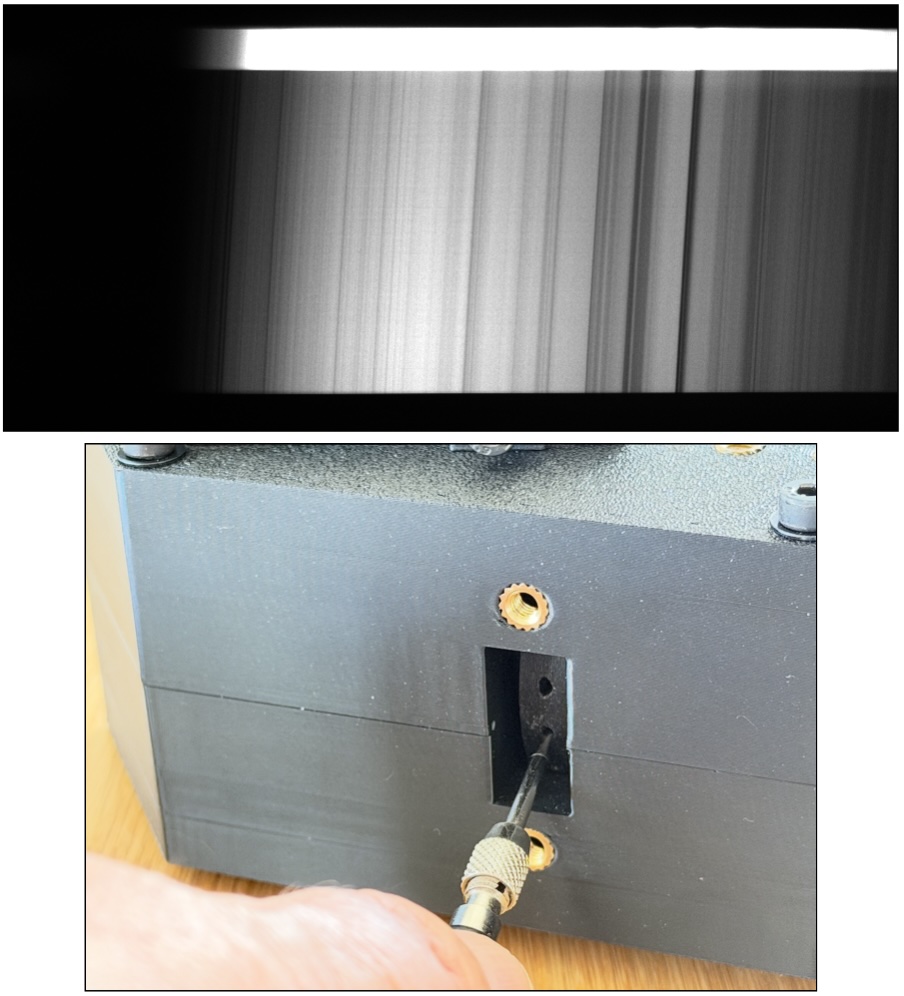
[picture p94: figure]

Figure 48. Adjusting the sharpness of the spectrum.

Once the spectrum is sharp, its upper and lower edges are clearly visible. Take this opportunity to rene the orientation of the camera so that these edges are as horizontal as possible. An error of 1◦
is too large: aim for an accuracy of a few tenths of a degree, which can be judged by eye by examining the spectrum along its whole length. Then lock the rotation of the camera by tightening, without excess, the two Teon-tipped thumbscrews of the 31.75 mm barrel. The residual angle between the dispersion axis and the pixel rows of the sensor is called the ‘tilt angle’.

### 10.4 Making the lines vertical

After adjustment, the spectral lines must be truly vertical, that is, perpendicular to the dispersion axis. The aim here is to correct their inclination relative to the columns of the detector, known as slant (Figure 49). This adjustment is made by rotating the collimator tube, after loosening the housing screws on the collimator side.

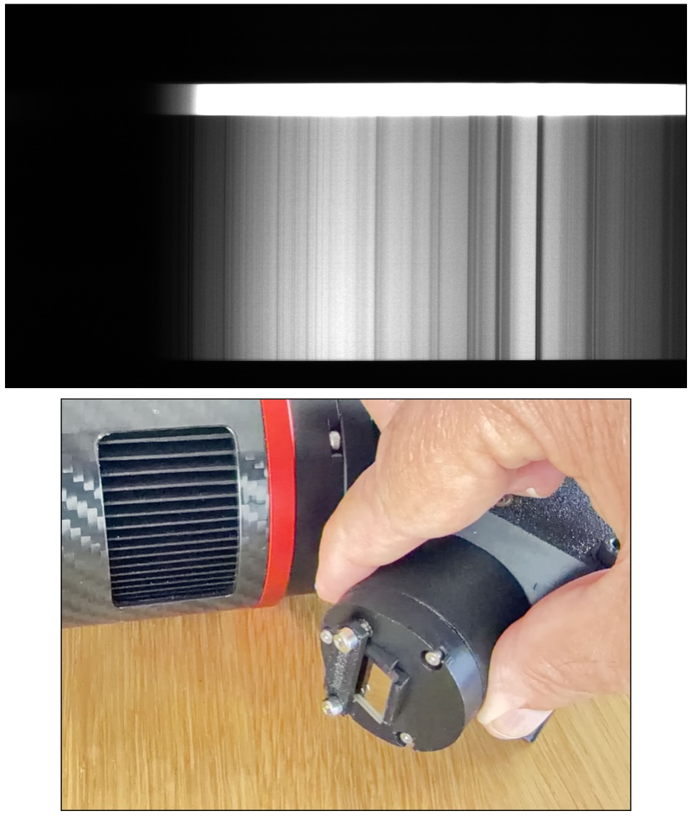
[picture p95: figure]

Figure 49. Adjusting the inclination of the spectral lines.

This adjustment is made by hand and calls for a light touch. Start a continuous acquisition loop and follow the result live on the spectrum image displayed on screen. Adjust the tightness of the screws so that the part turns with slight friction: it is then easier to handle and holds its position. Proceed by trial and error, and be patient. Normally, you will not need to repeat this adjustment.

If you cannot achieve satisfactory verticality by hand, use the small tools provided, the parts 1A-fourche-reglage and 2A-manette-reglage (adjustment fork et adjustment lever), as shown in gure 50.

The corresponding print les are gathered in a compressed archive, stl_outils.zip. (https://raw.githubusercontent.com/cbuil06/tse/main/stl_outils.zip) The associ-ated OpenSCAD le, TSE_sources_outils.scad, (https://raw.githubusercontent.com/cbuil06/tse/main/TSE_sources_outils.scad) can be downloaded in the same way.

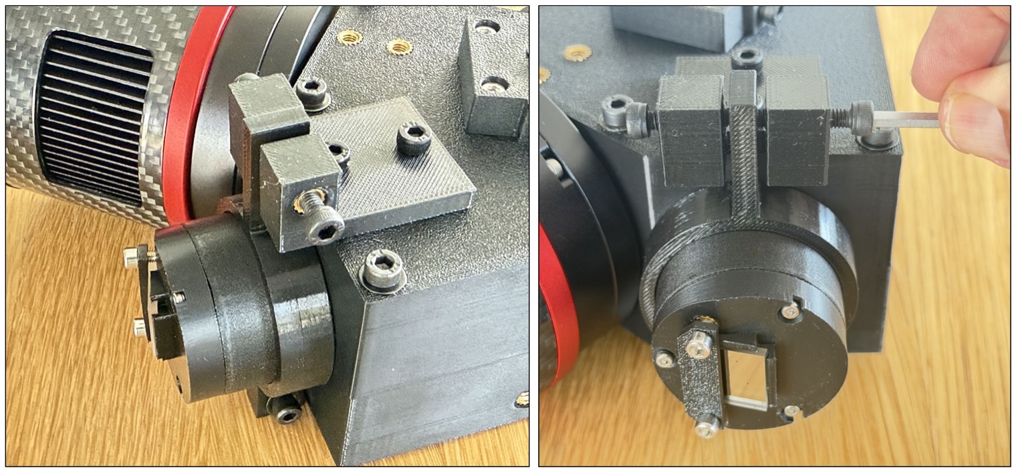
[picture p96: figure]

Figure 50. Tools to help rotate the collimator tube.

To work comfortably afterwards, both on the sky and during processing, aim for a slant error of less than a few tenths of a degree. An error of 1◦
is clearly visible if you take a good vertical reference in the image, and must be corrected.

### 10.5 Positioning the spectrum horizontally

The instrument only gives truly sharp lines if the spectrum is placed in the right position along the dispersion axis. First locate the Hα line (Figure 51).

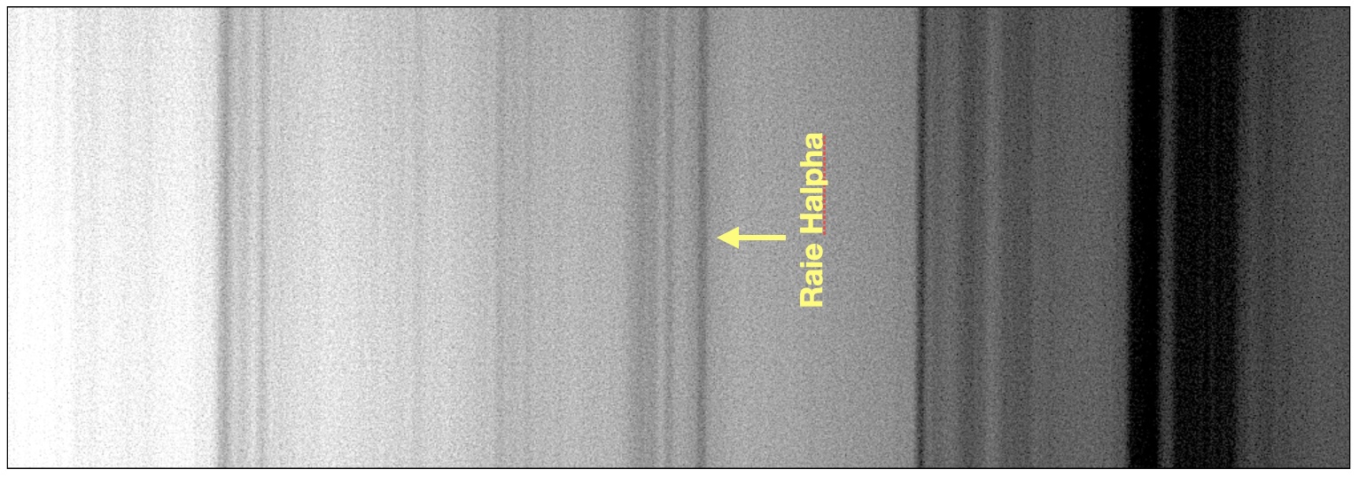
[picture p97: figure]

Figure 51. Locating the Hα line in this part of the solar spectrum.

With a camera tted with an IMX585 sensor, this line should lie 2450 pixels from the left-hand edge of the image, to within ±50 pixels. It is normal for the spectrum then to appear shifted to the right: this is the position in which you will obtain the best results. To move the red hydrogen line horizontally, and with it the whole spectrum, rotate the grating about an axis lying in its plane, as shown in Figure 52. Once the position has been reached, retighten the two M4 screws moderately.

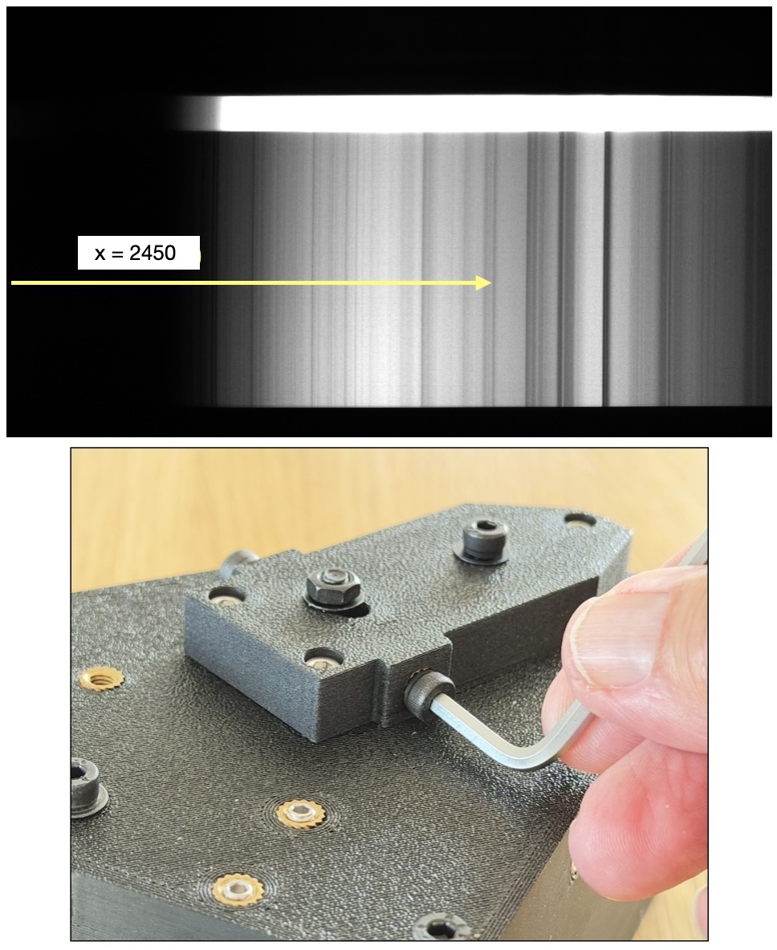
[picture p98: figure]

Figure 52. Fine rotation of the grating to position the spectrum on the sensor. First slightly loosen the M4 pivot screw and the nut of the adjusting rod (the screw that passes right through the instrument). Then use the two screws that push the arm of the grating holder: they work in opposition. The case shown in this gure corresponds to the use of a Sony IMX585 sensor.

Suppose the sensor of your camera has L pixels along its longer dimension, and that its pixels measure p µm. The Hα line of the solar spectrum (daylight) should then be placed at the position:

x =

L
2

+

1514
p

(in pixels).

Take the example of a camera tted with a Sony IMX533 sensor: L = 3008 pixels and p = 3.76 µm, giving x = 3008/2 + 1514/3.76 ≈ 1907 pixels, to within ±50 pixels.

### 10.6 Centring the spectrum vertically

If the spectrum is not suciently centred vertically in the image, use the levelling screws of the grating holder (Figure 53). Proceed by trial and error to nd the direction and extent of the adjustment.

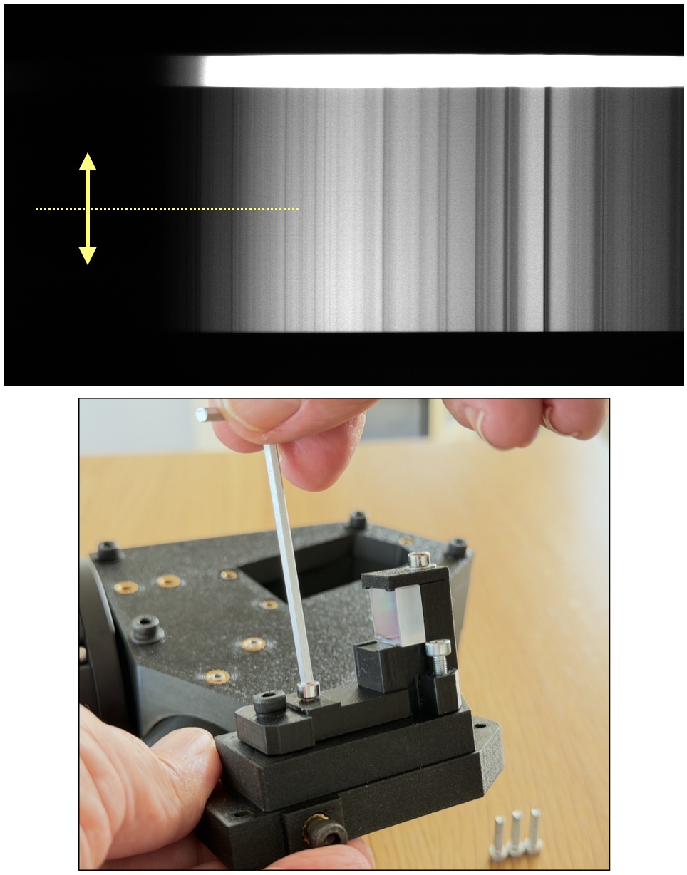
[picture p99: figure]

Figure 53. Adjusting the vertical position of the spectrum. Do not force the part: rst loosen its xing screws on the interface to give a little play.

### 10.7 Finishing touches

Tighten all the screws joining the two shells of the housing, and also, moderately, the locking screws of the collimator and camera tubes (Figure 54).

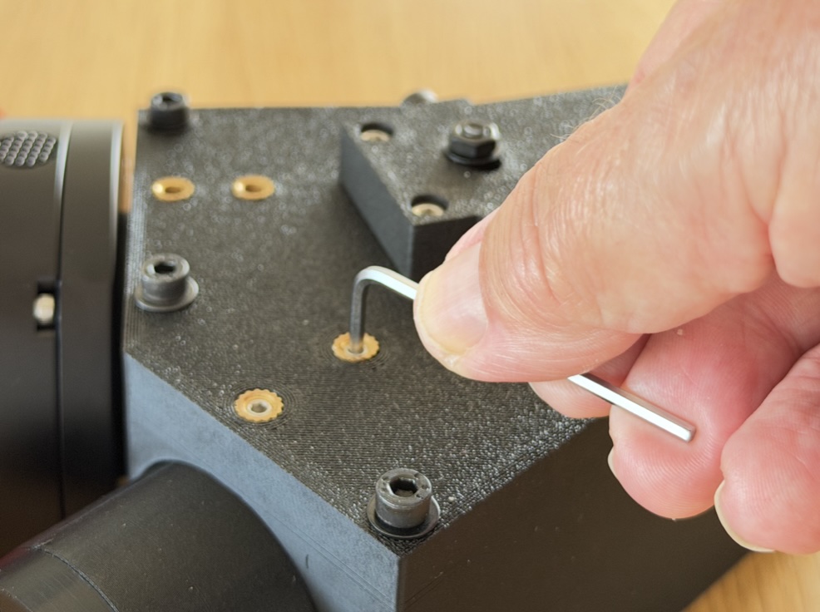
[picture p100: figure]

Figure 54. Final tightening of the Teon-tipped grub screws.

Finish closing the housing by tting part 13-1-trappe-focus (Figure 55). It opens easily if, when observing stars, the focus of the spectrum proves inadequate. This is the only adjustment of the spectrograph that may need to be repeated on the telescope, and it is a simple one.

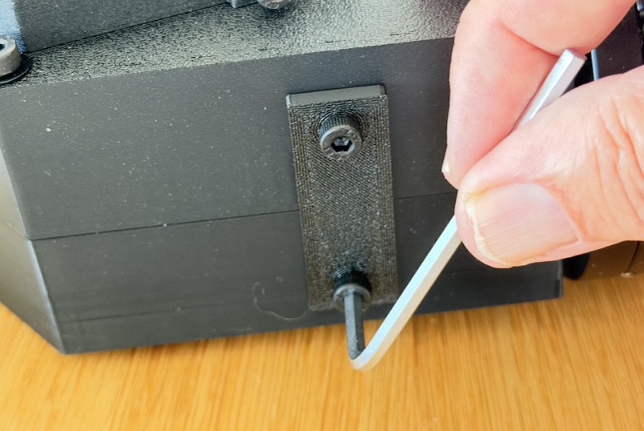
[picture p101: figure]

Figure 55. Closing the access to the focus adjustment (two M4 × 8 mm screws).

You have now completed the construction and assembly of the spectrograph itself. One last step remains before you can capture the spectra of celestial objects: building and tting the system for pointing at the slit.

In the end, the spectrograph will look like the one shown in Figure 56.

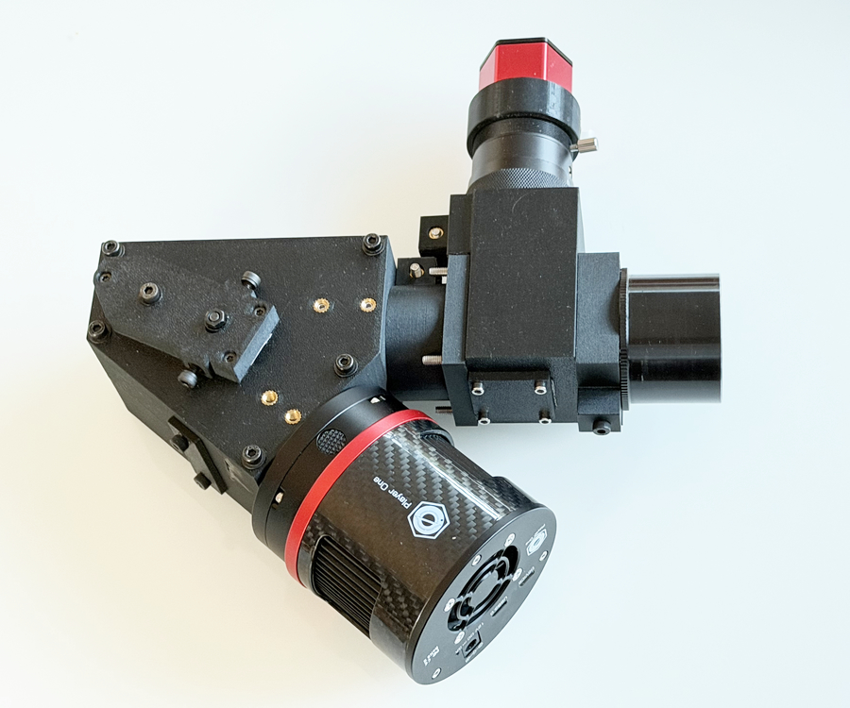
[picture p102: figure]

Figure 56. The complete TinyStar’Ex spectrograph, tted with its pointing and guiding system.
